widjis/rgb-sleep-lamp/electronic-design/revisions/1/HEADER-PINOUT.txt

Expansion headers - 2026-10-26

{
  "J6": [
    "BOOT_GPIO0",
    "GPIO2",
    "GPIO4",
    "GPIO5",
    "GPIO12",
    "GPIO13",
    "GPIO14",
    "GPIO15"
  ],
  "J7": [
    "GPIO16",
    "ADC",
    "ESP_EN",
    "RESET_N",
    "UART_TX",
    "UART_RX",
    "+3.3V",
    "GND"
  ]
}

Both headers 1x08,2.54mm. Pin1 is square PCB pad. J6 pin1 is GPIO0.
J7 TX/RX names are from ESP perspective: external TX connects to UART_RX.
GPIO0/2/15 are boot straps: external peripherals must preserve required reset levels.
ADC is native ESP8266 ADC input, nominal full scale1.0V; no divider/protection added. UART/GPIO logic3.3V.
GPIO6-11 /CS0,MISO,MOSI,SCLK,GPIO9,GPIO10 remain internal flash signals, not exposed.
+3.3V on J7 is regulated rail; do not feed battery/5V or a second active supply into it.
Native-save both sheets,ERC0warnings0errors,pad/netmapping verified42footprints; preserved40originalpositionsand0tracks.
DRC retains2pre-existing U1 silkscreen/edge violations;97unrouteditems expected. No new header geometry violations.
Existing donor footprint and power/thermal limitations remain.
