widjis/rgb-sleep-lamp/electronic-design/revisions/4/fabrication/20261030-E4/review/drill-report.txt

Drill report for circuit.kicad_pcb
Created on 2026-10-30T22:11:47

Copper Layer Stackup:
    =============================================================
    L1 :  F.Cu                      front
    L2 :  B.Cu                      back

Drill file 'circuit-PTH.drl' contains
    plated through holes:
    =============================================================
    T1  0.600mm  0.0236"  (34 holes))
    T2  0.800mm  0.0315"  (4 holes))
    T3  1.000mm  0.0394"  (24 holes))
    T4  1.150mm  0.0453"  (4 holes))
    T5  1.200mm  0.0472"  (3 holes))

    Total plated holes count 69

Drill file 'circuit-NPTH.drl' contains
    unplated through holes:
    =============================================================
    T1  3.200mm  0.1260"  (3 holes))

    Total unplated holes count 3
