widjis/rgb-sleep-lamp/documentation/attachments/0b8d95f3621441ebba49acbfaca555f7.png

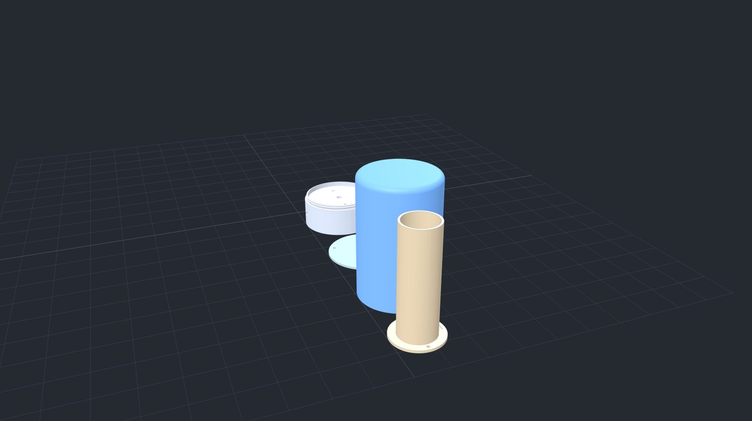
documentation/attachments/0b8d95f3621441ebba49acbfaca555f7.png
