widjis/rgb-sleep-lamp/documentation/attachments/3bc8e283bf60432a83f4a50ec003262f.png

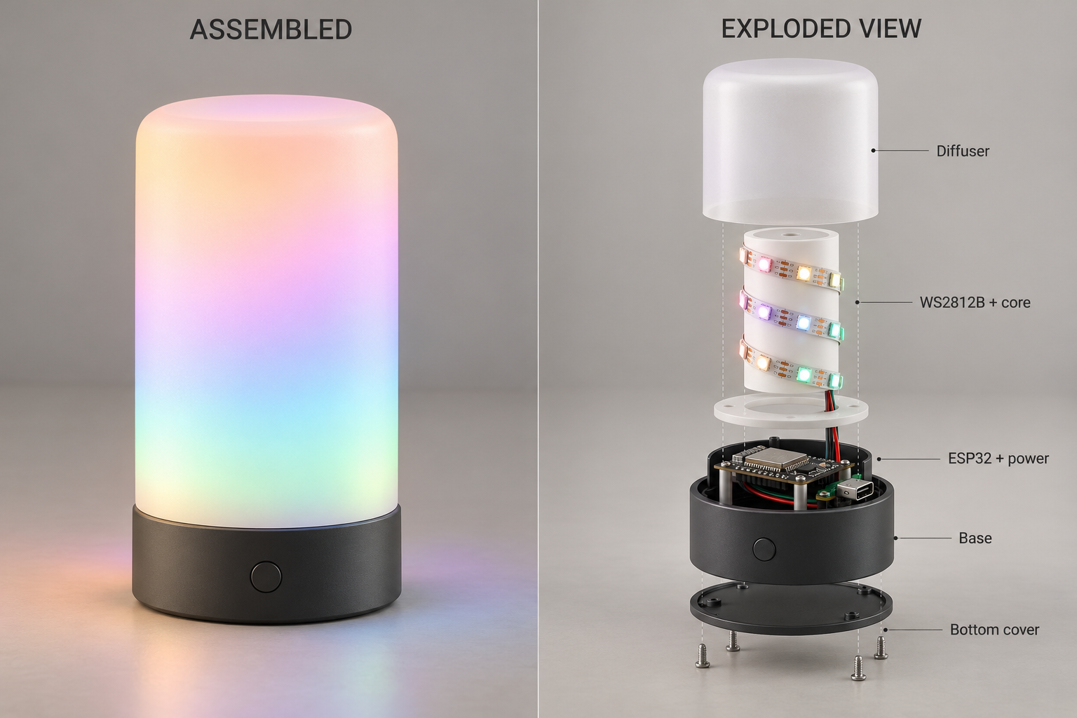
documentation/attachments/3bc8e283bf60432a83f4a50ec003262f.png
