widjis/rgb-sleep-lamp/documentation/attachments/4e88c0c15cba410885349178ead8f457.png

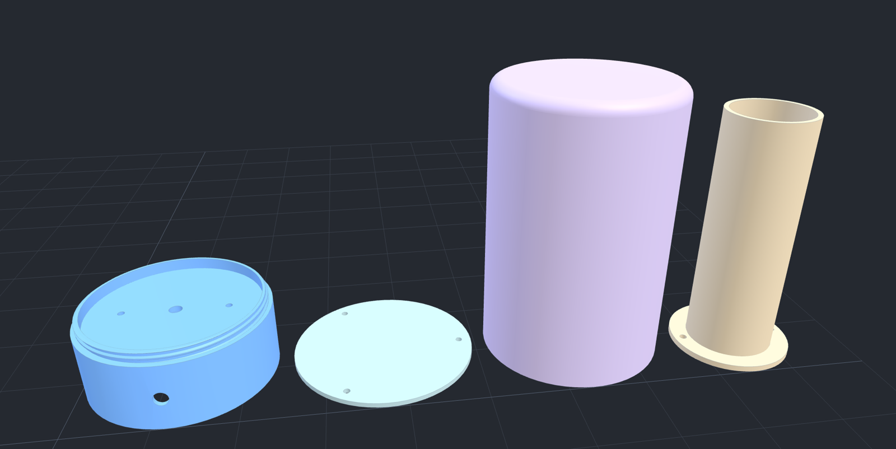
documentation/attachments/4e88c0c15cba410885349178ead8f457.png
