widjis/rgb-sleep-lamp/documentation/attachments/6b8971b305ce40e88919e2f2e205ed5f.png

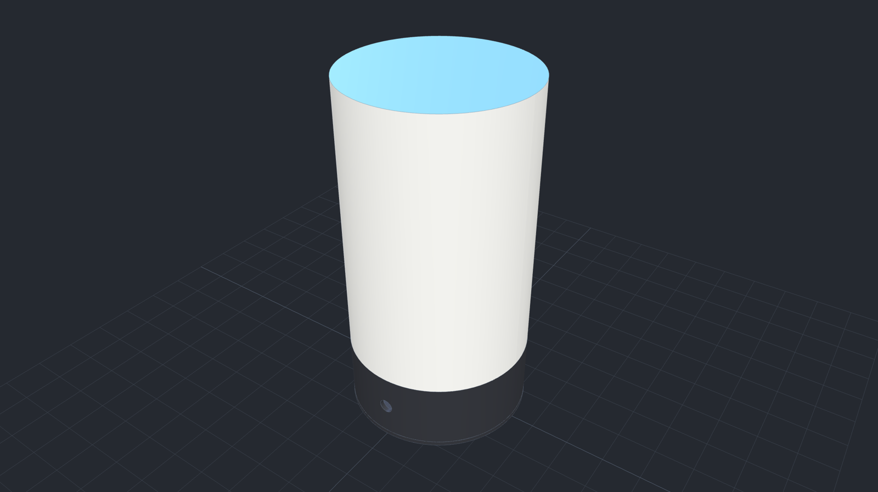
documentation/attachments/6b8971b305ce40e88919e2f2e205ed5f.png
