widjis/rgb-sleep-lamp/documentation/attachments/38d6d0ee4d35420595f7a81d190b29fc.png

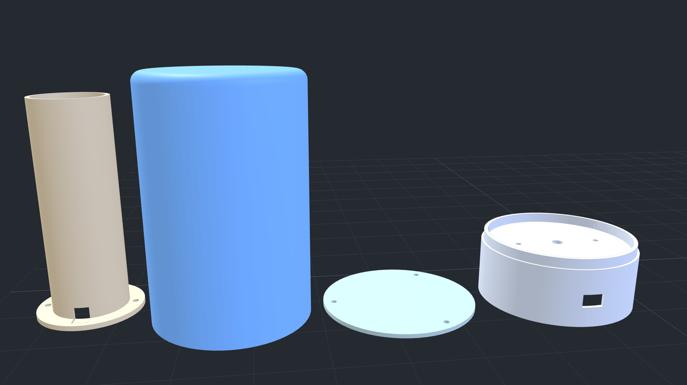
documentation/attachments/38d6d0ee4d35420595f7a81d190b29fc.png
