widjis/rgb-sleep-lamp/documentation/attachments/47f0a28b433d42219f5dcdfafbd3d39e.png

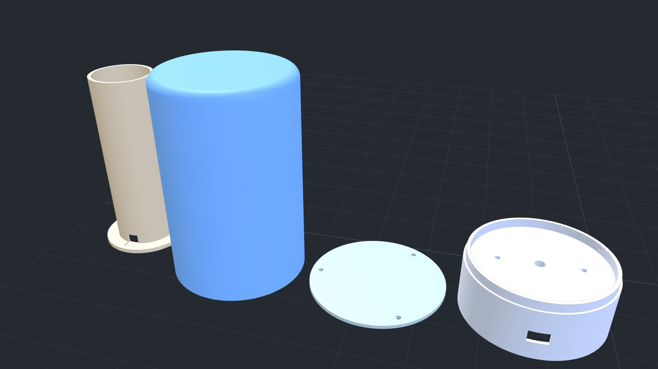
documentation/attachments/47f0a28b433d42219f5dcdfafbd3d39e.png
