widjis/rgb-sleep-lamp/documentation/attachments/359af76d811147eabba4ed6af1c6f636.png

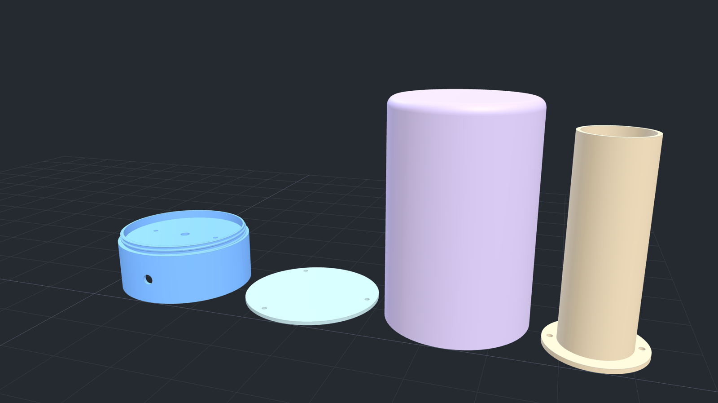
documentation/attachments/359af76d811147eabba4ed6af1c6f636.png
