widjis/rgb-sleep-lamp/documentation/attachments/012442a0ce6f4eaabcbf1c611c599270.png

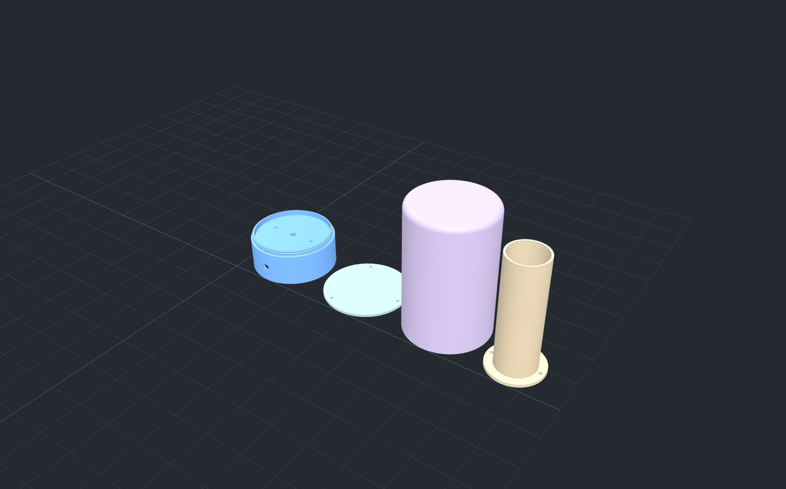
documentation/attachments/012442a0ce6f4eaabcbf1c611c599270.png
