widjis/rgb-sleep-lamp/documentation/attachments/bc02a46fa71b4df2939bb1dc65fdb123.png

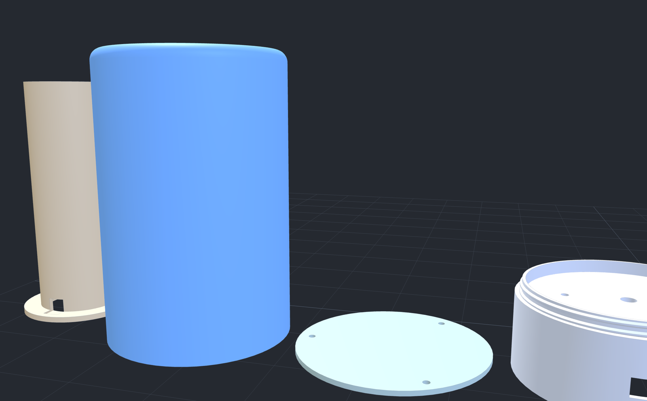
documentation/attachments/bc02a46fa71b4df2939bb1dc65fdb123.png
