widjis/rgb-sleep-lamp/documentation/attachments/ce138700706f45a0bd5461e80fa7ac32.png

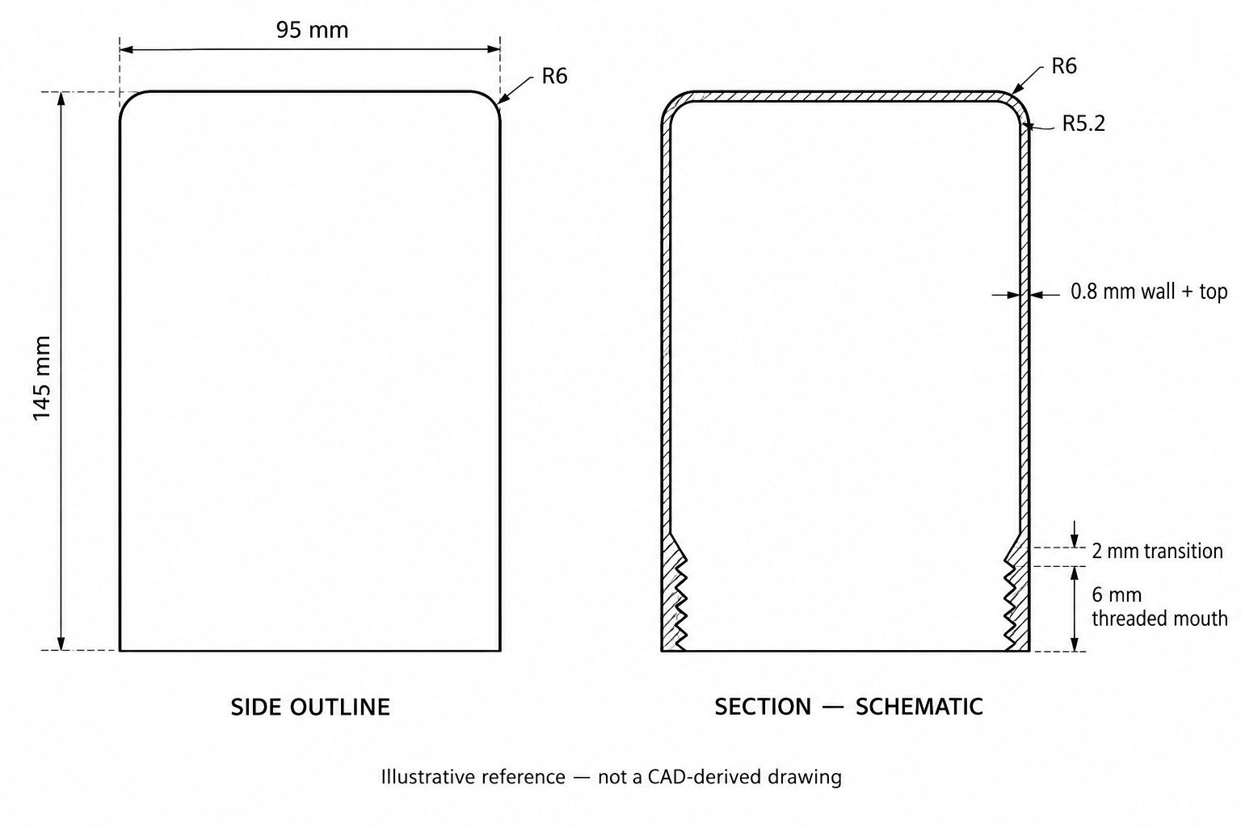
documentation/attachments/ce138700706f45a0bd5461e80fa7ac32.png
