widjis/rgb-sleep-lamp/documentation/attachments/d6e5daed313f4155918ada291e81fe91.png

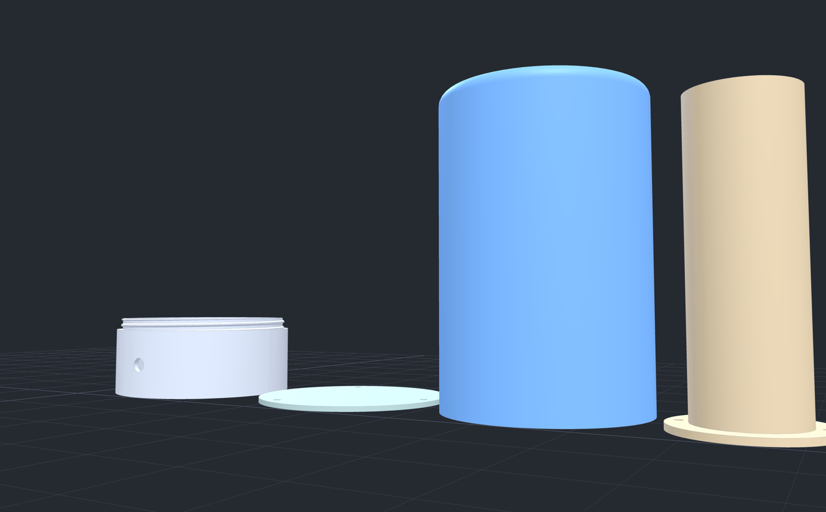
documentation/attachments/d6e5daed313f4155918ada291e81fe91.png
