widjis/rgb-sleep-lamp/documentation/attachments/fecc856e2a63408f98bc8c1cb8a409b4.png

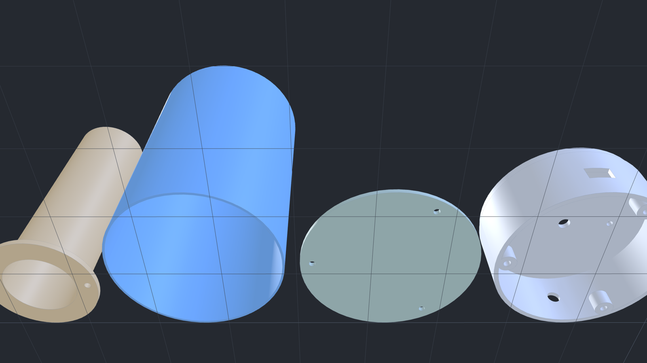
documentation/attachments/fecc856e2a63408f98bc8c1cb8a409b4.png
