widjis/rgb-sleep-lamp/documentation/checks/r9-pcb-and-led/pcb-layout-preview.svg.png

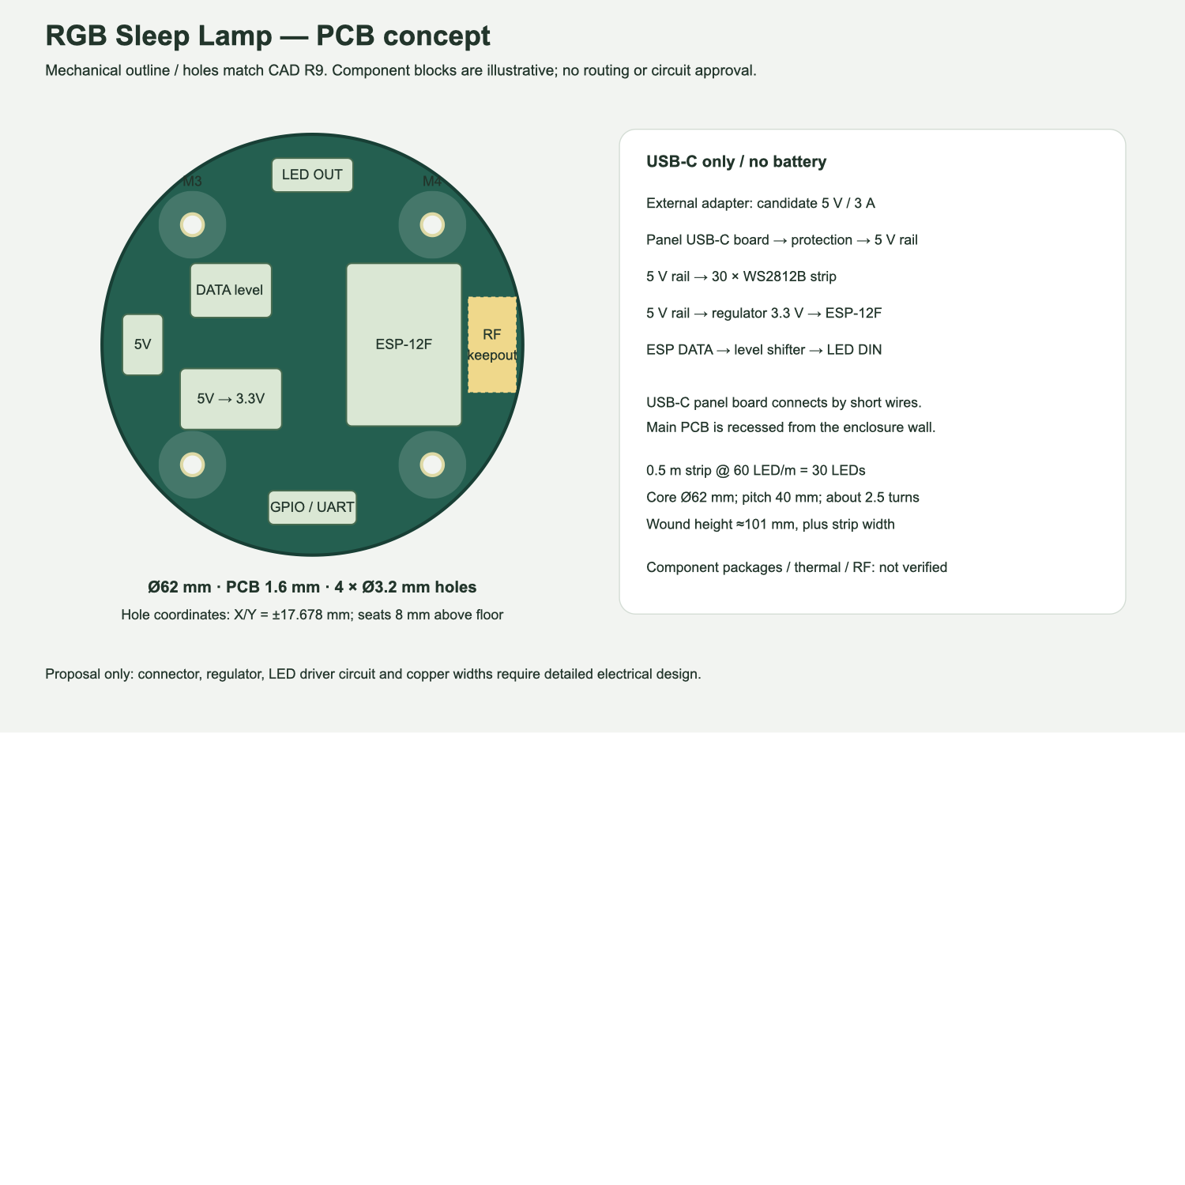
documentation/checks/r9-pcb-and-led/pcb-layout-preview.svg.png
