widjis/rgb-sleep-lamp/electronic-design/revisions/2/schematic-1.png

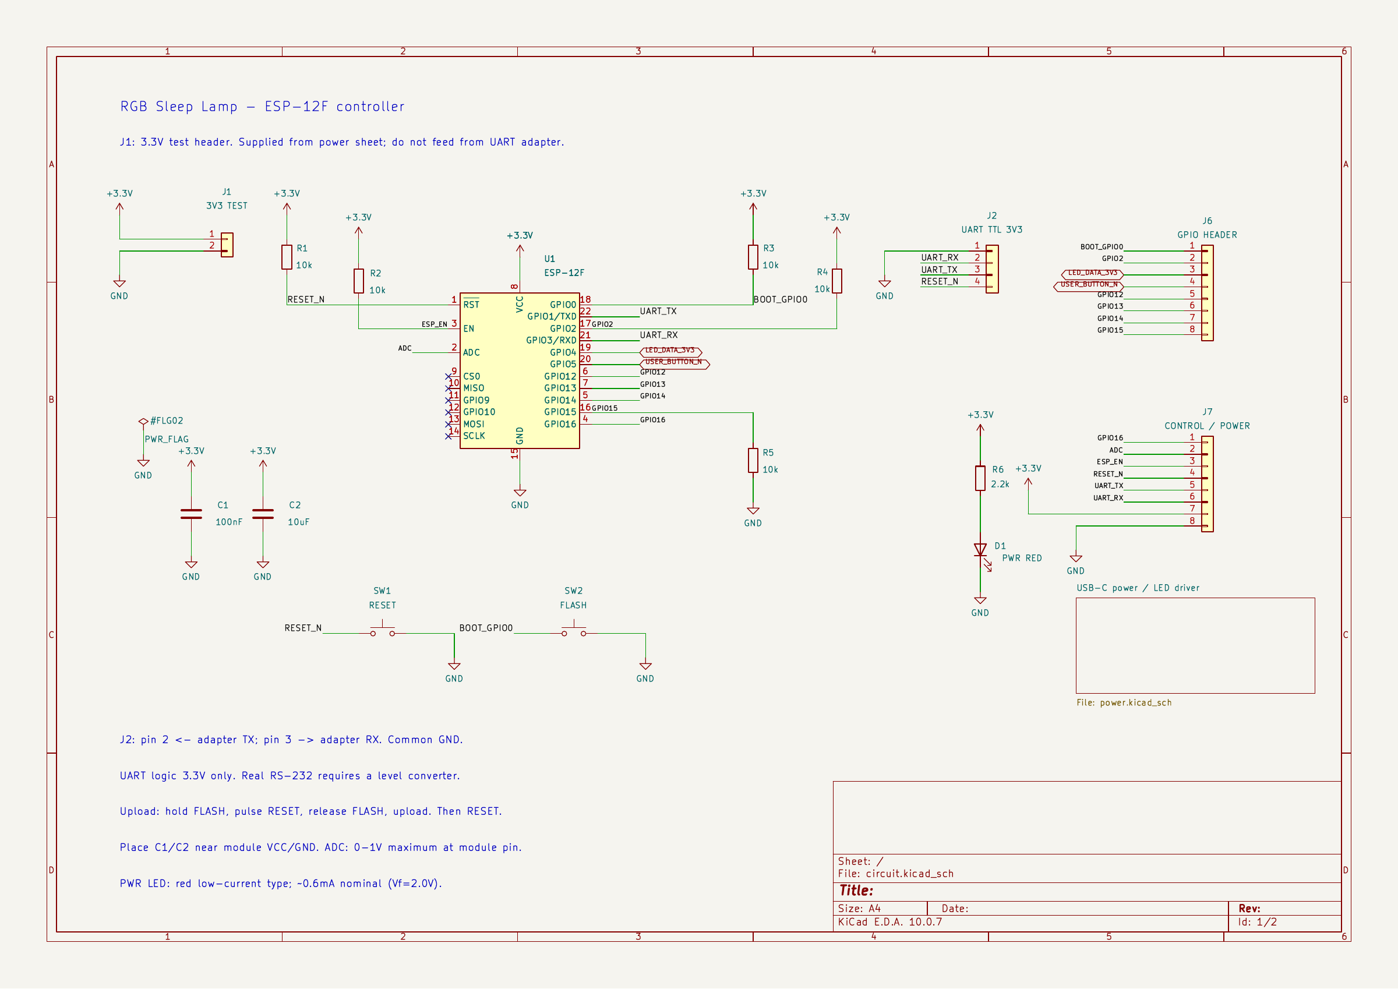
electronic-design/revisions/2/schematic-1.png
