widjis/rgb-sleep-lamp/electronic-design/revisions/2/schematic-2.png

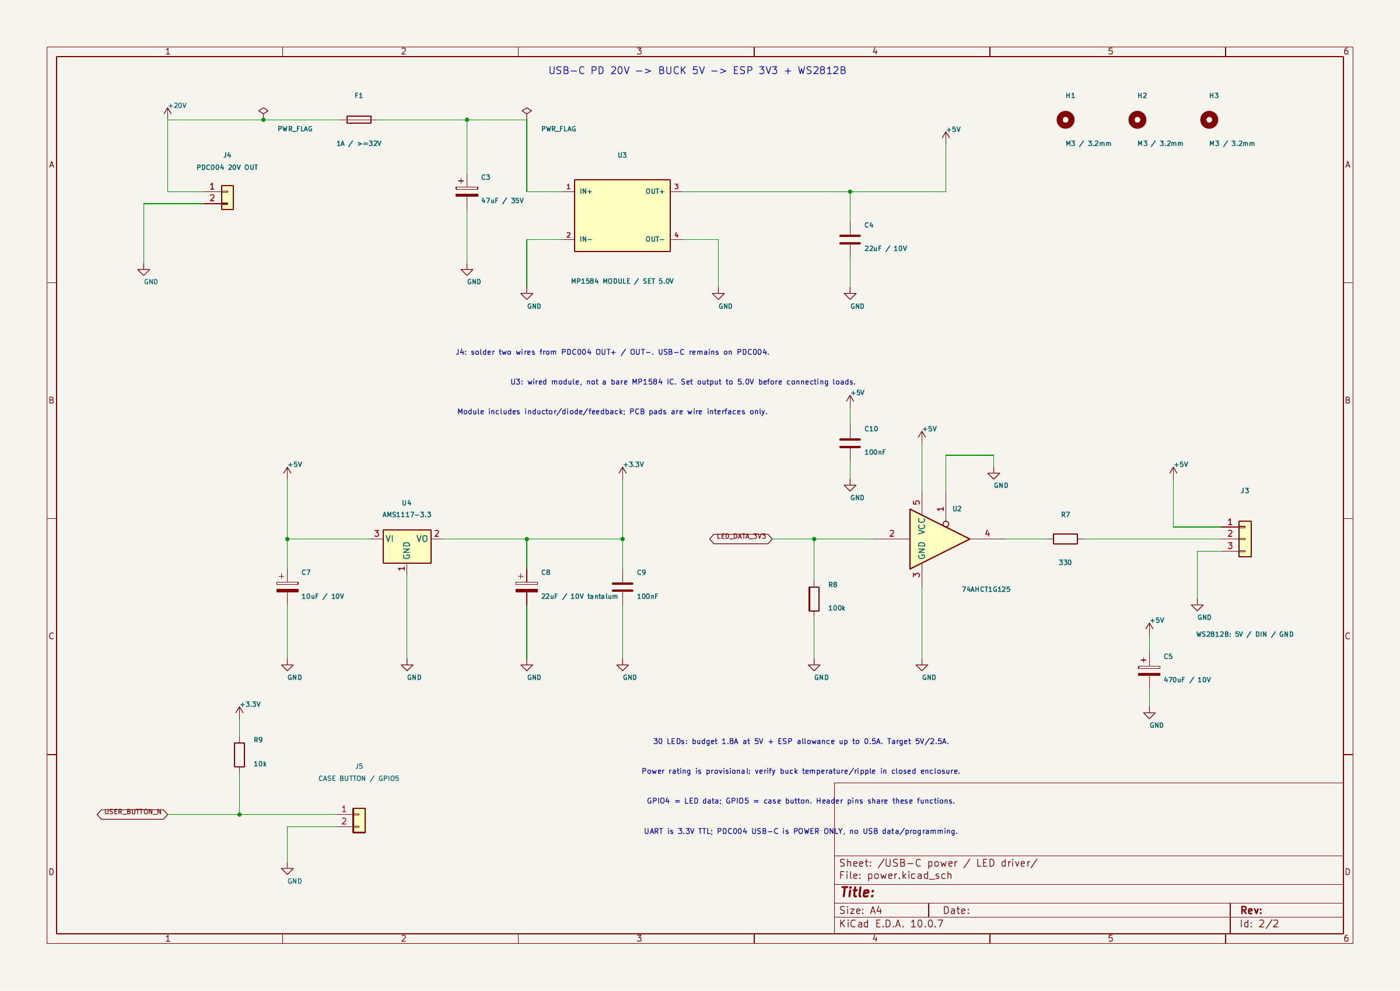
electronic-design/revisions/2/schematic-2.png
