widjis/rgb-sleep-lamp/electronic-design/revisions/3/schematic-1.png

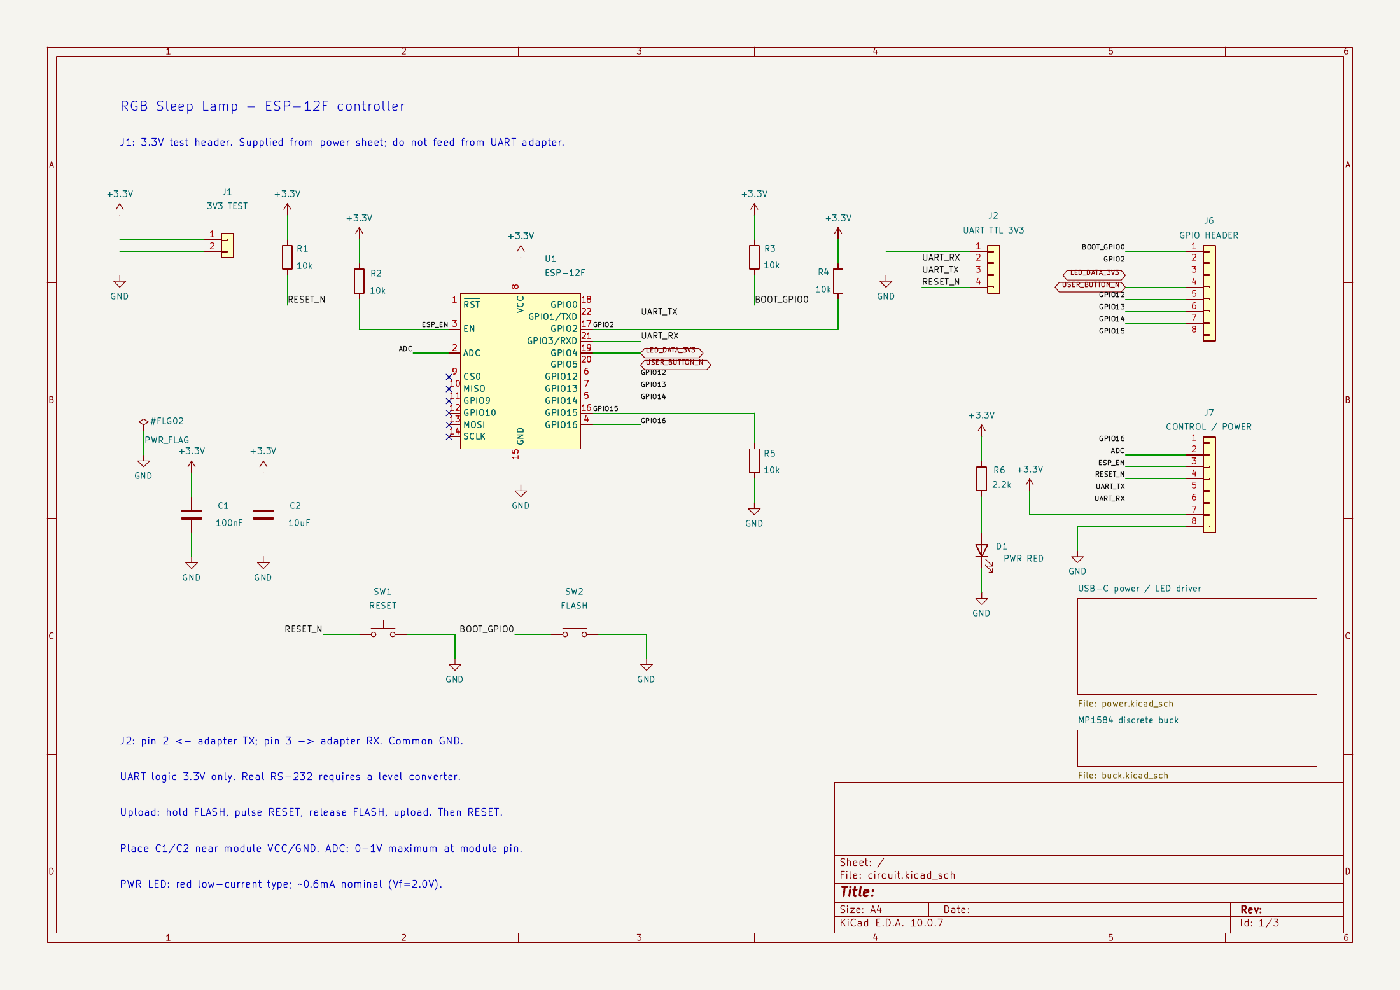
electronic-design/revisions/3/schematic-1.png
