widjis/rgb-sleep-lamp/electronic-design/revisions/3/schematic-2.png

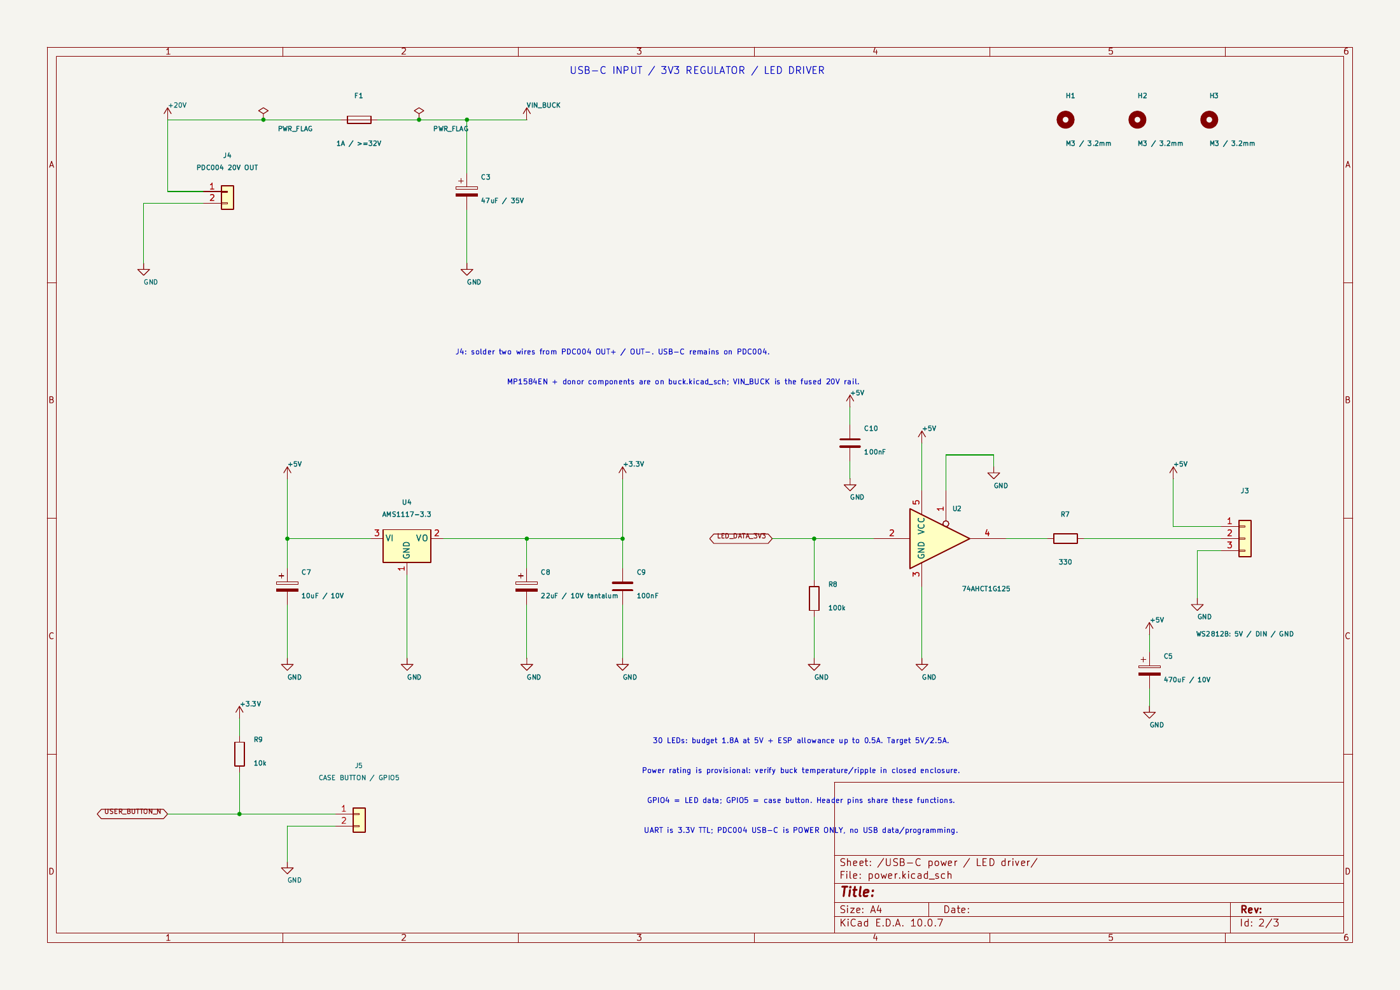
electronic-design/revisions/3/schematic-2.png
