widjis/rgb-sleep-lamp/electronic-design/revisions/3/schematic-3.png

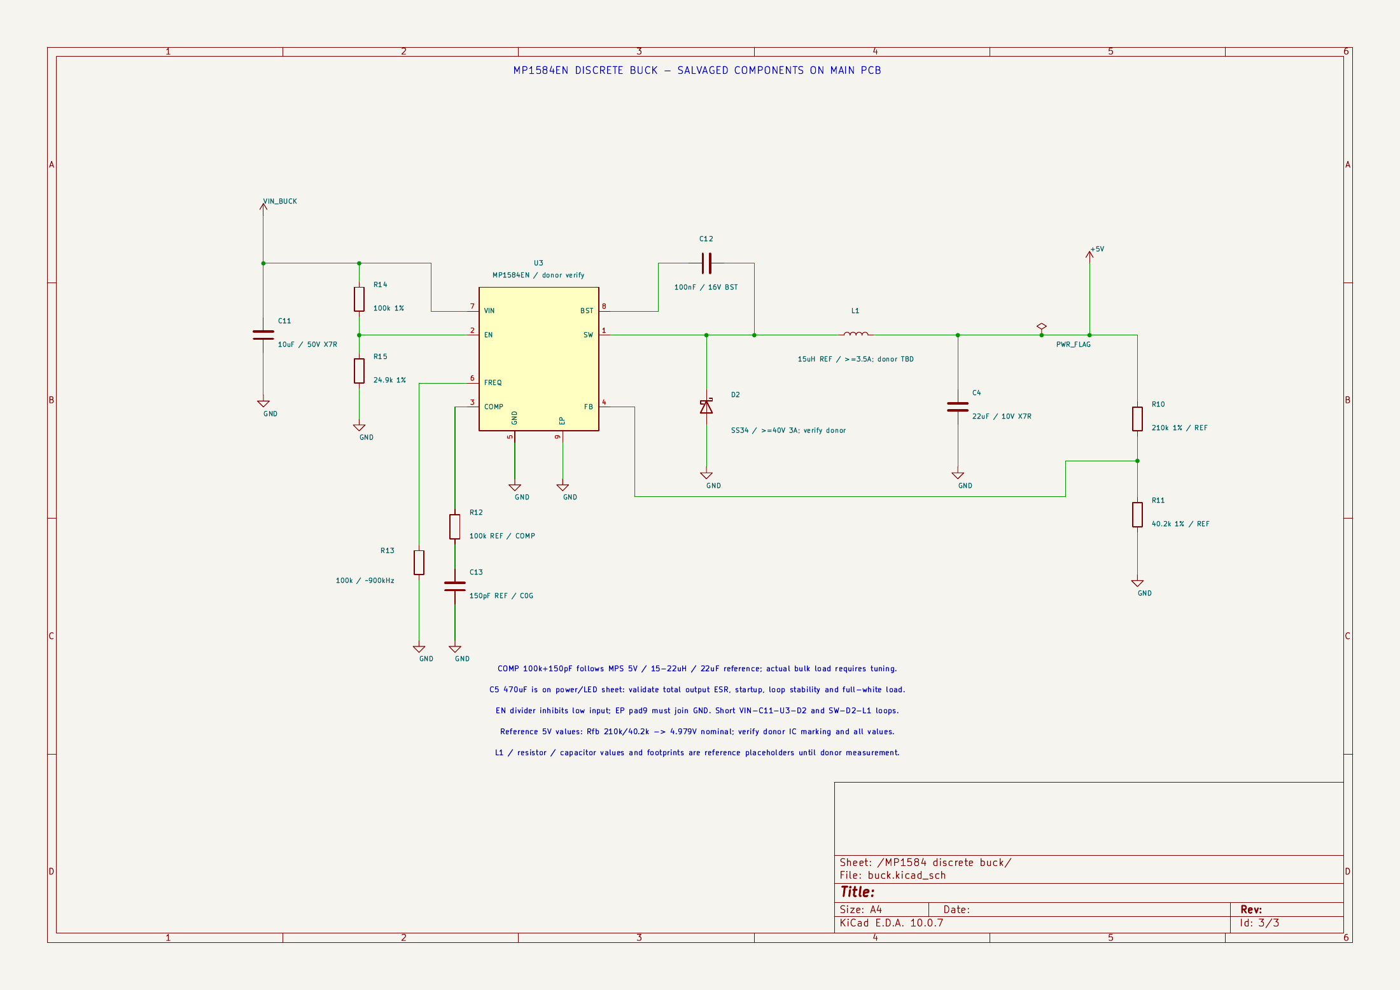
electronic-design/revisions/3/schematic-3.png
