widjis/rgb-sleep-lamp/mechanical/freecad/base-chamfer-preview.png

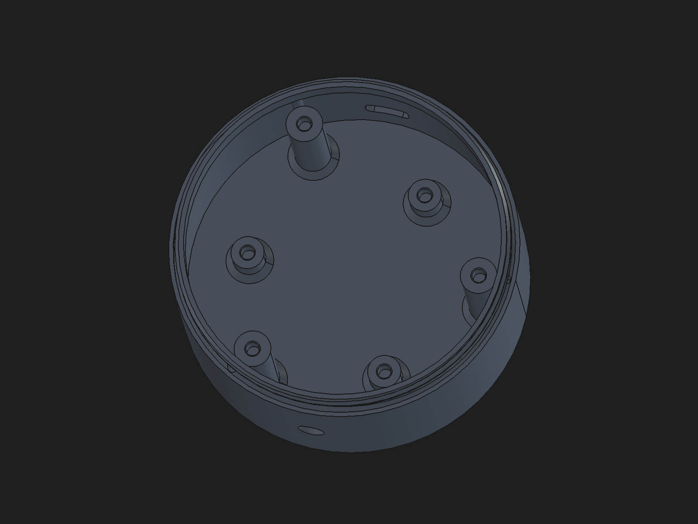
mechanical/freecad/base-chamfer-preview.png
