widjis/rgb-sleep-lamp/mechanical/freecad/locator-fixed-detail.png

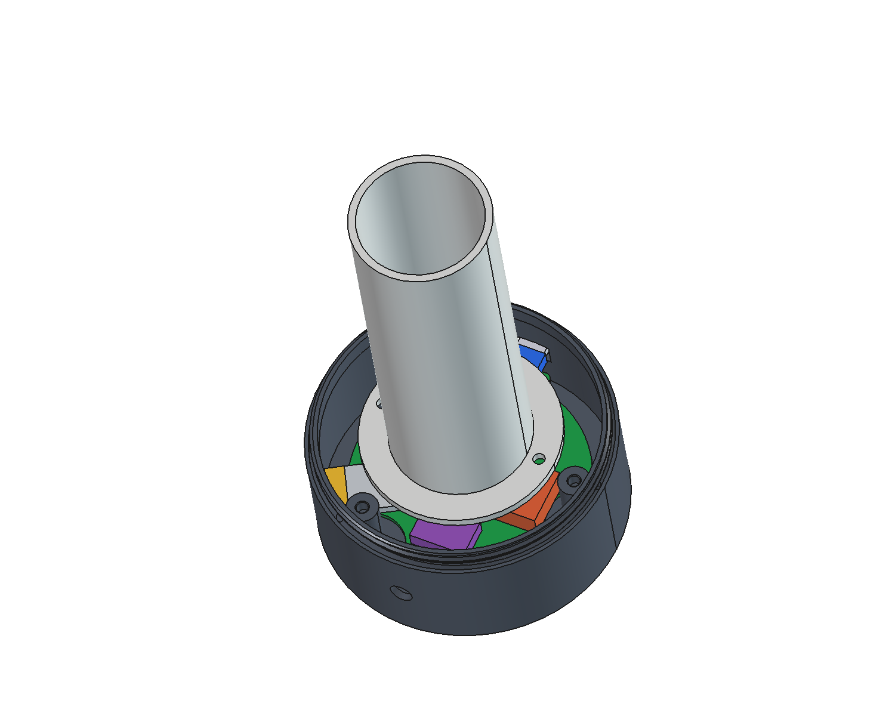
mechanical/freecad/locator-fixed-detail.png
