widjis/rgb-sleep-lamp/mechanical/freecad/placement-top.png

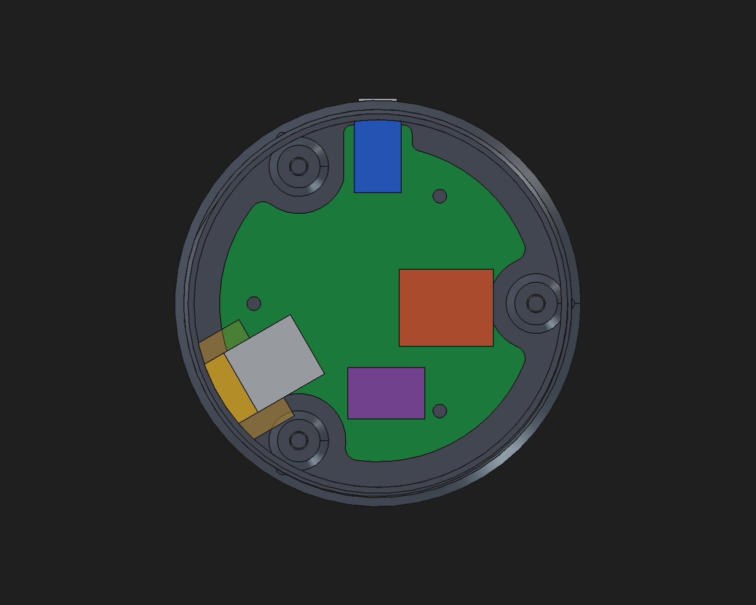
mechanical/freecad/placement-top.png
