widjis/rgb-sleep-lamp/mechanical/freecad/usb-fit-preview.png

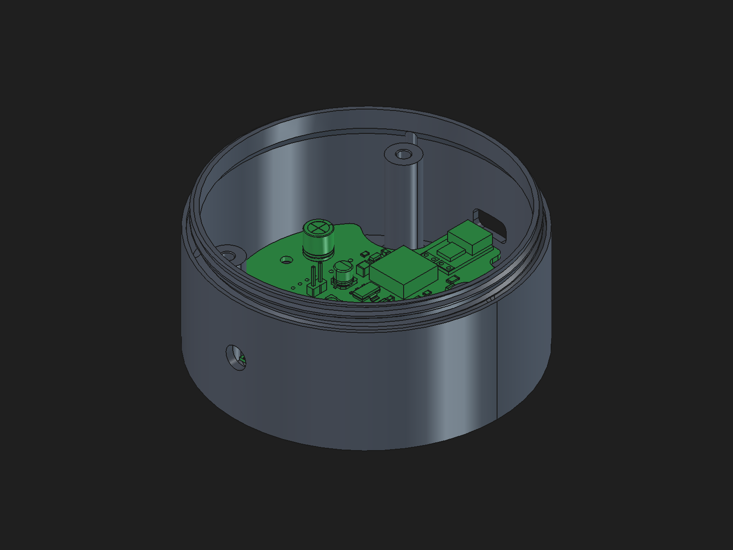
mechanical/freecad/usb-fit-preview.png
