widjis/rgb-sleep-lamp/mechanical/revisions/8/assembly.step

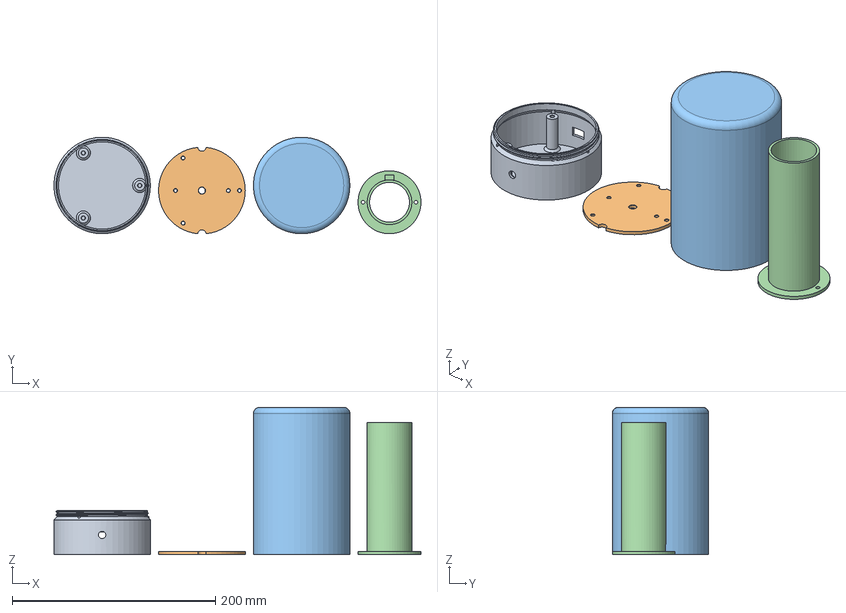
[picture p27: CAD file, 2026-11-01]
mechanical/revisions/8/assembly.step
361.3 x 95.0 x 145.0 mm
