widjis/rgb-sleep-lamp/electronic-design/revisions/4/circuit-assembled.step

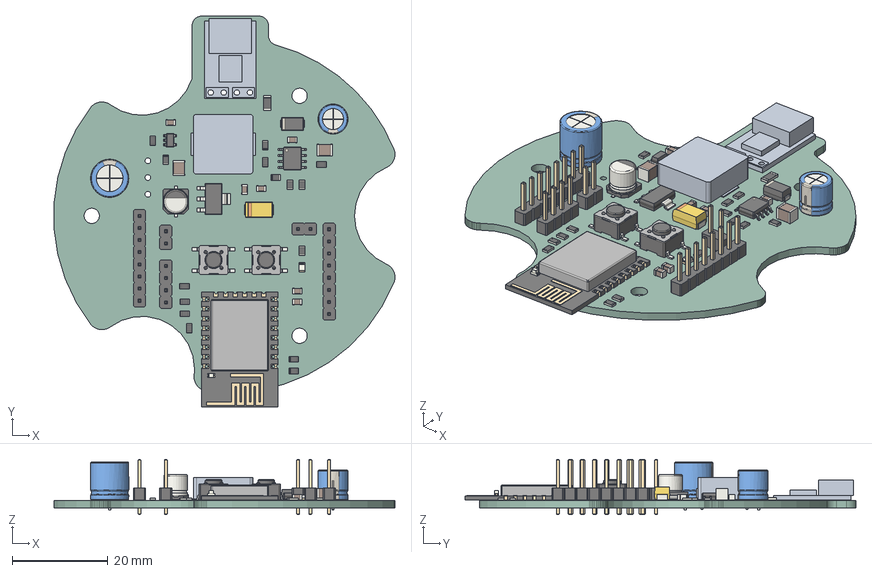
[picture p28: CAD file, 2026-11-01]
electronic-design/revisions/4/circuit-assembled.step
71.4 x 81.8 x 11.5 mm
R_0805_2012Metric x 15
D_SMA
CP_Radial_D63mm_P250mm
CP_Elec_5x54
SOIC-8-1EP_3.9x4.9mm_P1.27mm_EP2.41x3.81mm
C_0805_2012Metric x 6
SW_SPST_PTS645Sx43SMTR92 x 2
PinHeader_1x02_P254mm_Vertical x 2
Fuse_1206_3216Metric
C_1210_3225Metric x 2
MagneticCore
Terminal1
Terminal2
PinHeader_1x08_P254mm_Vertical x 2
PinHeader_1x04_P254mm_Vertical
SOT-223
LED_0805_2012Metric
SOT-23-5
CP_EIA_6032_28_Kemet_C
CP_Radial_D80mm_P350mm
ESP_12E001_cp
circuit_PCB
