widjis/rgb-sleep-lamp/mechanical/revisions/2/assembly.step

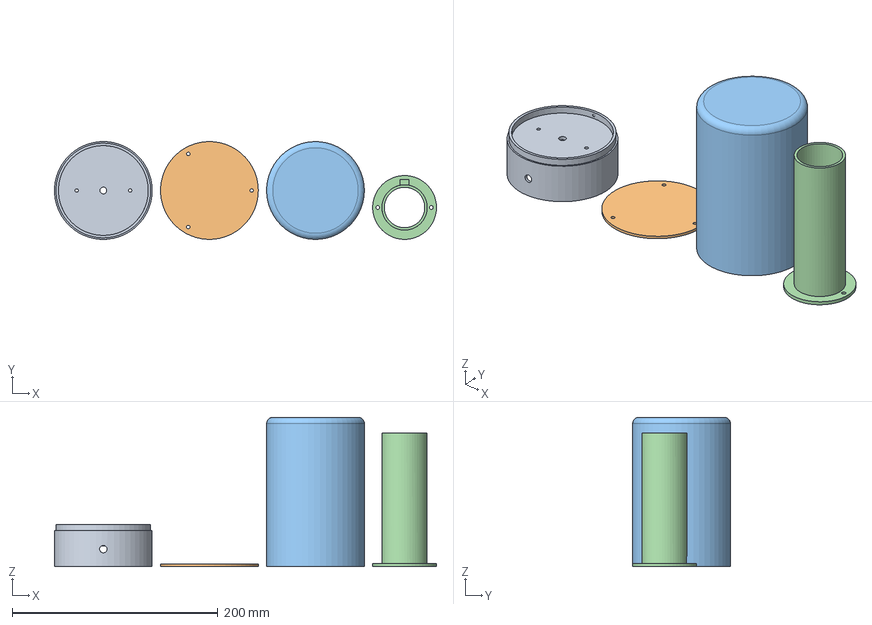
[picture p29: CAD file, 2026-11-01]
mechanical/revisions/2/assembly.step
370.9 x 95.0 x 145.0 mm
