widjis/rgb-sleep-lamp/mechanical/revisions/6/assembly.step

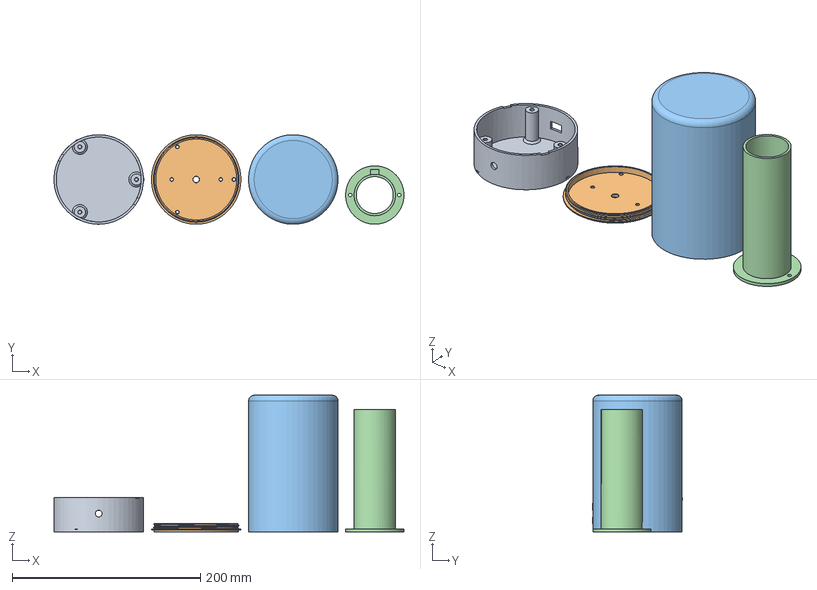
[picture p30: CAD file, 2026-11-01]
mechanical/revisions/6/assembly.step
371.4 x 95.0 x 145.0 mm
