widjis/rgb-sleep-lamp/mechanical/revisions/1/assembly.step

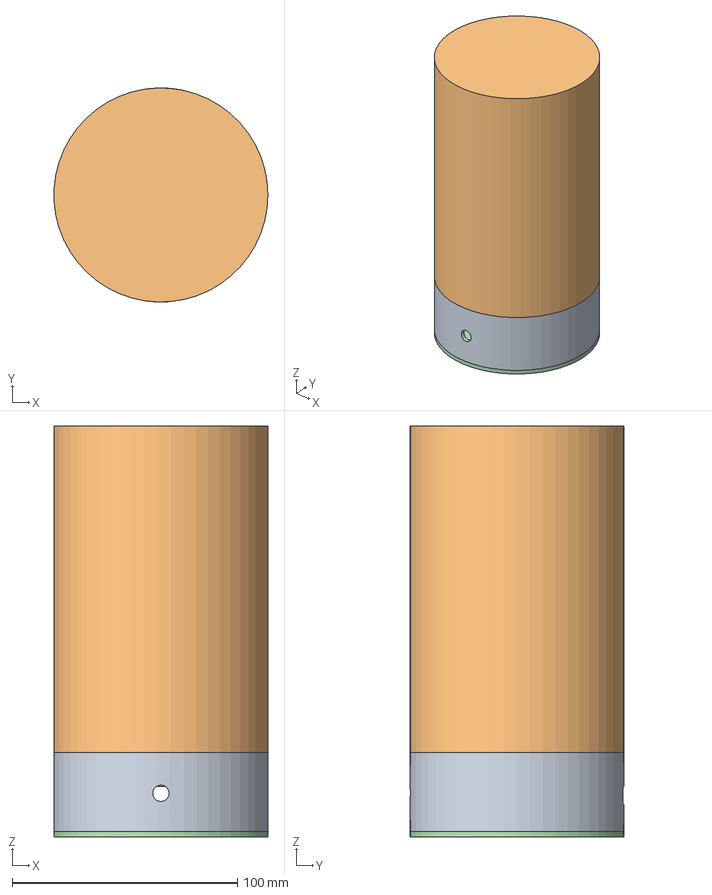
[picture p31: CAD file, 2026-11-01]
mechanical/revisions/1/assembly.step
94.9 x 95.0 x 182.4 mm
