widjis/rgb-sleep-lamp/mechanical/freecad/NativeAssemblyTest.FCStd

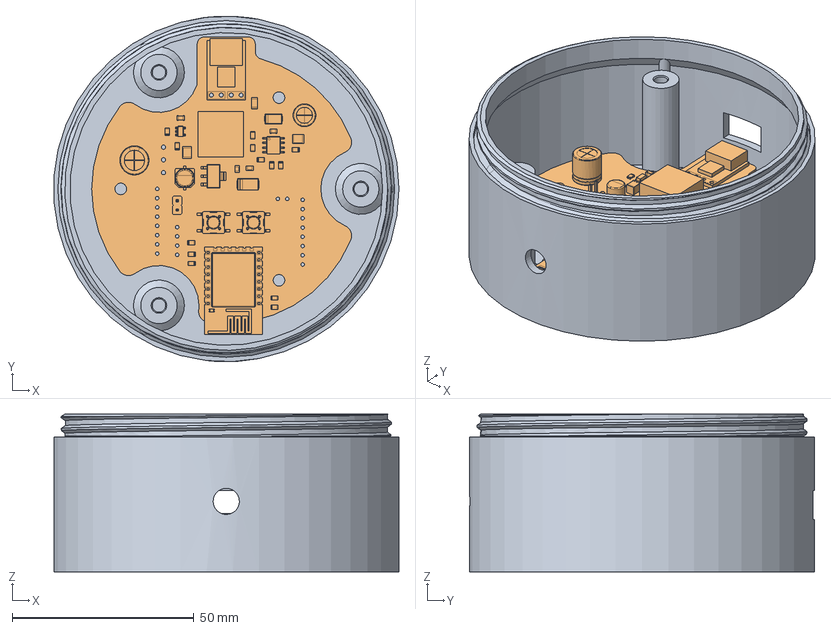
[picture p32: CAD file, 2026-11-01]
mechanical/freecad/NativeAssemblyTest.FCStd
94.9 x 95.0 x 43.4 mm
BaseFlushLocators
PCB_KiCad_Actual
