widjis/rgb-sleep-lamp/mechanical/freecad/before-full-locator-cleanup.FCStd

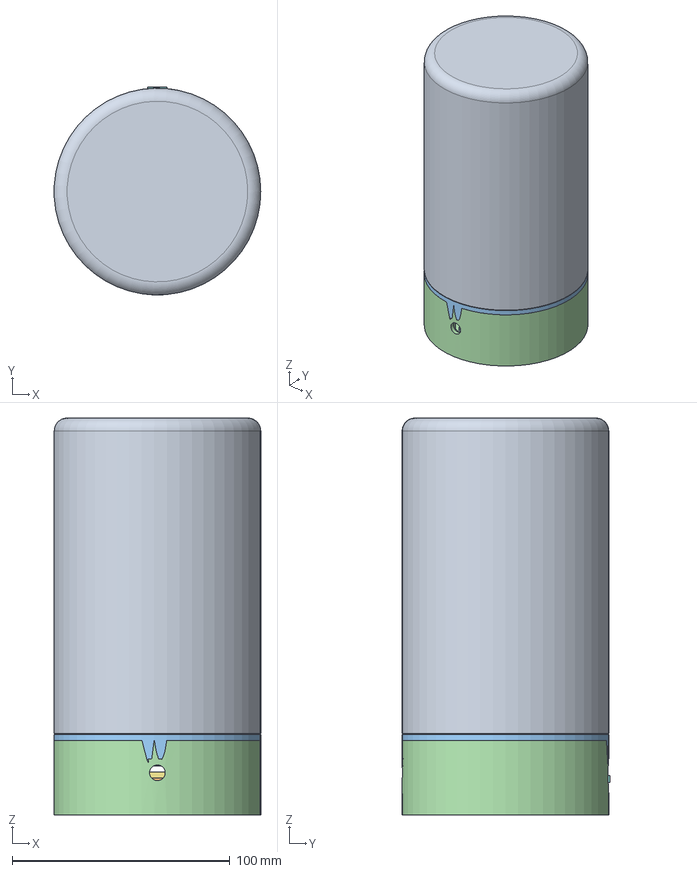
[picture p33: CAD file, 2026-11-01]
mechanical/freecad/before-full-locator-cleanup.FCStd
94.9 x 95.5 x 182.4 mm
diffuser - imported R9
led_core - imported R9
PCB - three M3 screws, USB-C support tongue
Base - 3 PCB supports between cover posts
ESP-12F 24x16x3 - antenna outward
Antenna end reference - no copper under/around (verify artwork)
PDC004 fixed20V - provisional reserve18x11x5mm
USB-C port envelope - provisional
20V to 5V buck reserved zone - part TBD
3V3 regulator + LED data level shifter reserve
Base - exposed locator tips trimmed below seam
