widjis/rgb-sleep-lamp/documentation/checks/diffuser-r8/diffuser-r8-top-down-snug.3mf

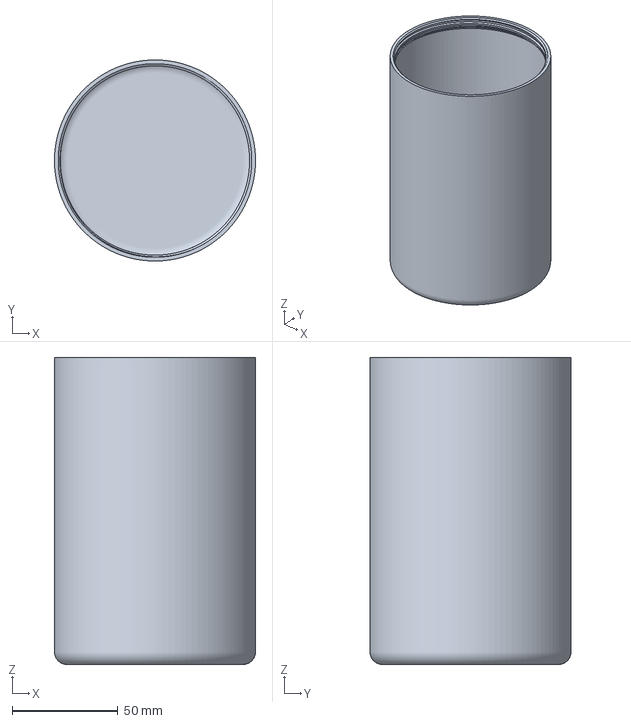
[picture p34: CAD file, 2026-11-01]
documentation/checks/diffuser-r8/diffuser-r8-top-down-snug.3mf
95.0 x 95.0 x 145.0 mm
