widjis/rgb-sleep-lamp/electronic-design/revisions/4/models/C_0805_2012Metric.step

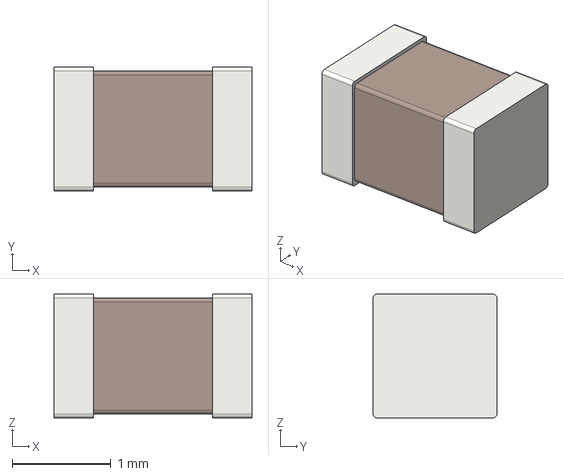
[picture p35: CAD file, 2026-11-01]
electronic-design/revisions/4/models/C_0805_2012Metric.step
2.00 x 1.25 x 1.25 mm
