widjis/rgb-sleep-lamp/electronic-design/revisions/4/PDC004_estimate.step

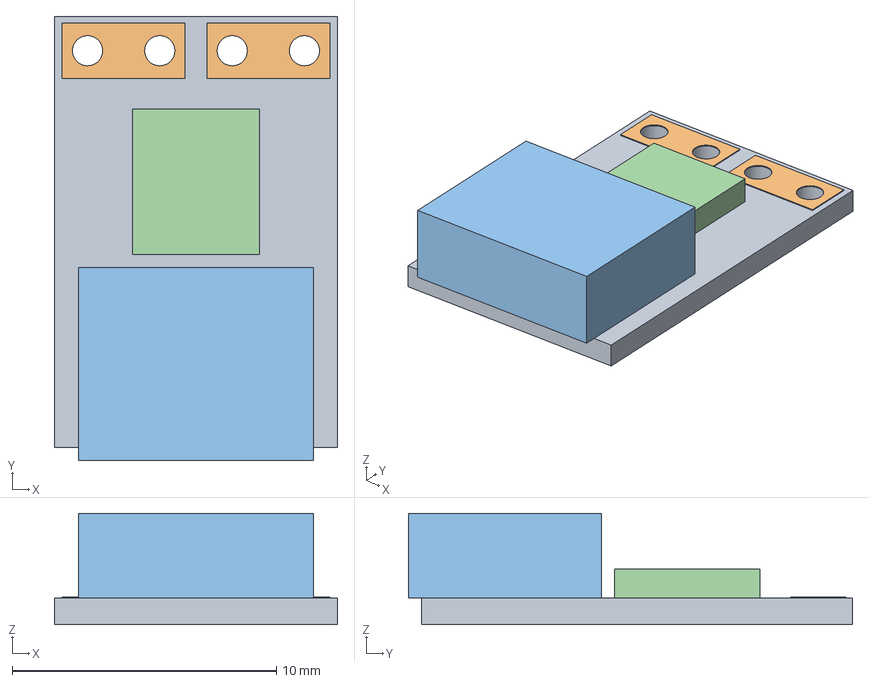
[picture p36: CAD file, 2026-11-01]
electronic-design/revisions/4/PDC004_estimate.step
10.7 x 16.8 x 4.20 mm
