widjis/rgb-sleep-lamp/mechanical/freecad/RGB Sleep Lamp.FCStd

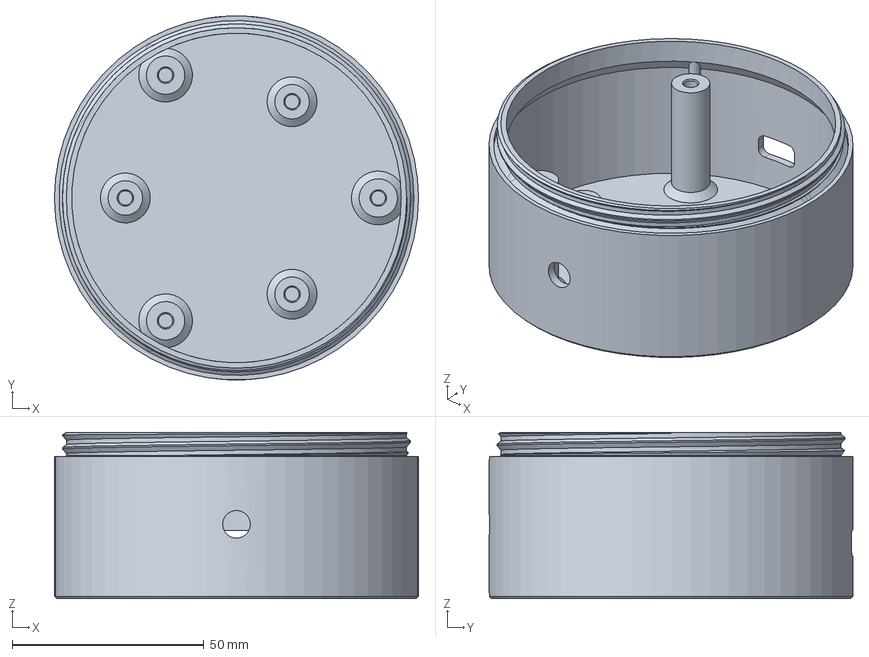
[picture p37: CAD file, 2026-11-01]
mechanical/freecad/RGB Sleep Lamp.FCStd
95.0 x 95.0 x 43.4 mm
