widjis/rgb-sleep-lamp/mechanical/revisions/1/bottom_cover.step

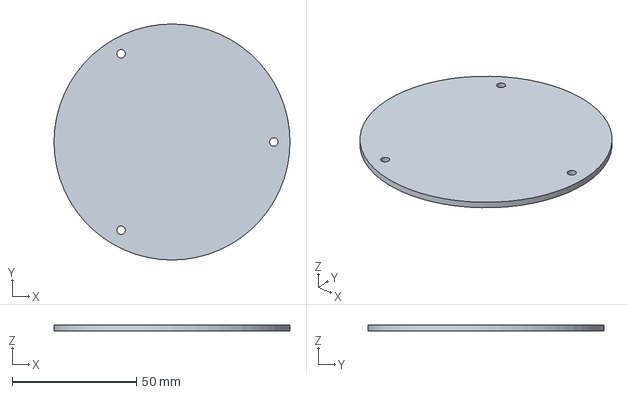
[picture p38: CAD file, 2026-11-01]
mechanical/revisions/1/bottom_cover.step
95.0 x 95.0 x 2.40 mm
