widjis/rgb-sleep-lamp/mechanical/revisions/2/base.step

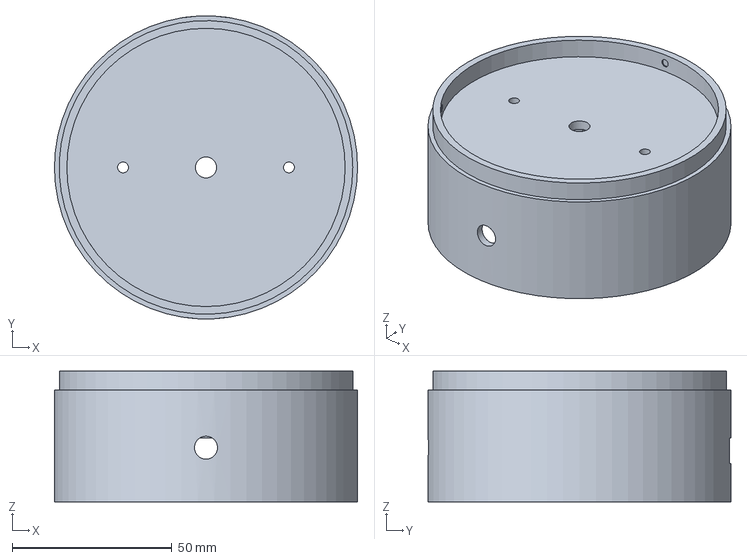
[picture p39: CAD file, 2026-11-01]
mechanical/revisions/2/base.step
95.0 x 94.9 x 41.0 mm
