widjis/rgb-sleep-lamp/mechanical/revisions/3/led_core.step

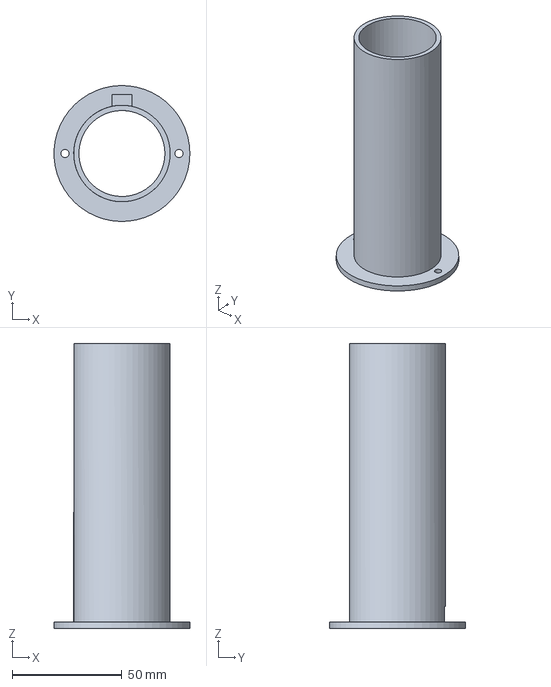
[picture p40: CAD file, 2026-11-01]
mechanical/revisions/3/led_core.step
61.9 x 62.0 x 130.0 mm
