widjis/rgb-sleep-lamp/mechanical/revisions/6/base.step

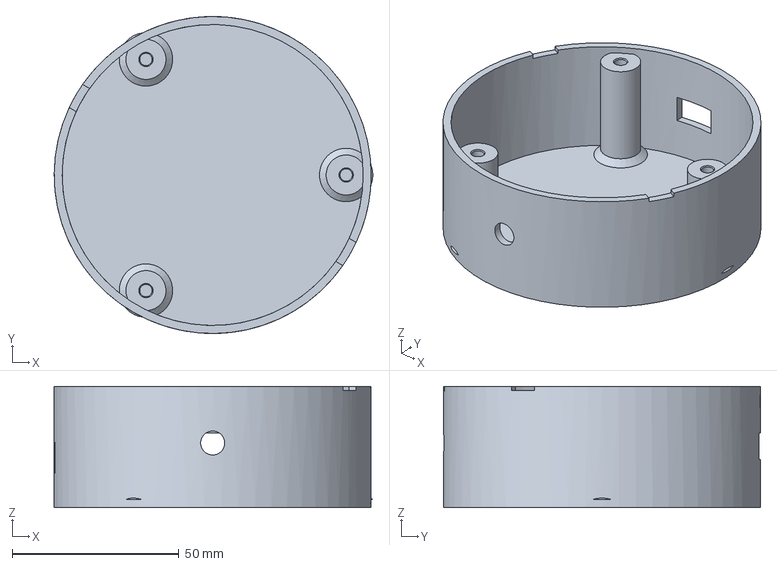
[picture p41: CAD file, 2026-11-01]
mechanical/revisions/6/base.step
95.5 x 95.0 x 36.4 mm
