widjis/rgb-sleep-lamp/mechanical/revisions/7/bottom_cover.step

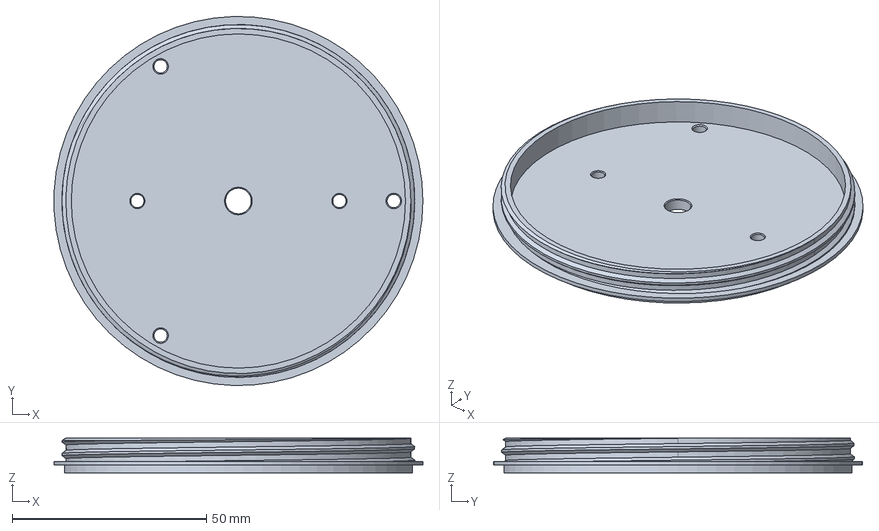
[picture p42: CAD file, 2026-11-01]
mechanical/revisions/7/bottom_cover.step
94.9 x 95.0 x 9.00 mm
