widjis/rgb-sleep-lamp/electronic-design/revisions/4/models/L_SRP1245A_reference.step

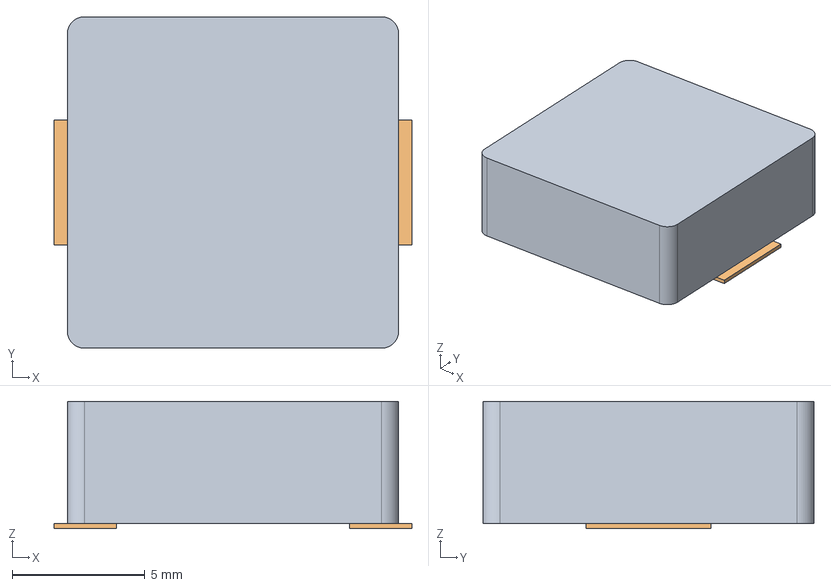
[picture p43: CAD file, 2026-11-01]
electronic-design/revisions/4/models/L_SRP1245A_reference.step
13.5 x 12.5 x 4.80 mm
MagneticCore
Terminal1
Terminal2
