widjis/rgb-sleep-lamp/electronic-design/revisions/5/models/PinHeader_1x04_P2.54mm_Vertical.step

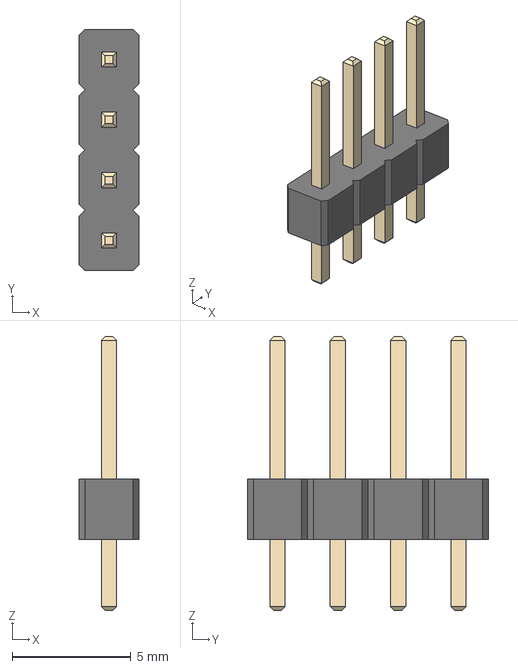
[picture p44: CAD file, 2026-11-01]
electronic-design/revisions/5/models/PinHeader_1x04_P2.54mm_Vertical.step
2.54 x 10.2 x 11.5 mm
