widjis/rgb-sleep-lamp/mechanical/freecad/RGB-Sleep-Lamp-exploded.FCStd

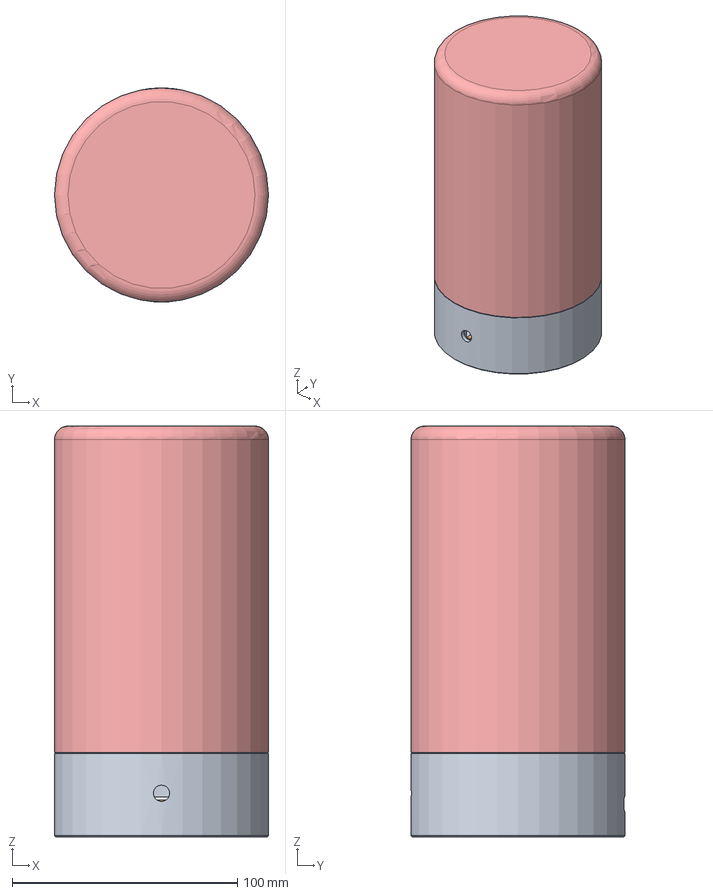
[picture p46: CAD file, 2026-11-01]
mechanical/freecad/RGB-Sleep-Lamp-exploded.FCStd
95.0 x 95.0 x 182.4 mm
Base - locator protrusions fully removed
PCB KiCad actual - provisional component models
bottom_cover - imported R9
led_core - imported R9
diffuser - imported R9
