widjis/rgb-sleep-lamp/mechanical/printing/cover.stl

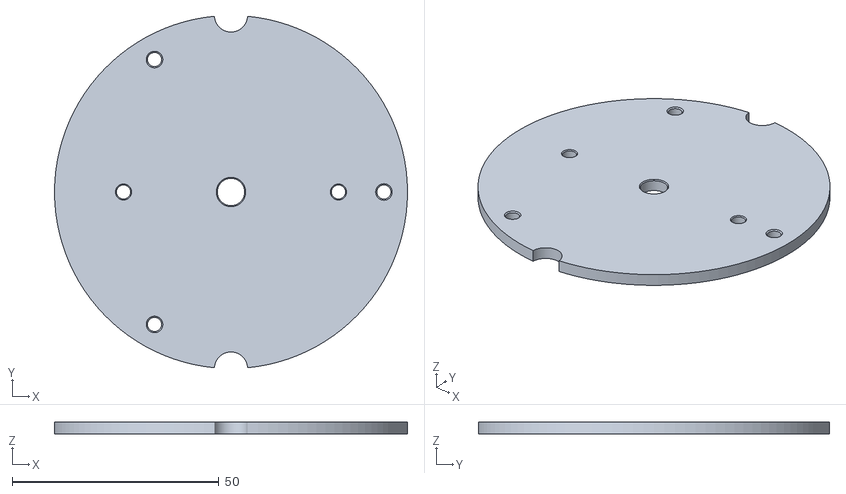
[picture p47: CAD file, 2026-11-01]
mechanical/printing/cover.stl
85.4 x 85.0 x 3.00
