widjis/rgb-sleep-lamp/mechanical/revisions/2/diffuser.step

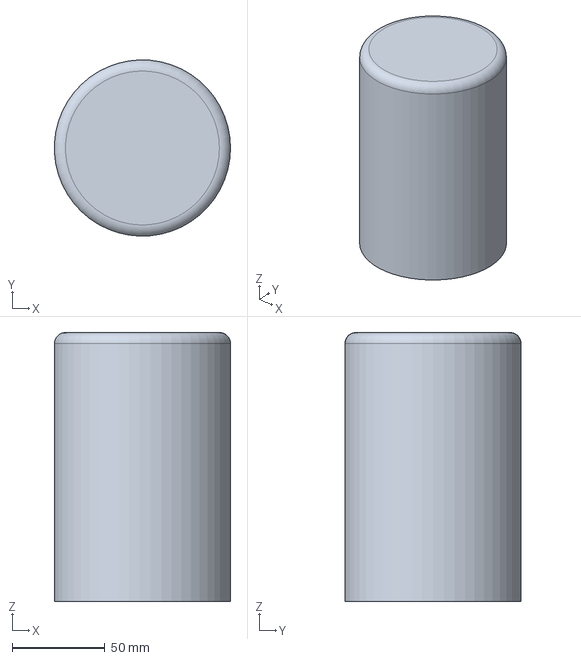
[picture p48: CAD file, 2026-11-01]
mechanical/revisions/2/diffuser.step
94.9 x 95.0 x 145.0 mm
