widjis/rgb-sleep-lamp/mechanical/revisions/8/base.step

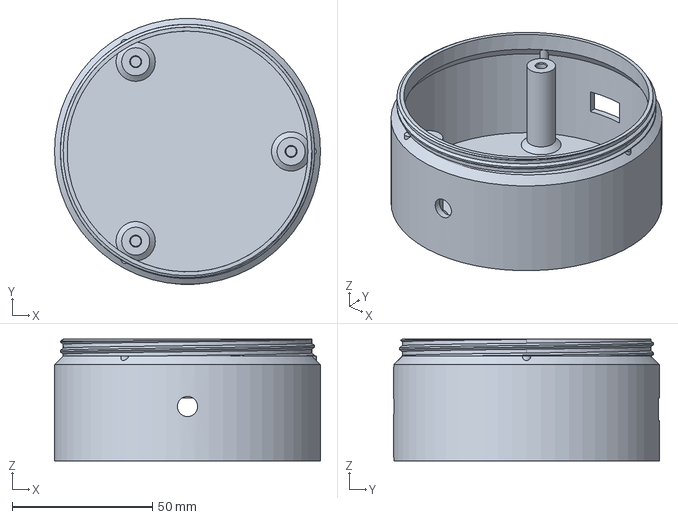
[picture p49: CAD file, 2026-11-01]
mechanical/revisions/8/base.step
95.0 x 95.0 x 43.4 mm
