widjis/rgb-sleep-lamp/electronic-design/revisions/4/models/SOIC-8-1EP_3.9x4.9mm_P1.27mm_EP2.41x3.81mm.step

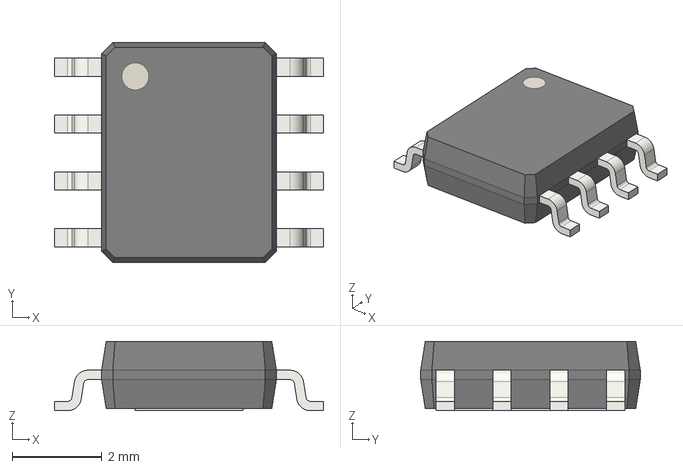
[picture p50: CAD file, 2026-11-01]
electronic-design/revisions/4/models/SOIC-8-1EP_3.9x4.9mm_P1.27mm_EP2.41x3.81mm.step
6.00 x 4.90 x 1.55 mm
