widjis/rgb-sleep-lamp/electronic-design/revisions/5/models/LED_0805_2012Metric.step

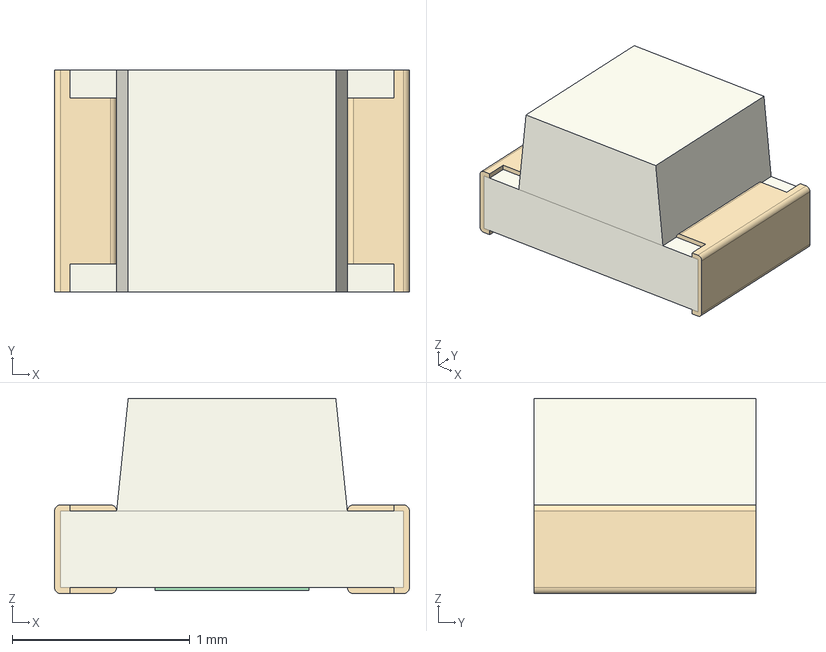
[picture p51: CAD file, 2026-11-01]
electronic-design/revisions/5/models/LED_0805_2012Metric.step
2.00 x 1.25 x 1.10 mm
