widjis/rgb-sleep-lamp/electronic-design/revisions/4/models/R_0805_2012Metric.step

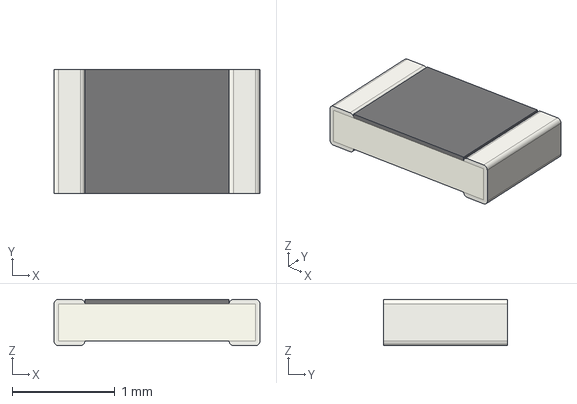
[picture p52: CAD file, 2026-11-01]
electronic-design/revisions/4/models/R_0805_2012Metric.step
2.00 x 1.20 x 0.45 mm
