widjis/rgb-sleep-lamp/electronic-design/revisions/4/models/PinHeader_1x02_P2.54mm_Vertical.step

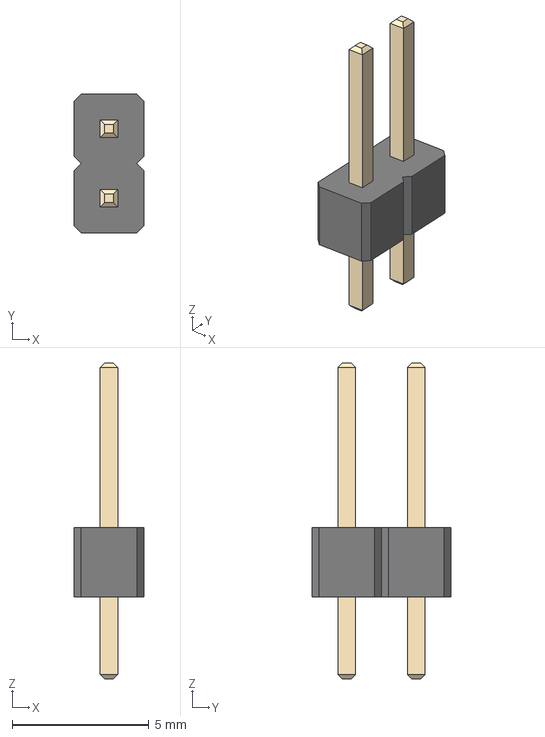
[picture p53: CAD file, 2026-11-01]
electronic-design/revisions/4/models/PinHeader_1x02_P2.54mm_Vertical.step
2.54 x 5.08 x 11.5 mm
