widjis/rgb-sleep-lamp/mechanical/freecad/before-maximized-pcb.FCStd

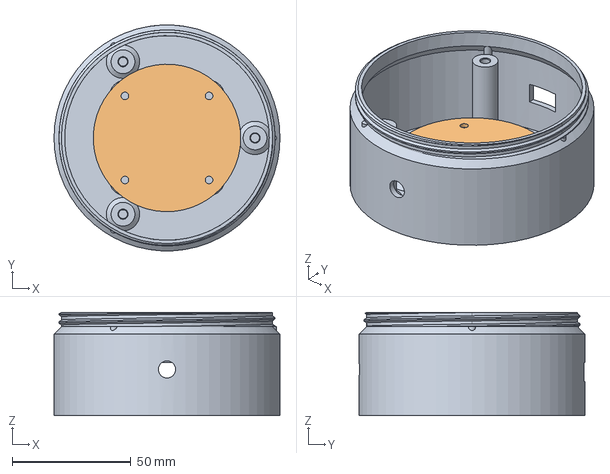
[picture p54: CAD file, 2026-11-01]
mechanical/freecad/before-maximized-pcb.FCStd
95.0 x 95.0 x 43.4 mm
base - imported R9
PCB reference - diameter 62 mm (not circuit layout)
