widjis/rgb-sleep-lamp/mechanical/freecad/before-exploded-usb-fit-20261028-205902.FCStd

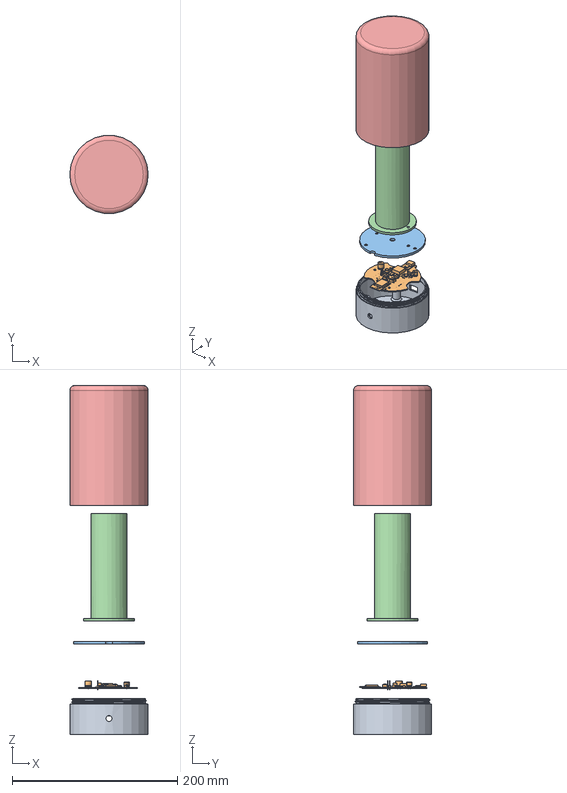
[picture p55: CAD file, 2026-11-01]
mechanical/freecad/before-exploded-usb-fit-20261028-205902.FCStd
95.0 x 95.0 x 422.4 mm
Base - locator protrusions fully removed
PCB KiCad actual - provisional component models
bottom_cover - imported R9
led_core - imported R9
diffuser - imported R9
