widjis/rgb-sleep-lamp/mechanical/freecad/before-usb-support-tab.FCStd

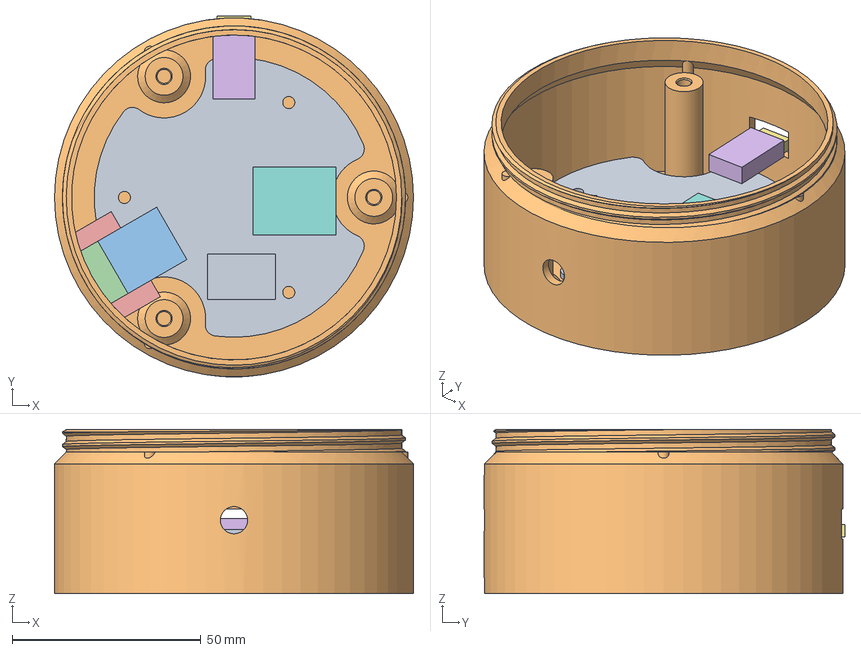
[picture p56: CAD file, 2026-11-01]
mechanical/freecad/before-usb-support-tab.FCStd
95.0 x 95.5 x 43.4 mm
PCB reference - three M3 holes between base posts
Base - 3 PCB supports between cover posts
ESP-12F 24x16x3 - antenna outward
Antenna end reference - no copper under/around (verify artwork)
RF keepout study - provisional, all copper layers
PDC004 fixed20V - provisional reserve18x11x5mm
USB-C port envelope - provisional
20V to 5V buck reserved zone - part TBD
3V3 regulator + LED data level shifter reserve
