widjis/rgb-sleep-lamp/mechanical/freecad/before-usb-fit-20261028-205736.FCStd

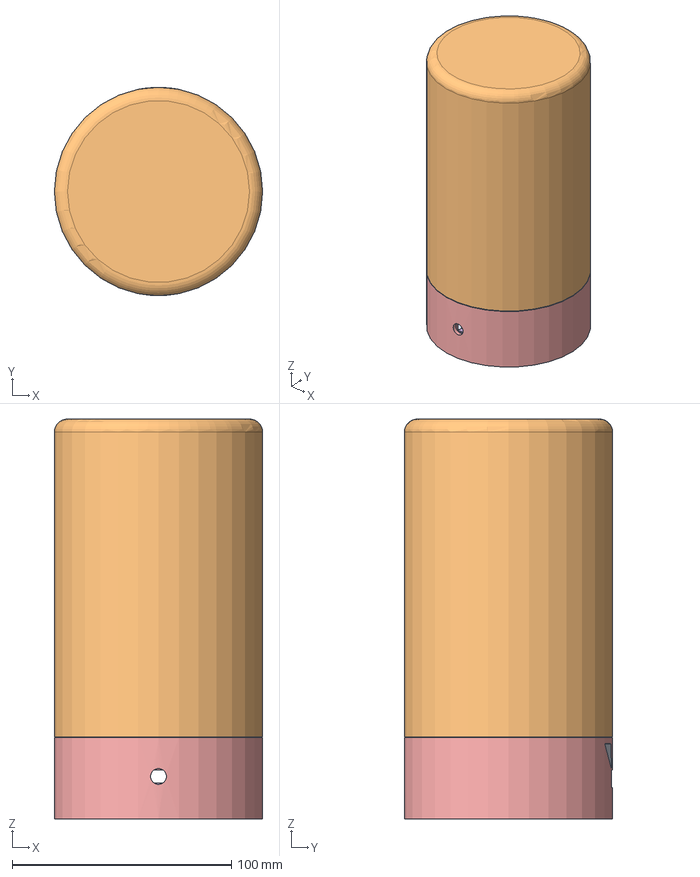
[picture p57: CAD file, 2026-11-01]
mechanical/freecad/before-usb-fit-20261028-205736.FCStd
95.0 x 95.0 x 182.4 mm
base - imported R9
diffuser - imported R9
bottom_cover - imported R9
led_core - imported R9
Base - locator protrusions fully removed
PCB KiCad actual - provisional component models
