widjis/rgb-sleep-lamp/mechanical/freecad/pcb-space-outline.step

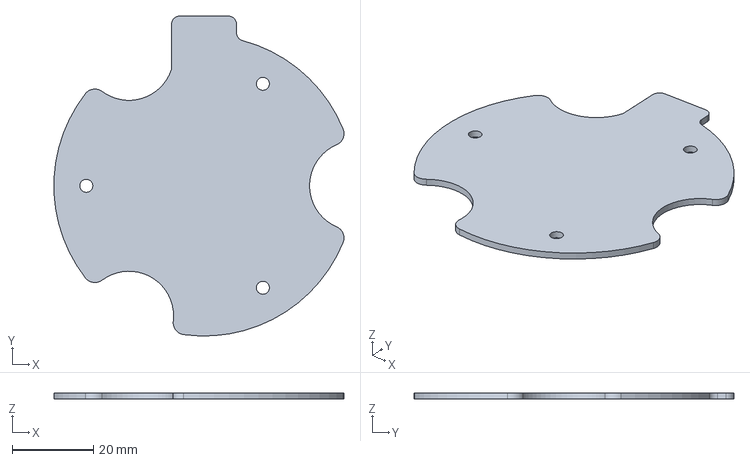
[picture p58: CAD file, 2026-11-01]
mechanical/freecad/pcb-space-outline.step
71.4 x 78.8 x 1.60 mm
