widjis/rgb-sleep-lamp/mechanical/freecad/before-5mm-inward-offset.FCStd

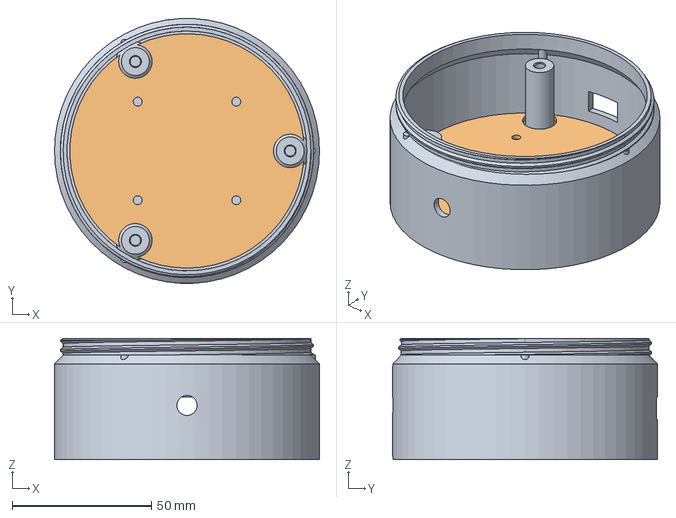
[picture p59: CAD file, 2026-11-01]
mechanical/freecad/before-5mm-inward-offset.FCStd
95.0 x 95.0 x 43.4 mm
base - imported R9
PCB reference - diameter 84 envelope, three post notches
