widjis/rgb-sleep-lamp/mechanical/freecad/USB_Port_Review.FCStd

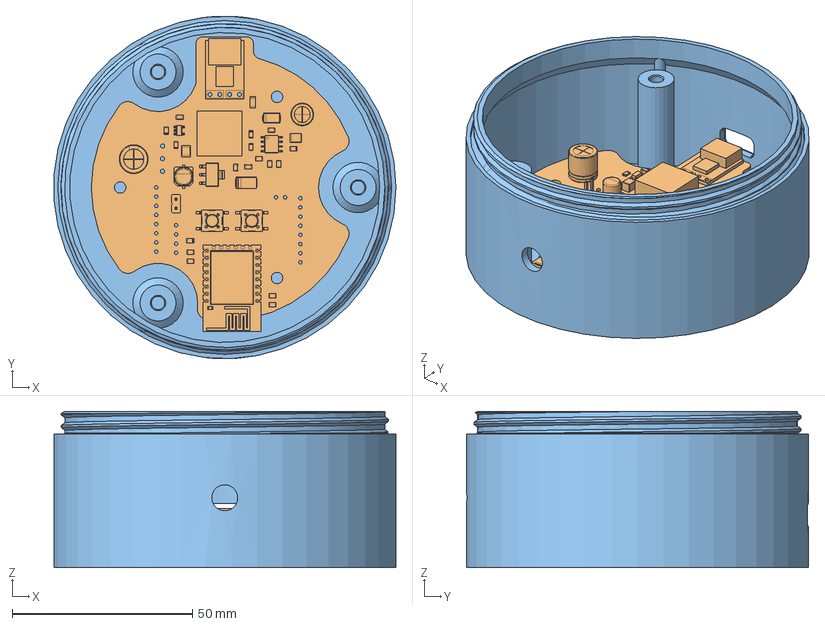
[picture p60: CAD file, 2026-11-01]
mechanical/freecad/USB_Port_Review.FCStd
94.9 x 95.0 x 43.4 mm
BaseTest
PCBTest
ChamferTest
