widjis/rgb-sleep-lamp/mechanical/freecad/before-pcb-step-integration-20261027-193907.FCStd

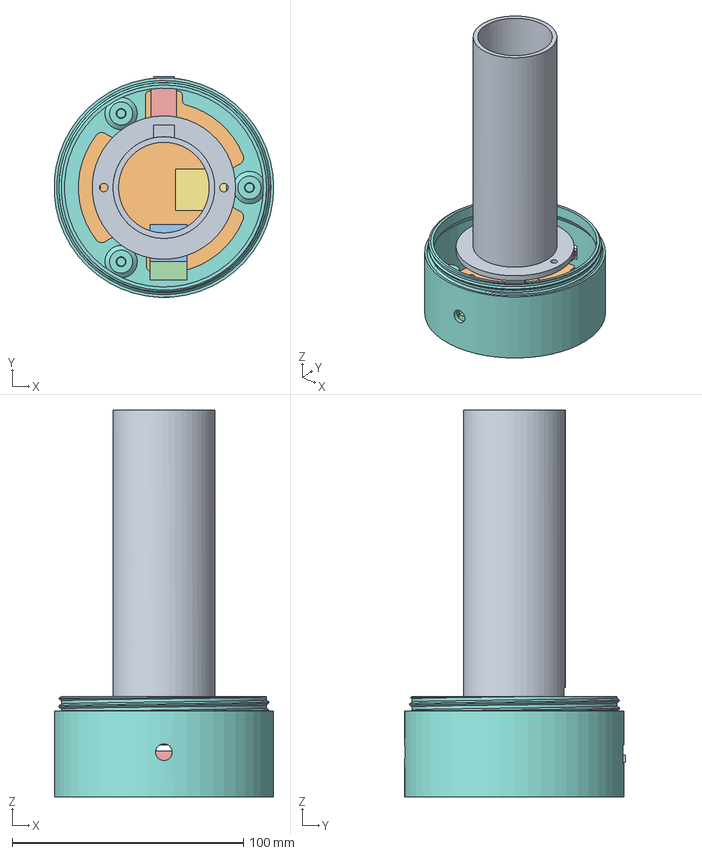
[picture p61: CAD file, 2026-11-01]
mechanical/freecad/before-pcb-step-integration-20261027-193907.FCStd
94.9 x 95.5 x 167.4 mm
led_core - imported R9
PCB - three M3 screws, USB-C support tongue
ESP-12F E2 - PCB center102,128 rotation180
Antenna end reference - no copper under/around (verify artwork)
PDC004 fixed20V - provisional reserve18x11x5mm
USB-C port envelope - provisional
20V to 5V buck reserved zone - part TBD
Base - locator protrusions fully removed
