widjis/rgb-sleep-lamp/mechanical/freecad/before-rounded-placement.FCStd

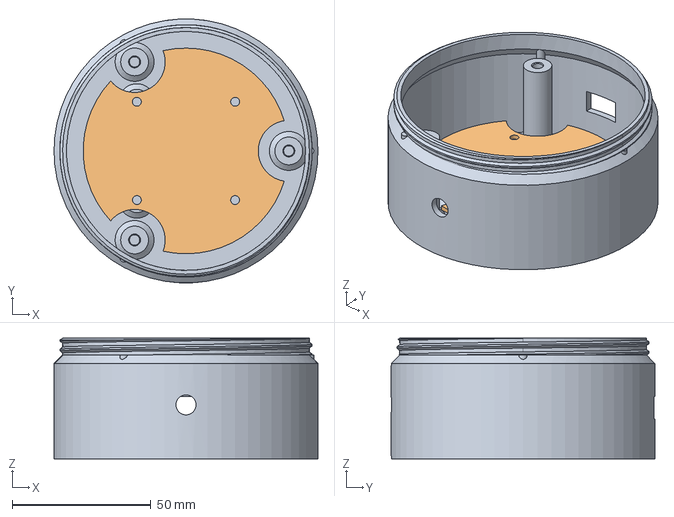
[picture p62: CAD file, 2026-11-01]
mechanical/freecad/before-rounded-placement.FCStd
95.0 x 95.0 x 43.4 mm
base - imported R9
PCB reference - 5mm inward offset, diameter74 envelope
