widjis/rgb-sleep-lamp/mechanical/freecad/before-electronic-E2-placement.FCStd

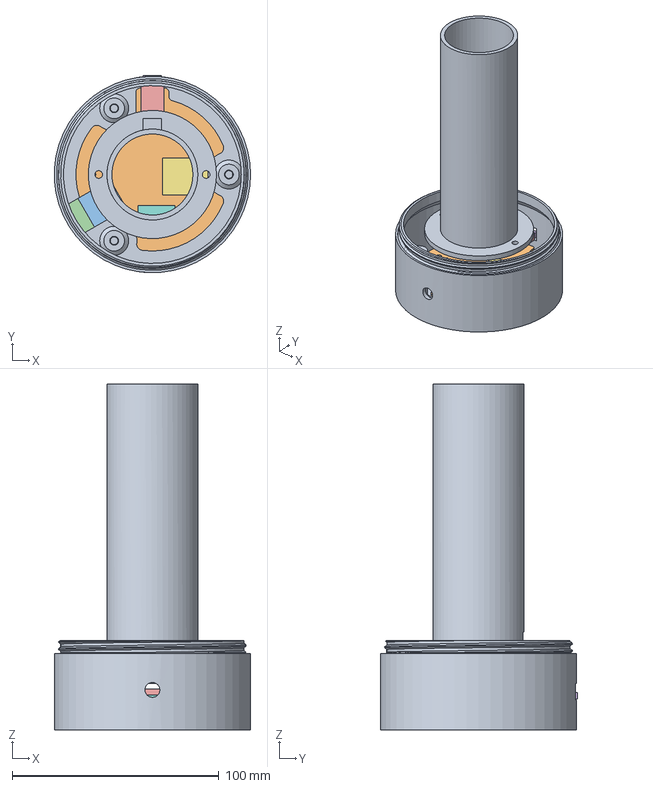
[picture p63: CAD file, 2026-11-01]
mechanical/freecad/before-electronic-E2-placement.FCStd
94.9 x 95.5 x 167.4 mm
led_core - imported R9
PCB - three M3 screws, USB-C support tongue
ESP-12F 24x16x3 - antenna outward
Antenna end reference - no copper under/around (verify artwork)
PDC004 fixed20V - provisional reserve18x11x5mm
USB-C port envelope - provisional
20V to 5V buck reserved zone - part TBD
3V3 regulator + LED data level shifter reserve
Base - locator protrusions fully removed
