widjis/rgb-sleep-lamp/(list of files, cad)

Other CAD files:
mechanical/revisions/9/assembly.step
mechanical/revisions/3/assembly.step
mechanical/revisions/4/assembly.step
mechanical/revisions/5/assembly.step
mechanical/revisions/7/assembly.step
mechanical/printing/base.stl
mechanical/revisions/4/led_core.step
mechanical/revisions/5/bottom_cover.step
mechanical/printing/led_core.stl
mechanical/revisions/1/base.step
mechanical/revisions/4/bottom_cover.step
mechanical/revisions/5/base.step
mechanical/revisions/7/diffuser.step
mechanical/revisions/8/led_core.step
mechanical/revisions/9/led_core.step
mechanical/revisions/1/led_core.step
mechanical/revisions/3/diffuser.step
mechanical/revisions/6/led_core.step
mechanical/revisions/9/bottom_cover.step
mechanical/freecad/before-base-chamfer-20261028-210445-RGB-Sleep-Lamp-exploded.FCStd
mechanical/printing/diffuser.stl
mechanical/revisions/2/bottom_cover.step
mechanical/revisions/3/bottom_cover.step
mechanical/revisions/4/diffuser.step
mechanical/revisions/5/diffuser.step
mechanical/revisions/6/bottom_cover.step
mechanical/revisions/7/led_core.step
mechanical/revisions/8/diffuser.step
mechanical/revisions/9/base.step
mechanical/freecad/RGB-Sleep-Lamp-with-PCB.step
mechanical/revisions/1/diffuser.step
mechanical/revisions/2/led_core.step
mechanical/revisions/3/base.step
mechanical/revisions/4/base.step
mechanical/revisions/5/led_core.step
mechanical/revisions/6/diffuser.step
mechanical/revisions/7/base.step
mechanical/revisions/8/bottom_cover.step
mechanical/revisions/9/diffuser.step
mechanical/freecad/before-usb-junction-cleanup.FCStd
mechanical/freecad/before-PDC004-selection.FCStd
mechanical/freecad/BaseChamferReview.FCStd
mechanical/freecad/before-locator-pin-trim.FCStd
mechanical/freecad/base-current.step
mechanical/freecad/RGB-Sleep-Lamp-native-simulation.FCStd
mechanical/freecad/before-gap-minimization.FCStd
mechanical/freecad/before-base-chamfer-20261028-210445-RGB Sleep Lamp.FCStd
electronic-design/revisions/3/PDC004_estimate.FCStd
electronic-design/revisions/3/backups/before-pd-four-holes-20261027-193110/PDC004_estimate.FCStd
electronic-design/revisions/3/backups/before-pd-four-holes-20261027-193110/PDC004_estimate.step
electronic-design/revisions/3/backups/before-pdc-photo-refine-20261027-193519/PDC004_estimate.FCStd
electronic-design/revisions/3/backups/before-pdc-photo-refine-20261027-193519/PDC004_estimate.step
electronic-design/revisions/4/PDC004_estimate.FCStd
electronic-design/revisions/4/backups/before-pd-four-holes-20261027-193110/PDC004_estimate.FCStd
electronic-design/revisions/4/backups/before-pd-four-holes-20261027-193110/PDC004_estimate.step
electronic-design/revisions/4/backups/before-pdc-photo-refine-20261027-193519/PDC004_estimate.FCStd
electronic-design/revisions/4/backups/before-pdc-photo-refine-20261027-193519/PDC004_estimate.step
electronic-design/revisions/4/models/L_SRP1245A_reference.FCStd
electronic-design/revisions/5/PDC004_estimate.FCStd
electronic-design/revisions/5/models/L_SRP1245A_reference.FCStd
mechanical/freecad/base-current.stl
mechanical/freecad/before-three-pcb-screws.FCStd
mechanical/revisions/1/base.stl
mechanical/revisions/1/bottom_cover.stl
mechanical/revisions/1/diffuser.stl
mechanical/revisions/1/led_core.stl
mechanical/revisions/2/base.stl
mechanical/revisions/2/bottom_cover.stl
mechanical/revisions/2/diffuser.stl
mechanical/revisions/2/led_core.stl
mechanical/revisions/2/source/bottom_cover.step
mechanical/revisions/2/source/led_core.step
mechanical/revisions/3/base.stl
mechanical/revisions/3/bottom_cover.stl
mechanical/revisions/3/diffuser.stl
mechanical/revisions/3/led_core.stl
mechanical/revisions/3/source/base.step
mechanical/revisions/3/source/base.stl
mechanical/revisions/3/source/bottom_cover.step
mechanical/revisions/3/source/bottom_cover.stl
mechanical/revisions/3/source/diffuser.step
mechanical/revisions/3/source/diffuser.stl
mechanical/revisions/3/source/led_core.stl
mechanical/revisions/4/base.stl
mechanical/revisions/4/bottom_cover.stl
mechanical/revisions/4/diffuser.stl
mechanical/revisions/4/led_core.stl
mechanical/revisions/4/source/base.step
mechanical/revisions/4/source/base.stl
mechanical/revisions/4/source/bottom_cover.step
mechanical/revisions/4/source/bottom_cover.stl
mechanical/revisions/4/source/diffuser.step
mechanical/revisions/4/source/diffuser.stl
mechanical/revisions/4/source/led_core.step
mechanical/revisions/4/source/led_core.stl
mechanical/revisions/5/base.stl
mechanical/revisions/5/bottom_cover.stl
mechanical/revisions/5/diffuser.stl
mechanical/revisions/5/led_core.stl
mechanical/revisions/5/source/base.step
mechanical/revisions/5/source/base.stl
mechanical/revisions/5/source/bottom_cover.step
mechanical/revisions/5/source/bottom_cover.stl
mechanical/revisions/5/source/diffuser.step
mechanical/revisions/5/source/diffuser.stl
mechanical/revisions/5/source/led_core.step
mechanical/revisions/5/source/led_core.stl
mechanical/revisions/6/base.stl
mechanical/revisions/6/bottom_cover.stl
mechanical/revisions/6/diffuser.stl
mechanical/revisions/6/led_core.stl
mechanical/revisions/6/source/base.stl
mechanical/revisions/6/source/bottom_cover.step
mechanical/revisions/6/source/bottom_cover.stl
mechanical/revisions/6/source/diffuser.step
mechanical/revisions/6/source/diffuser.stl
mechanical/revisions/6/source/led_core.step
mechanical/revisions/6/source/led_core.stl
mechanical/revisions/7/base.stl
mechanical/revisions/7/bottom_cover.stl
mechanical/revisions/7/diffuser.stl
mechanical/revisions/7/led_core.stl
mechanical/revisions/7/source/base.step
mechanical/revisions/7/source/base.stl
mechanical/revisions/7/source/bottom_cover.stl
mechanical/revisions/7/source/diffuser.step
mechanical/revisions/7/source/diffuser.stl
mechanical/revisions/7/source/led_core.step
mechanical/revisions/7/source/led_core.stl
mechanical/revisions/8/base.stl
mechanical/revisions/8/bottom_cover.stl
mechanical/revisions/8/diffuser.stl
mechanical/revisions/8/led_core.stl
mechanical/revisions/8/source/base.stl
mechanical/revisions/8/source/bottom_cover.step
mechanical/revisions/8/source/bottom_cover.stl
mechanical/revisions/8/source/diffuser.step
mechanical/revisions/8/source/diffuser.stl
mechanical/revisions/8/source/led_core.step
mechanical/revisions/8/source/led_core.stl
mechanical/revisions/9/base.stl
mechanical/revisions/9/bottom_cover.stl
mechanical/revisions/9/diffuser.stl
mechanical/revisions/9/led_core.stl
mechanical/revisions/9/source/base.step
mechanical/revisions/9/source/base.stl
mechanical/revisions/9/source/bottom_cover.step
mechanical/revisions/9/source/bottom_cover.stl
mechanical/revisions/9/source/diffuser.step
mechanical/revisions/9/source/diffuser.stl
mechanical/revisions/9/source/led_core.step
mechanical/revisions/9/source/led_core.stl
