widjis/rgb-sleep-lamp/electronic-design/revisions/4/fabrication/20261030-E4/gerbers/README.txt

RGB SLEEP LAMP - E4 GERBER EXPORT - 2026-10-30

KiCad 10.0.7 native fabrication export from revision 4, including the final component references and curved ORANGEFLAVOR LABS legend.
2 copper layers, FR4, 1.6 mm board thickness; configured copper 35 um per side. Surface finish is not specified by the design.
Files: top/bottom copper, top/bottom solder mask, top/bottom silkscreen, Edge.Cuts profile, Gerber job, separate PTH and NPTH Excellon drill files. Gerber X2, metric, absolute common origin, no mirroring. Silkscreen is subtracted from solder-mask openings.
PTH: 69 holes (minimum drill 0.6 mm). NPTH: 3 mounting holes, diameter 3.2 mm.
No courtyard, assembly, adhesive, drawing-sheet, paste or user layers are in this bare-board package.

Native zone refill/save retained the exact source PCB hash. DRC: 0 violations, 0 unconnected, 0 schematic parity issues; no ignored DRC checks or exclusions.
The schematic ERC has 0 reported violations under its existing settings; four existing ignored checks are listed in review/erc.json outside the fabrication ZIP.
GerbView: copper/profile/drill overlay and top legend/profile/drill overlay visually inspected.

STATUS: PRODUCTION_REVIEW_PENDING. Donor part values/footprints, module dimensions and physical/thermal testing remain provisional or not run, as recorded in the source project. This export does not certify physical fit or functional operation.
Source PCB: electronic-design/revisions/4/circuit.kicad_pcb
Source SHA256: f0fe143610f6c50a2f54d6aaa8bf04145f1fea052ec4a48512a21fa9d362b62a
