widjis/rgb-sleep-lamp/electronic-design/revisions/5/fabrication/20261031-E5/gerbers/README.txt

RGB SLEEP LAMP - E5 - 2026-10-31

Native KiCad 10.0.7 export from electronic-design/revisions/5/circuit.kicad_pcb.
2-layer FR4, board thickness 1.6 mm, configured copper 35 um per side.
Minimum copper clearance/track width 0.3 mm. ALL 33 vias: DRILL 0.8 mm, copper diameter 1.2 mm, radial annular ring 0.2 mm.
Existing 0.35 mm copper-edge rule retained. Top supply/GND and bottom GND pours included.
Gerber X2: F.Cu, B.Cu, F.Mask, B.Mask, F.Silkscreen, B.Silkscreen, Edge.Cuts; job file; separate PTH/NPTH Excellon.
All fabrication files use metric, absolute common origin, no mirroring. Legend subtracted from solder mask. No assembly/courtyard/user/paste layers.
PTH: 68 holes, minimum drill 0.8 mm. NPTH: 3 holes, drill 3.2 mm.

All E4 routing removed and rebuilt. Native full DRC/refill/parity: 0 violations / 0 unconnected / 0 parity issues. No ignored DRC checks/exclusions.
47 component reference labels and original curved ORANGEFLAVOR LABS artwork retained. Five references moved away from new via holes; R12 has a short leader.
Schematic unchanged; existing ERC settings retain four ignored checks, detailed outside the ZIP.

STATUS: PRODUCTION_REVIEW_PENDING. Physical fit, donor dimensions/values, thermal, loop stability, RF and functional testing remain provisional or not run.
PCB SHA256: 7e6805146fe27a8ff927305ab1cc769ffe9999222ff86da6a5450937b462665a
