widjis/rgb-sleep-lamp/electronic-design/revisions/4/README.txt

RGB SLEEP LAMP E4 - DRC CLEAN LAYOUT REVIEW

Native KiCad 10.0.7 files; checked 2026-10-30. Existing revision E3 is preserved.

FINAL VALIDATION
- DRC: 0 violations, 0 unconnected items, 0 schematic parity issues.
- All five formerly ignored DRC categories are enabled. No DRC checks are ignored and no violations are excluded.
- Schematic ERC: 0 violations. All three sheets were saved by the native KiCad writer; before/after schematic net pin groups match.
- Native PCB saved, reloaded, copper refilled and DRC rerun on this project path.
- Actual minimum track width 0.30 mm; actual minimum via diameter/drill 1.20/0.60 mm. Copper clearance 0.30 mm; board-edge clearance 0.35 mm.
- Final reports: drc-final.json, erc.json, drc-cleanup-validation.json. Earlier investigation reports are historical.

GROUND AND ROUTING CHANGES
- Added GND vias at (106.7,111.5) and (106,114) mm, each 1.20/0.60 mm.
- Connected ESP-12F GND and R5 ground to the main ground network on F.Cu.
- Moved the ESP-12F 3V3 branch above the flash-pad row to open the ground corridor, retaining its 0.50 mm width.
- Centered the LED_DATA_3V3 bottom trace endpoint on its existing via at (87.25,120.75) mm.
- Footprint positions, pad numbers and pad nets remain unchanged. Custom footprint names and schematic assignments were synchronized with standard symbol filters.

COPPER AND SILK
- F.Cu GND plus localized +3.3V/+5V/+20V pours, and B.Cu GND, remain filled.
- Curved ORANGEFLAVOR LABS vector artwork remains grouped on F.SilkS. Arial Bold cap height 1.35 mm; baseline R34.1 mm about (100,100) mm. Source: artwork/ORANGEFLAVOR-LABS-curved.svg.

BACKUP
- backups/before-full-drc-cleanup-20261030 contains the prior board, project, schematics, library table and reports.

DRC clean is a layout verification result. Donor-component measurements, power/thermal/loop-stability and physical prototype tests remain NOT_RUN; this revision is LAYOUT_REVIEW, not production approval.

3D MODELS COMPLETED (2026-10-30)
- 9 missing model assignments added; L1/U3 broken references repaired.
- 43 physical components have visible model files. H1-H3 holes and J3 bare wire pads intentionally have no body.
- Models, provenance and approximation notes: models/README.txt and models/models-3d-report.json.
- L1 is an unverified reference envelope; U3 uses a generic external SOIC-8E package.
- Complete non-model PCB data is identical before/after. Native DRC/parity remains clean with all checks enabled.
- Updated native top/bottom/isometric renders: renders/pcb-final-*.png. Updated full CAD assembly: circuit-assembled.step.

COMPONENT REFERENCE SILKSCREEN (2026-10-30)
- All 47 reference fields are visible on F.SilkS, height 0.8 mm / stroke 0.12 mm. Three short leader lines clarify references in crowded areas.
- Footprint placement, pads, nets, tracks, vias, copper fills, models and curved brand artwork are unchanged. Native save/reload and full DRC/parity: zero violations, zero unconnected, no ignored checks or exclusions.
- Evidence: silkscreen-components-validation.json. Previous board and reports retained in backups/before-component-silkscreen-20261030.
