widjis/rgb-sleep-lamp/electronic-design/revisions/5/README.txt

RGB SLEEP LAMP - ELECTRONICS REVISION E5

Rebuilt from E4 after removing all 444 track segments and 34 vias. All routing objects in E5 have new UUIDs. Physical footprints, pad geometry/nets, placement, 43 component models, 47 reference labels, curved artwork and board outline are retained. Five reference labels and two board labels were adjusted to keep clear of the new via bores; a short R12 leader was added.

RULES
- Clearance >=0.3 mm; every actual track width >=0.3 mm.
- Via drill 0.8 mm, outside diameter 1.2 mm, radial annular ring 0.2 mm (user clarified that 0.8 mm means the bore).
- Existing copper-edge limit 0.35 mm and other design limits retained.
- F.Cu prioritized; B.Cu used to finish connections. Existing top supply/GND and bottom GND pours refilled.

PROCESS
- Top-only trial verified 213 segments, 100% top, no vias, at widths >=0.3 mm, but incomplete.
- Complete candidate uses fanout before routing to avoid boxed-in ESP pins. All 15 undersized fanout segments generated by the router were widened to 0.3 mm and verified by native DRC.
- A clearance-checked 0.5 mm bridge at J7 pin 7 fixes a local 3.3 V thermal island; zone boundaries/settings and footprint pads are unchanged.
- Full native DRC with refill, schematic parity, all severities/checks enabled and no exclusions: 0 violations / 0 unconnected / 0 parity issues.
- E4 and its fabrication package are preserved.

EVIDENCE
validation.json; drc-final.json; routing/rebuild-baseline.json; routing/result-fanout-noopt.json; routing/fanout-width-corrections.json; routing/thermal-bridge.json.

Physical donor footprints/values, module dimensions, thermal, loop stability, RF and hardware operation remain provisional or NOT_RUN. DRC clean is a digital layout check, not fabrication approval.

FINAL REVIEW / EXPORT
Native top/bottom renders and GerbView copper/legend/profile/drill overlays inspected. Text-stroke clearance from all via bores >=0.1 mm; no collisions. 47 visible component references.
Fabrication ZIP: fabrication/20261031-E5/RGB-Sleep-Lamp-E5-Gerber-20261031.zip (10 native files; README/checksums outside ZIP). 68 PTH holes, minimum drill 0.8 mm; 3 NPTH mounting holes, 3.2 mm. ZIP and embedded file checksums verified.
