widjis/rgb-sleep-lamp/electronic-design/revisions/3/led-placement-review/README.md

C10 supply bypass placed near U2; R8 input pull-down near U2; R7 series output toward J3. All 47 footprints placed, all pad centers inside outline; intentional ESP antenna overhang retained. Native snapshot backup and reload used to preserve footprint models/geometry. Pad/net map and model counts unchanged. Zero tracks or vias added. Final native DRC: zero geometry/parity violations; six pre-existing library mismatches and 104 unrouted connections remain. Physical fit and electronic functionality not tested.
