widjis/rgb-sleep-lamp/electronic-design/revisions/3/library-repair-review/README.md

# Footprint library repair

R1, R2, R4, R5, R9 and J5 repaired against installed KiCad footprint libraries.
Native library drawing primitives and 3D model references were restored;
reference/value fields, pad definitions, pad/net map, placement, orientation,
footprint UUIDs and all six user track segments were preserved and compared.
Snapshot of the latest live buffer was backed up before applying changes.
The repaired file was rewritten natively, reloaded into the active editor,
and saved via IPC. No full-footprint IPC update was used during repair.

Final DRC: zero footprint-library mismatches, zero schematic parity issues.
One existing dangling VIN_BUCK trace end (0.4773 mm segment) remains because
the user is routing manually; 102 unconnected items remain. No trace removed.
No DRC warning was hidden or downgraded to achieve this result.
