widjis/rgb-sleep-lamp/electronic-design/revisions/4/models/README.txt

3D COMPONENT MODELS - RGB SLEEP LAMP E4

9 board instances gained models; L1/U3 broken links repaired. All 43 physical components have a visible, resolvable model. H1-H3 are holes and J3 is a bare wire interface, so these four positions intentionally have no component body.

Standard STEP models were copied from the installed official KiCad 3D library. Their geometry follows the selected generic packages. Original source: https://gitlab.com/kicad/libraries/kicad-packages3D . Library license: https://www.kicad.org/libraries/license/ .

L1 is a generated reference envelope, 13.5 x 12.5 x 4.8 mm, based on https://www.bourns.com/docs/product-datasheets/srp1245a.pdf . It is NOT a verified donor or manufacturer CAD model. Colored VRML is used for the viewer; a same-basename STEP and editable FCStd are included. STEP assembly export must enable --subst-models to substitute its companion STEP.

U3 uses the standard SOIC-8E 3.9 x 4.9 mm / 1.27 mm pitch external package. The available template visualizes a 2.41 x 3.81 mm exposed pad; the electrical footprint remains the approved 2.62 x 3.51 mm pad. The existing ESP-12E envelope for U1 and existing PDC004 estimate for J4 remain visual approximations.

Full non-model PCB data was compared before/after: identical. DRC/parity remains zero with no ignored checks or exclusions. 3D model completeness is not physical-fit verification.
