widjis/rgb-sleep-lamp/electronic-design/revisions/3/sources.md

Manufacturer reference: https://www.monolithicpower.com/en/documentview/productdocument/index/version/2/document_type/Datasheet/lang/en/sku/MP1584EN-LF-Z/document_id/204/
Pinout p4; compensation Table3p13;5V circuit p15;EP land patternp17. Donor values/packages unverified.
