widjis/rgb-sleep-lamp/electronic-design/revisions/4/backups/before-full-drc-cleanup-20261030/README.txt

RGB SLEEP LAMP E4 - ROUTING AND COPPER-POUR REVIEW

This native KiCad review revision is derived from E3. E3 is preserved unchanged.

Current work:
- F.Cu pours: GND across the board; +3.3V, +5V, and +20V localized around their existing copper networks. B.Cu GND pour retained.
- User routing limits retained: track width >=0.30 mm, via diameter >=1.20 mm, via drill >=0.60 mm, copper clearance >=0.30 mm. Board-edge clearance is 0.35 mm (above the requested 0.30 mm minimum) to preserve the existing UART_RX escape without violating pad clearance.
- GPIO14 clearance was corrected. UART_RX was returned to a route that clears U1 while meeting the board-edge rule.
- ORANGEFLAVOR LABS now uses Arial Bold SVG outlines converted to native filled F.SilkS polygons and grouped as one artwork. Cap height 1.35 mm; baseline radius 34.1 mm around board center 100,100 mm. It follows the actual left outline arc outside H2, clear of GPIO labels. Source: artwork/ORANGEFLAVOR-LABS-curved.svg. Native KiCad render reviewed at full resolution; routing and electrical geometry are unchanged by this artwork edit.
- Added local ground stitching routes near C1, R5/U1, J2 and J5. All retained added tracks are at least 0.30 mm; stitching vias are 1.20/0.60 mm.
- U3 MP1584EN SOIC-8E pad lands use 1.60 x 0.61 mm per the manufacturer-recommended pattern; EP unchanged. Project-local footprint is in Lamp_Local.pretty.

Validation (native KiCad 10.0.7): drc-final.json reports 0 geometric violations and 2 unconnected GND zone items. No component-pad unconnected pairs are reported, but the two isolated GND copper-zone connections remain unresolved, so this is not a clean connectivity pass and is not fabrication-ready. The final DRC is not represented as fully passing.

Earlier investigation reports are retained for audit. U3 wiring and provisional MP1584EN values, donor-package checks, and bench-stability checks remain as described in E3.
