widjis/rgb-sleep-lamp/electronic-design/revisions/2/pcb-placement.svg.png

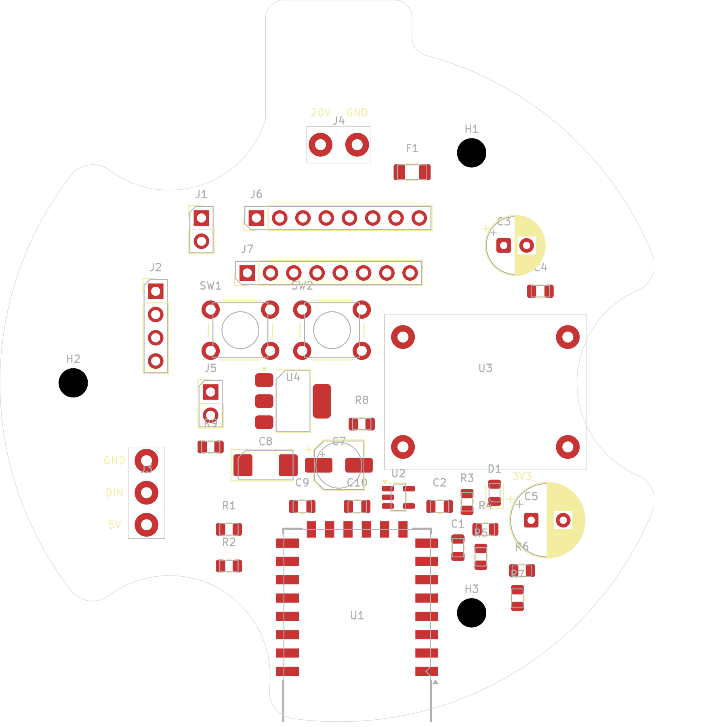
electronic-design/revisions/2/pcb-placement.svg.png
