widjis/rgb-sleep-lamp/electronic-design/revisions/3/esp-placement-review/placement.png

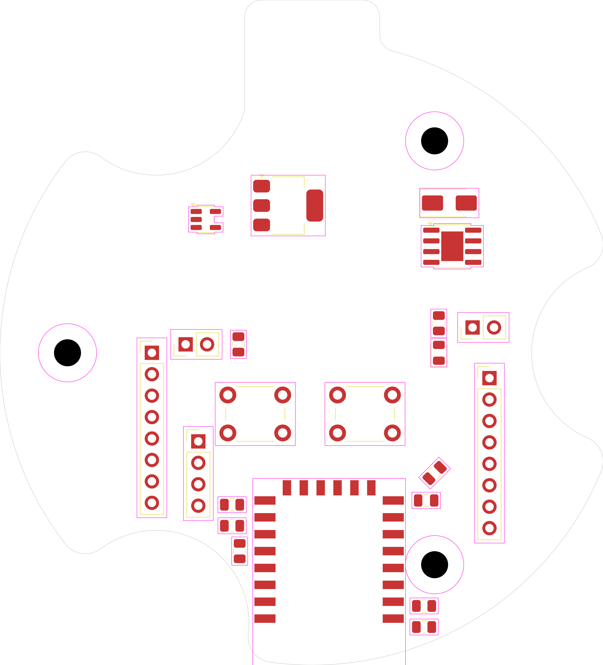
electronic-design/revisions/3/esp-placement-review/placement.png
