widjis/rgb-sleep-lamp/electronic-design/revisions/3/led-placement-review/placement.png

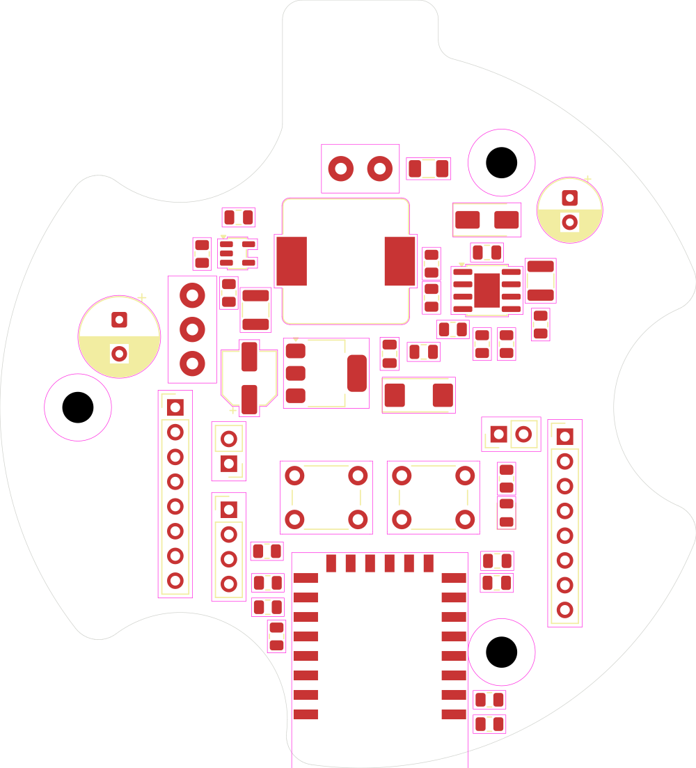
electronic-design/revisions/3/led-placement-review/placement.png
