widjis/rgb-sleep-lamp/electronic-design/revisions/3/pcb-parking-cropped.svg.png

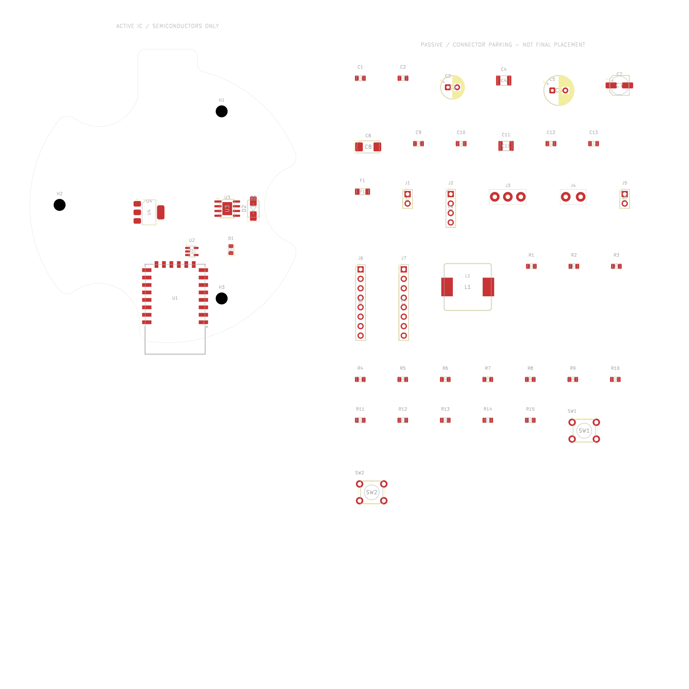
electronic-design/revisions/3/pcb-parking-cropped.svg.png
