widjis/rgb-sleep-lamp/electronic-design/revisions/4/artwork/curved-wordmark-preview.png

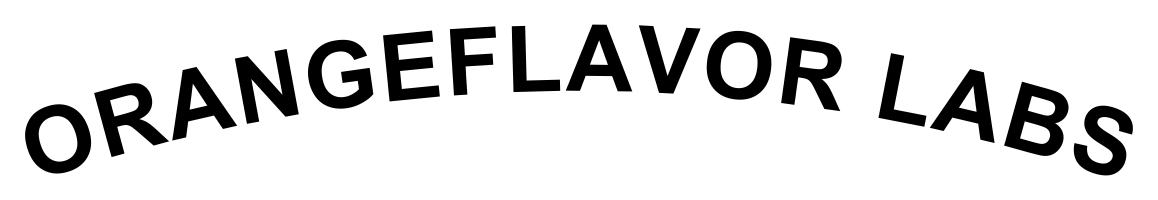
electronic-design/revisions/4/artwork/curved-wordmark-preview.png
