widjis/rgb-sleep-lamp/electronic-design/revisions/4/renders/pcb-final-bottom.png

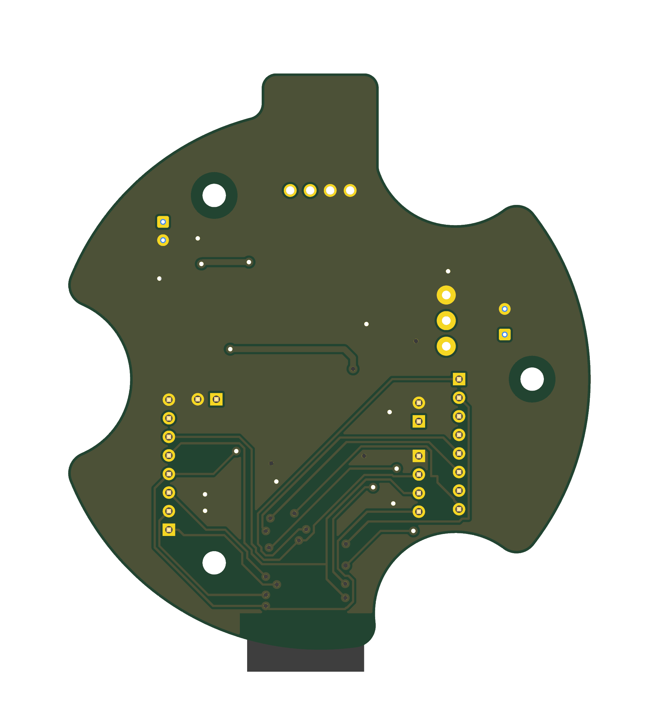
electronic-design/revisions/4/renders/pcb-final-bottom.png
