widjis/rgb-sleep-lamp/electronic-design/revisions/4/renders/pcb-final-isometric.png

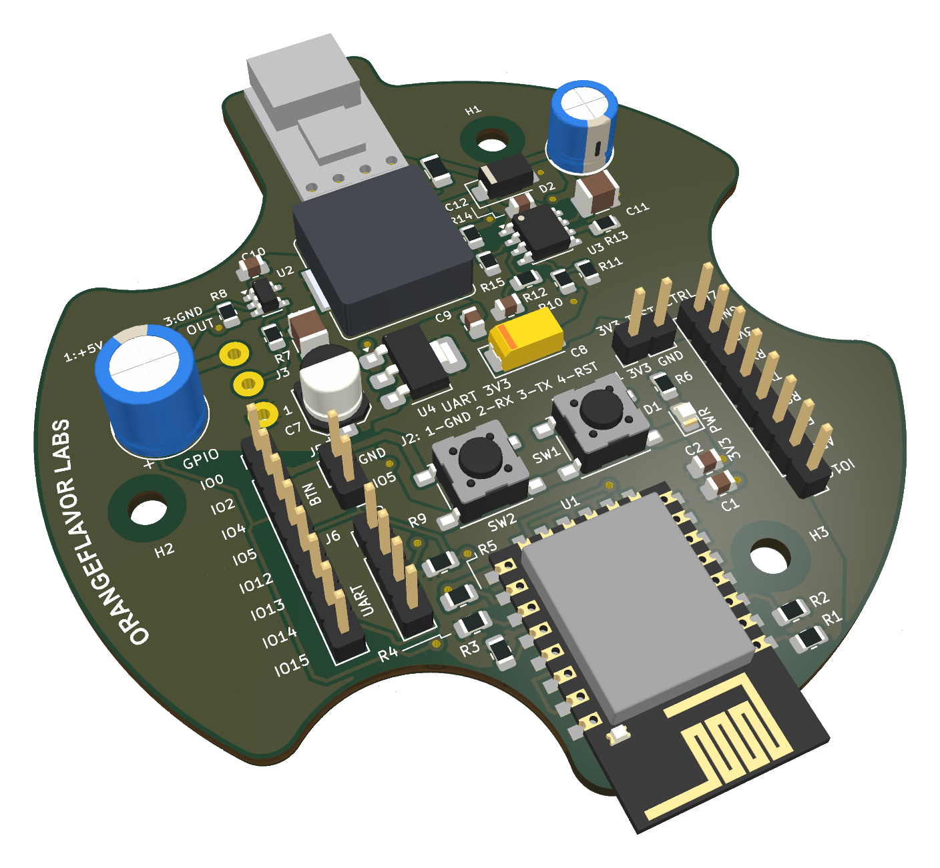
electronic-design/revisions/4/renders/pcb-final-isometric.png
