widjis/rgb-sleep-lamp/electronic-design/revisions/4/silkscreen-curved-preview.png

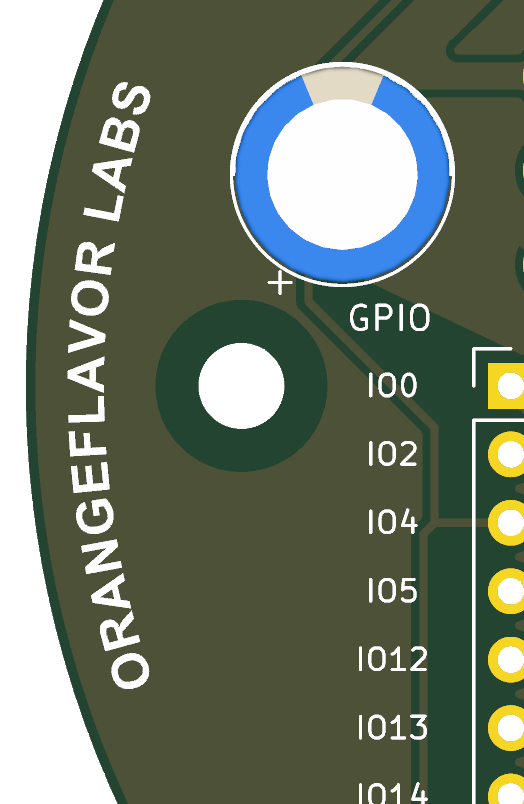
electronic-design/revisions/4/silkscreen-curved-preview.png
