widjis/rgb-sleep-lamp/electronic-design/revisions/2/schematic.pdf

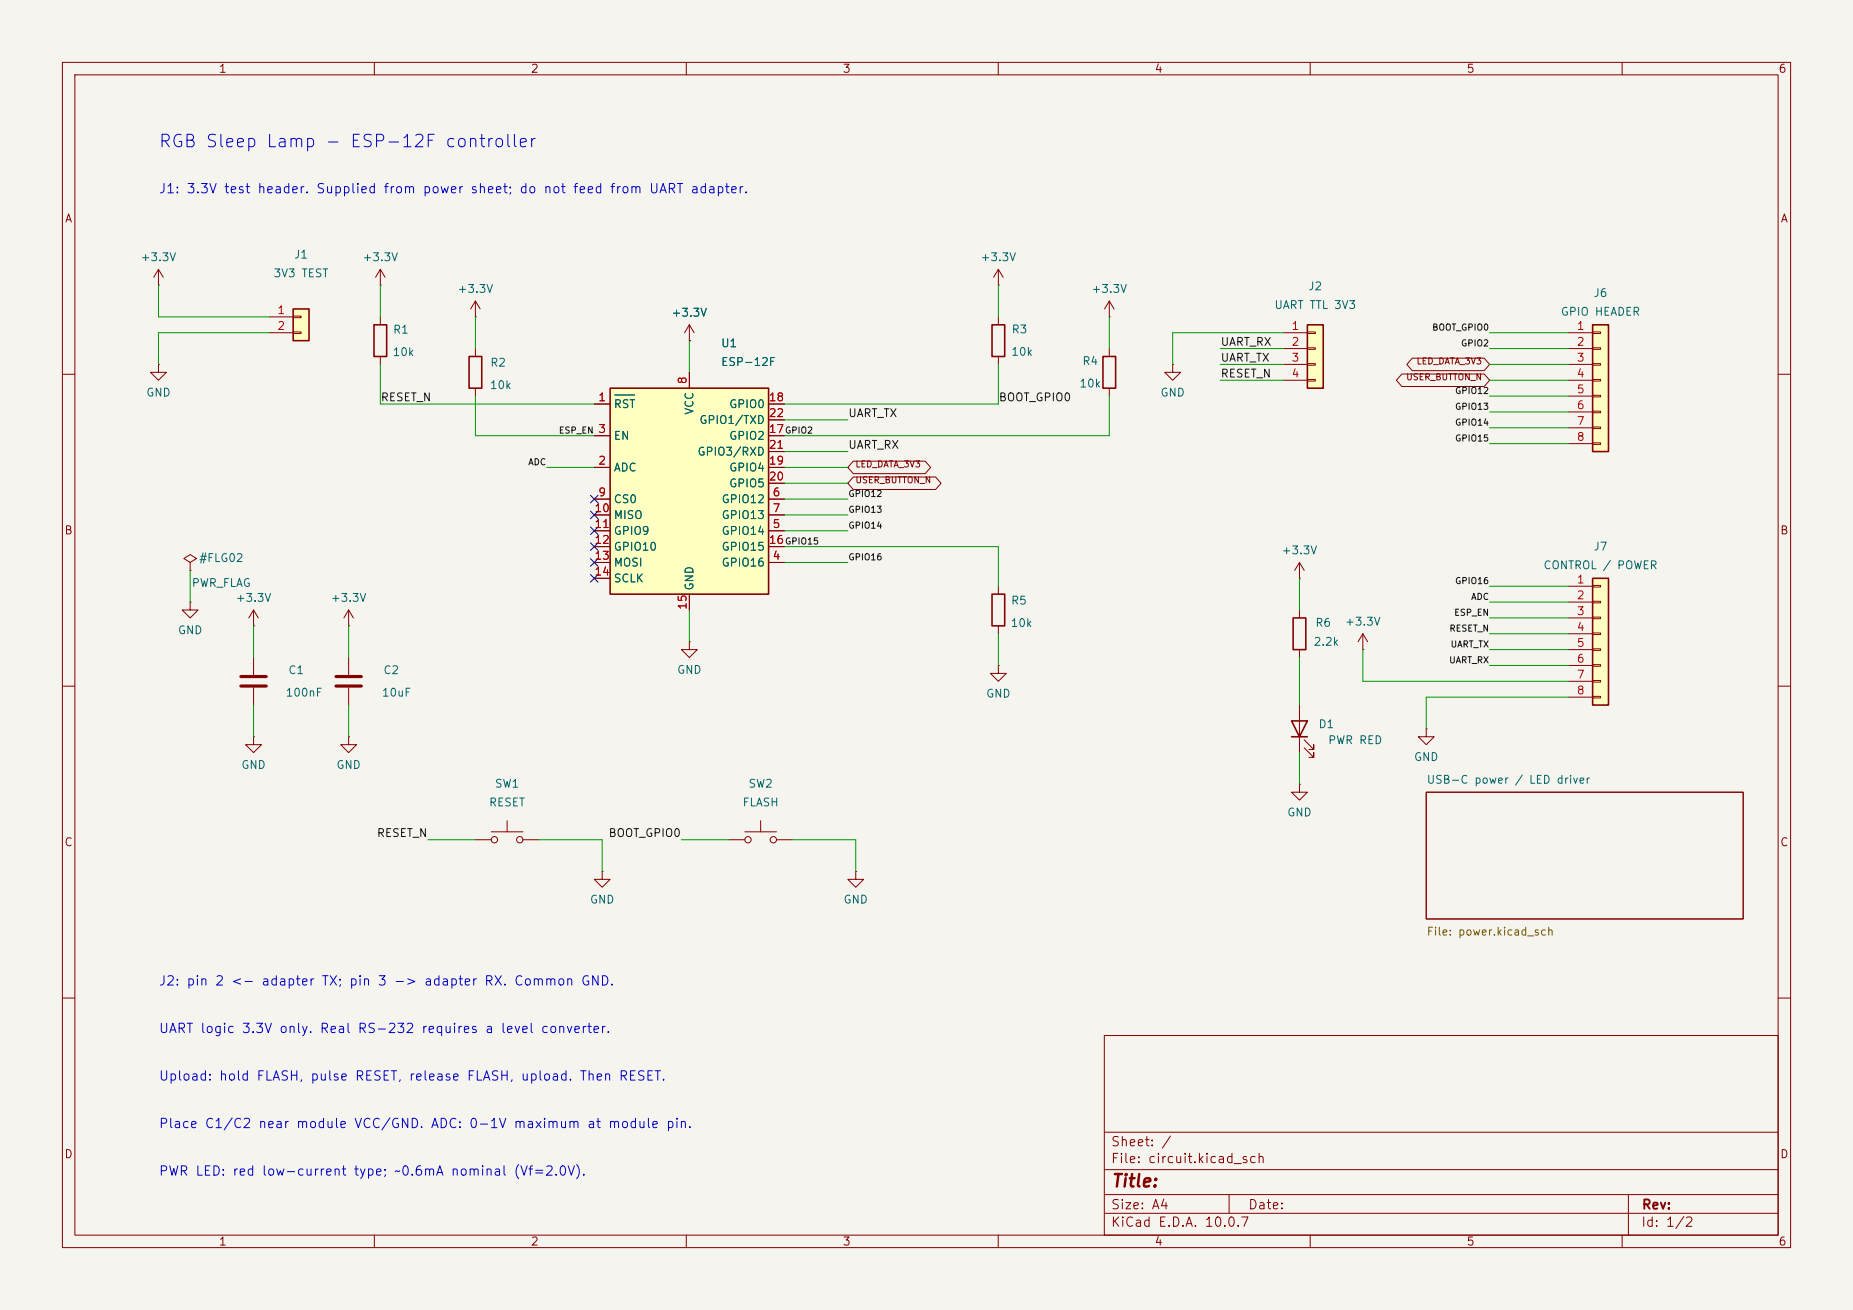
[picture p72: page 1]

RGB Sleep Lamp - ESP-12F controller

J1: 3.3V test header. Supplied from power sheet; do not feed from UART adapter.

USB-C power / LED driver File: power.kicad_sch GND
BOOT_GPIO0 Upload: hold FLASH, pulse RESET, release FLASH, upload. Then RESET.

J2: pin 2 <- adapter TX; pin 3 -> adapter RX. Common GND.

UART logic 3.3V only. Real RS-232 requires a level converter.

Place C1/C2 near module VCC/GND. ADC: 0-1V maximum at module pin.

PWR LED: red low-current type; ~0.6mA nominal (Vf=2.0V).

Size: A4 | Rev:
KiCad E.D.A. 10.0.7 | Id: 1/2

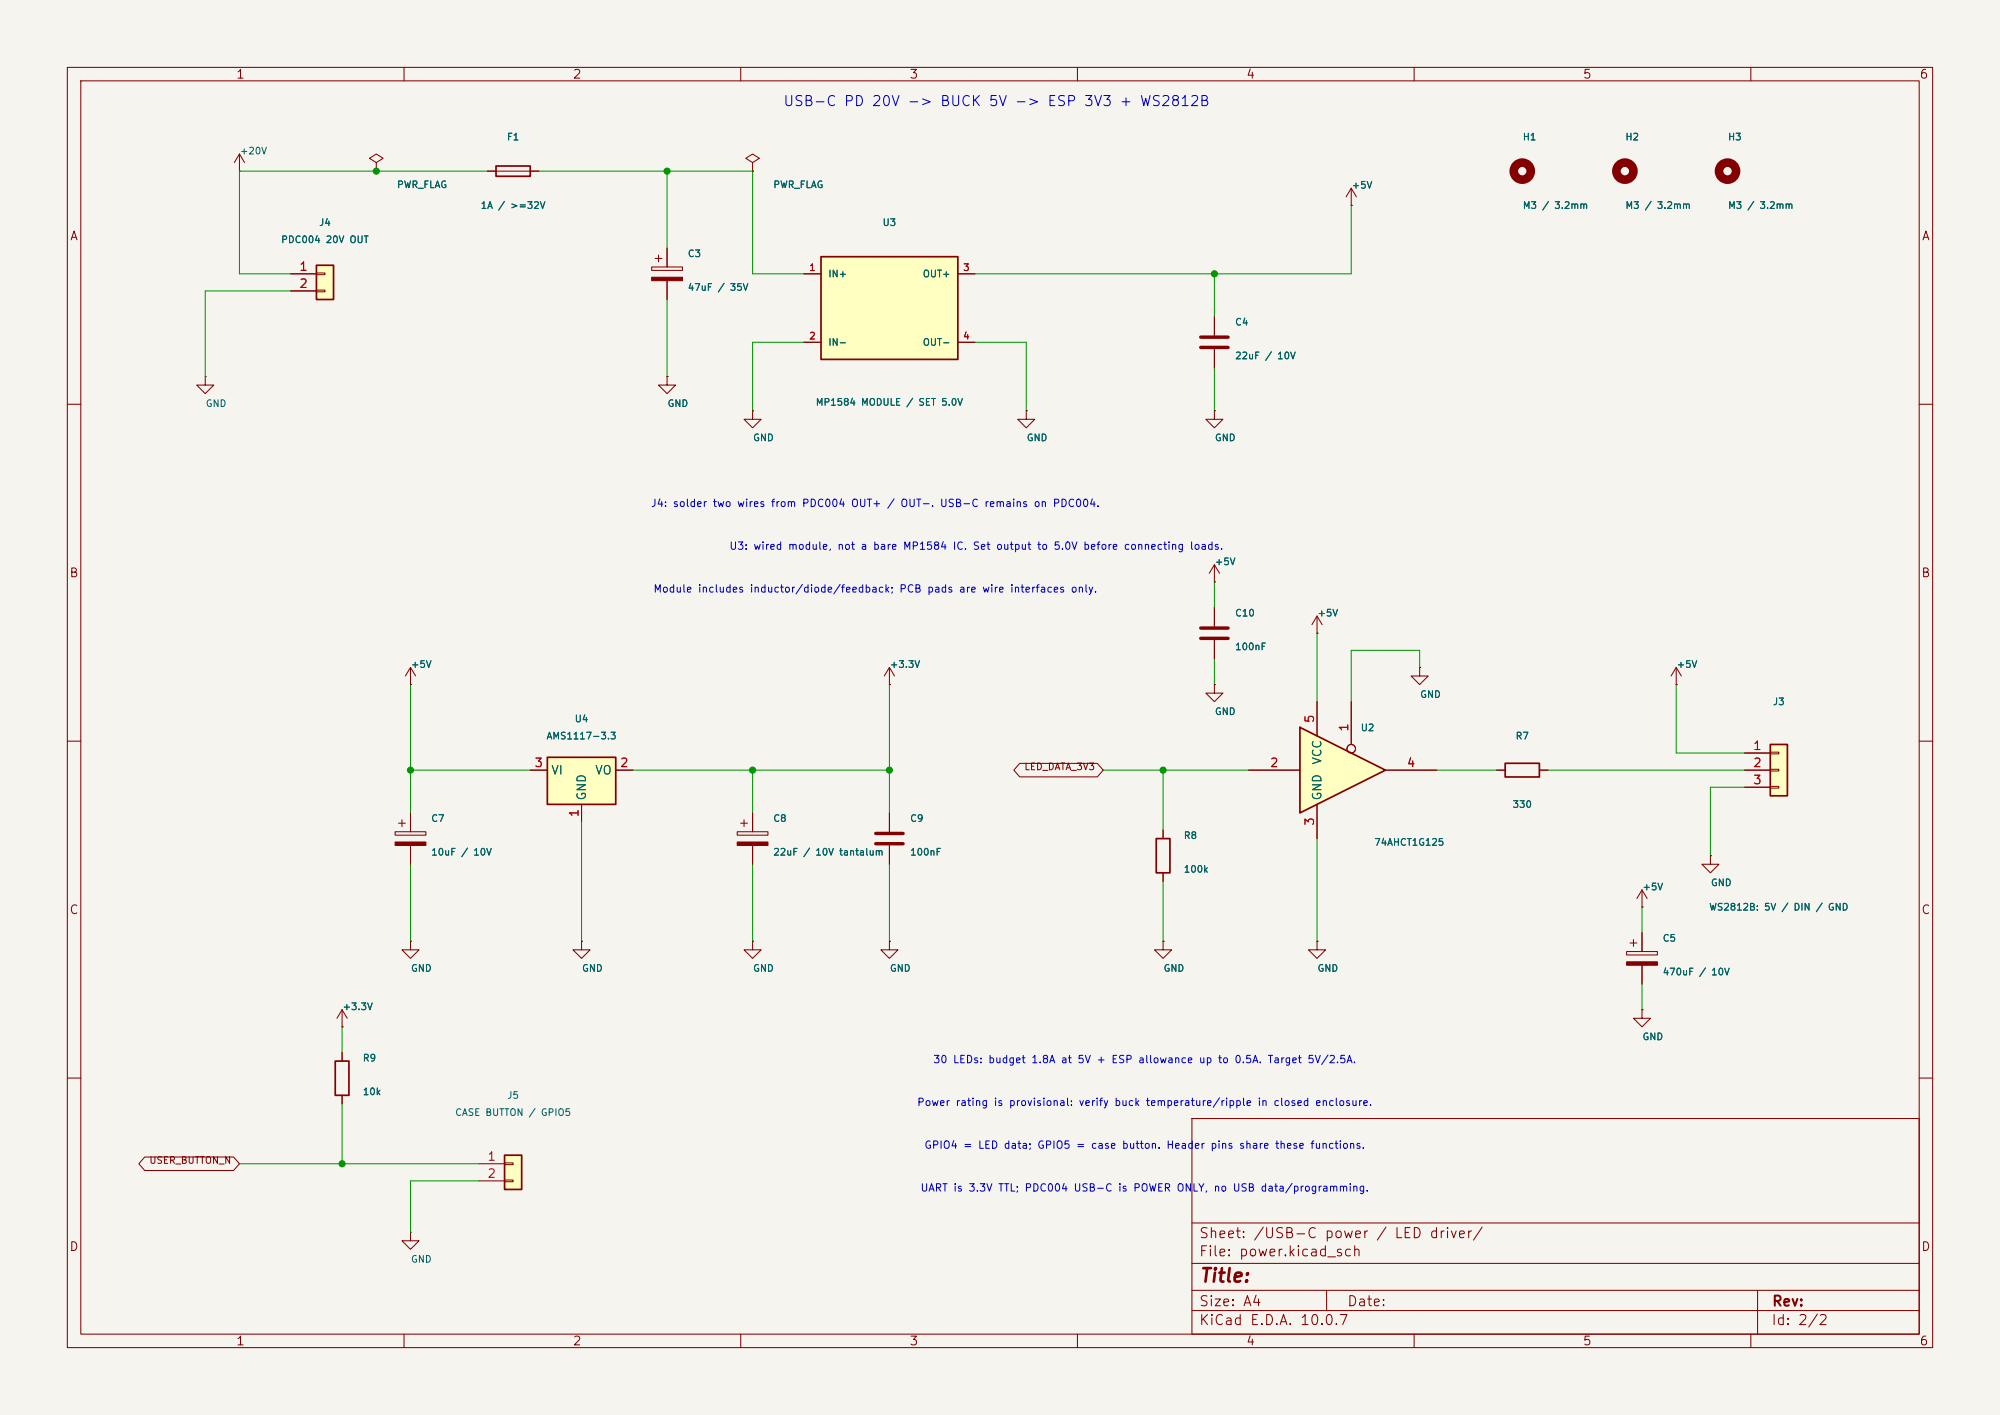
[picture p73: page 2]

USB-C PD 20V -> BUCK 5V -> ESP 3V3 + WS2812B

J4: solder two wires from PDC004 OUT+ / OUT-. USB-C remains on PDC004. Module includes inductor/diode/feedback; PCB pads are wire interfaces only. 30 LEDs: budget 1.8A at 5V + ESP allowance up to 0.5A. Target 5V/2.5A. U3: wired module, not a bare MP1584 IC. Set output to 5.0V before connecting loads. Power rating is provisional: verify buck temperature/ripple in closed enclosure. GPIO4 = LED data; GPIO5 = case button. Header pins share these functions. UART is 3.3V TTL; PDC004 USB-C is POWER ONLY, no USB data/programming.

Sheet: /USB-C power / LED driver/
File: power.kicad_sch
Title:

Size: A4 | Rev:
KiCad E.D.A. 10.0.7 | Id: 2/2
