widjis/rgb-sleep-lamp/electronic-design/revisions/3/schematic.pdf

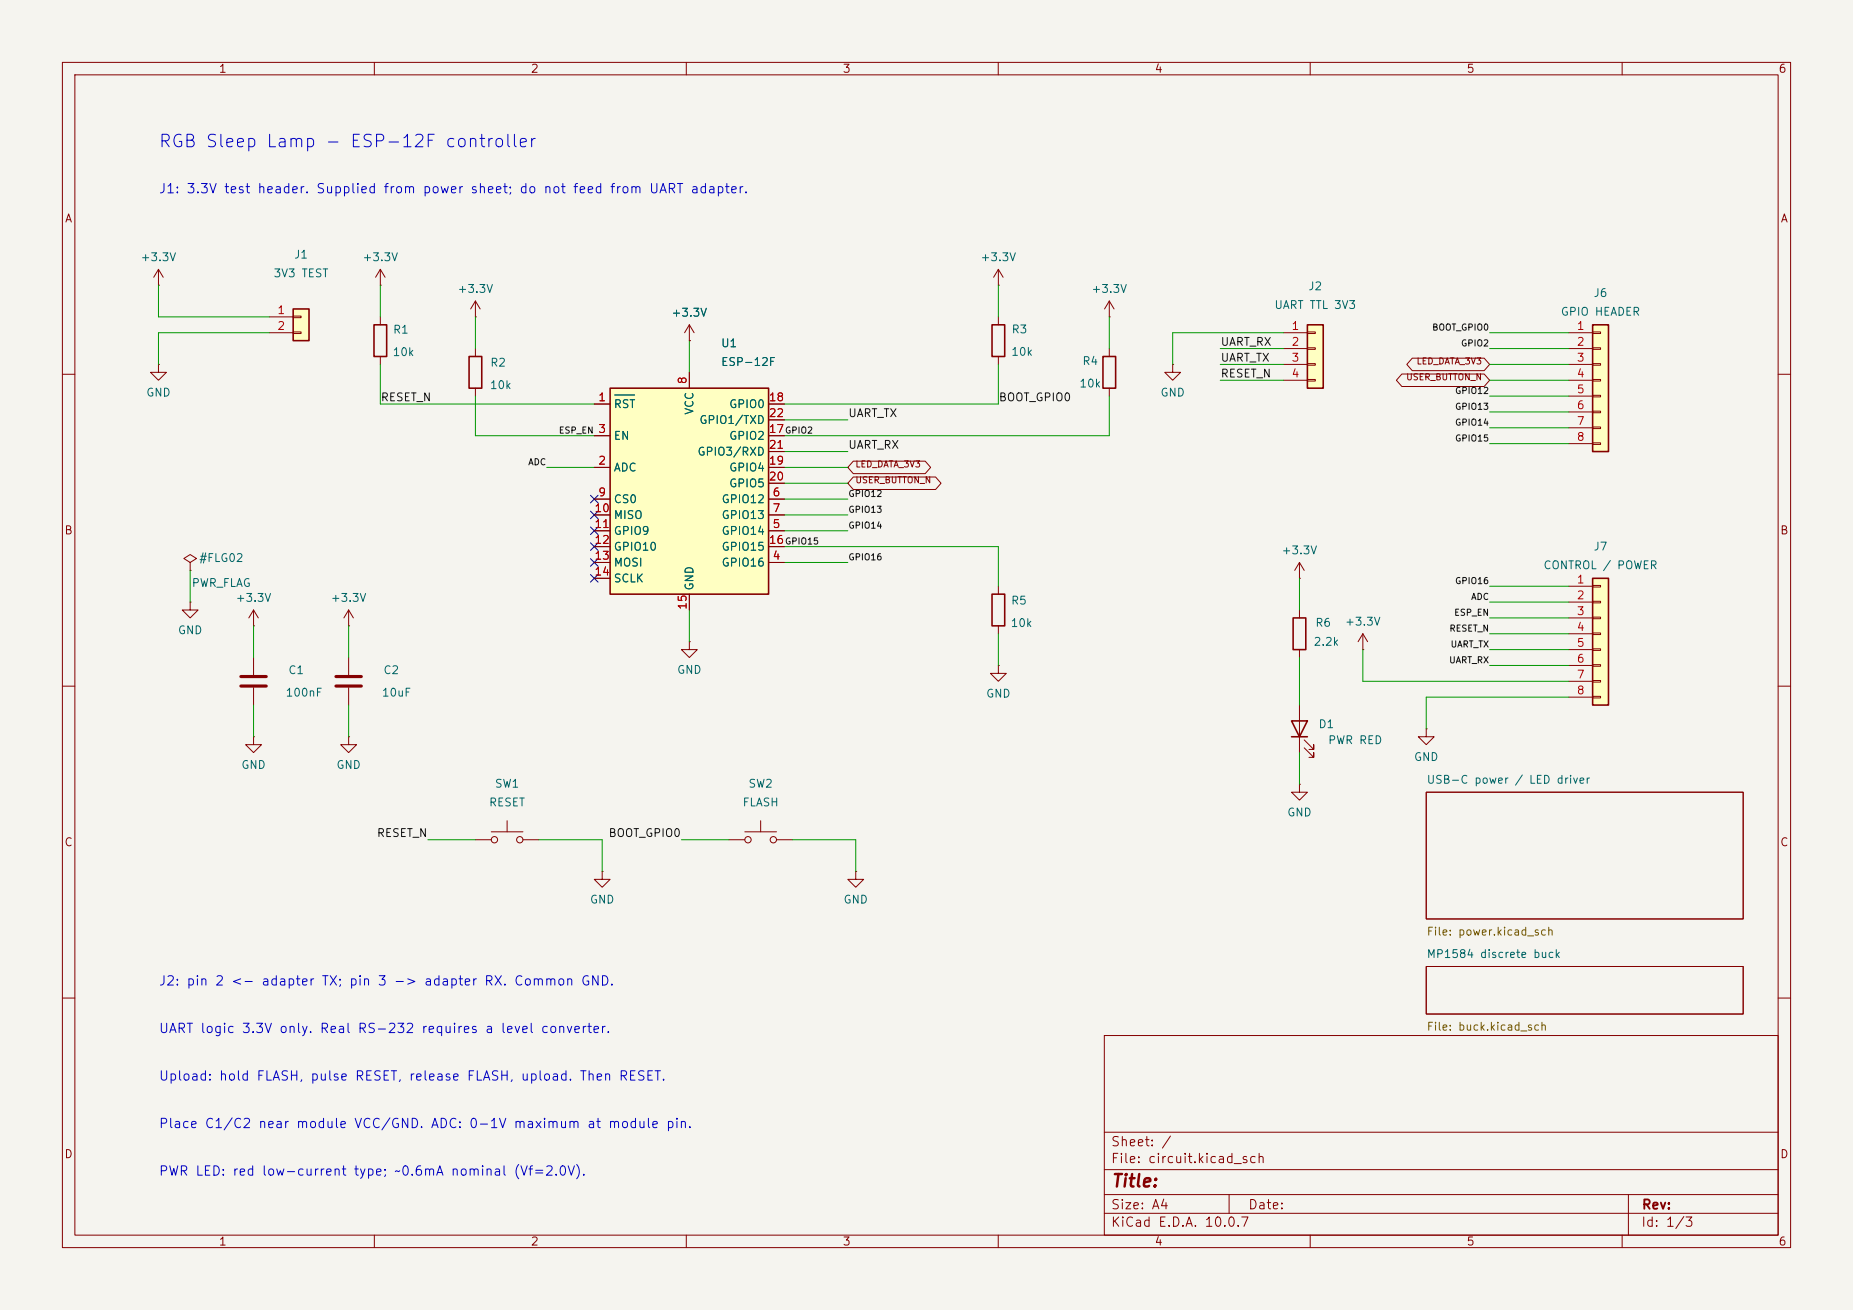
[picture p74: page 1]

RGB Sleep Lamp - ESP-12F controller

J1: 3.3V test header. Supplied from power sheet; do not feed from UART adapter.

MP1584 discrete buck File: buck.kicad_sch USB-C power / LED driver File: power.kicad_sch GND
GPIO15 RESET_N Place C1/C2 near module VCC/GND. ADC: 0-1V maximum at module pin.

J2: pin 2 <- adapter TX; pin 3 -> adapter RX. Common GND.

UART logic 3.3V only. Real RS-232 requires a level converter.

Upload: hold FLASH, pulse RESET, release FLASH, upload. Then RESET.

PWR LED: red low-current type; ~0.6mA nominal (Vf=2.0V).

Size: A4 | Rev:
KiCad E.D.A. 10.0.7 | Id: 1/3

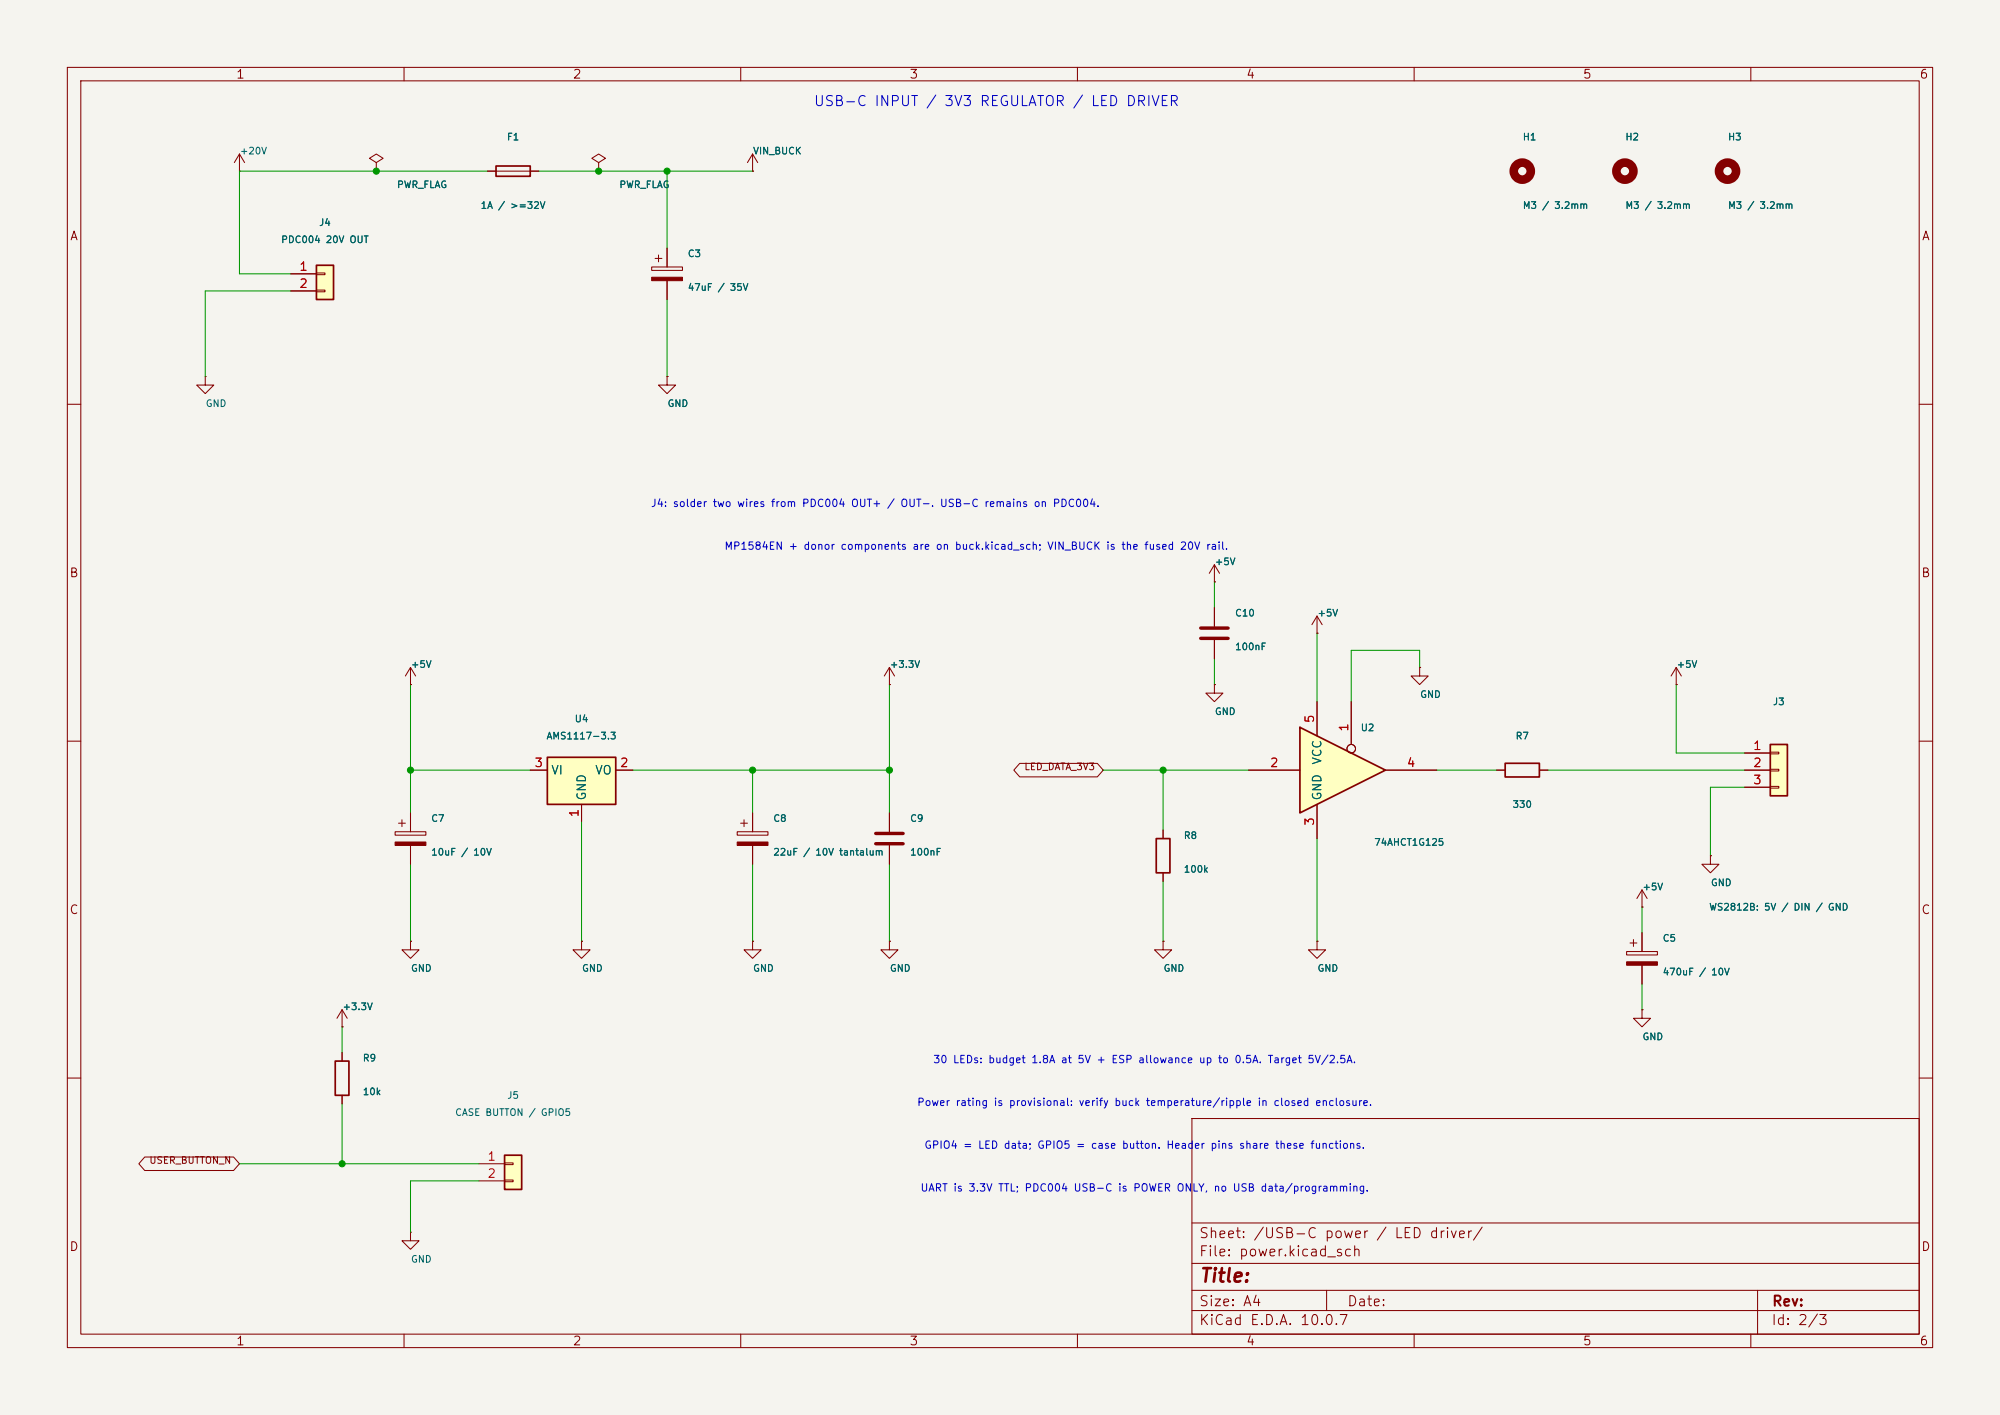
[picture p75: page 2]

USB-C INPUT / 3V3 REGULATOR / LED DRIVER

LED_DATA_3V3 30 LEDs: budget 1.8A at 5V + ESP allowance up to 0.5A. Target 5V/2.5A. Power rating is provisional: verify buck temperature/ripple in closed enclosure.

Sheet: /USB-C power / LED driver/
File: power.kicad_sch
Title:

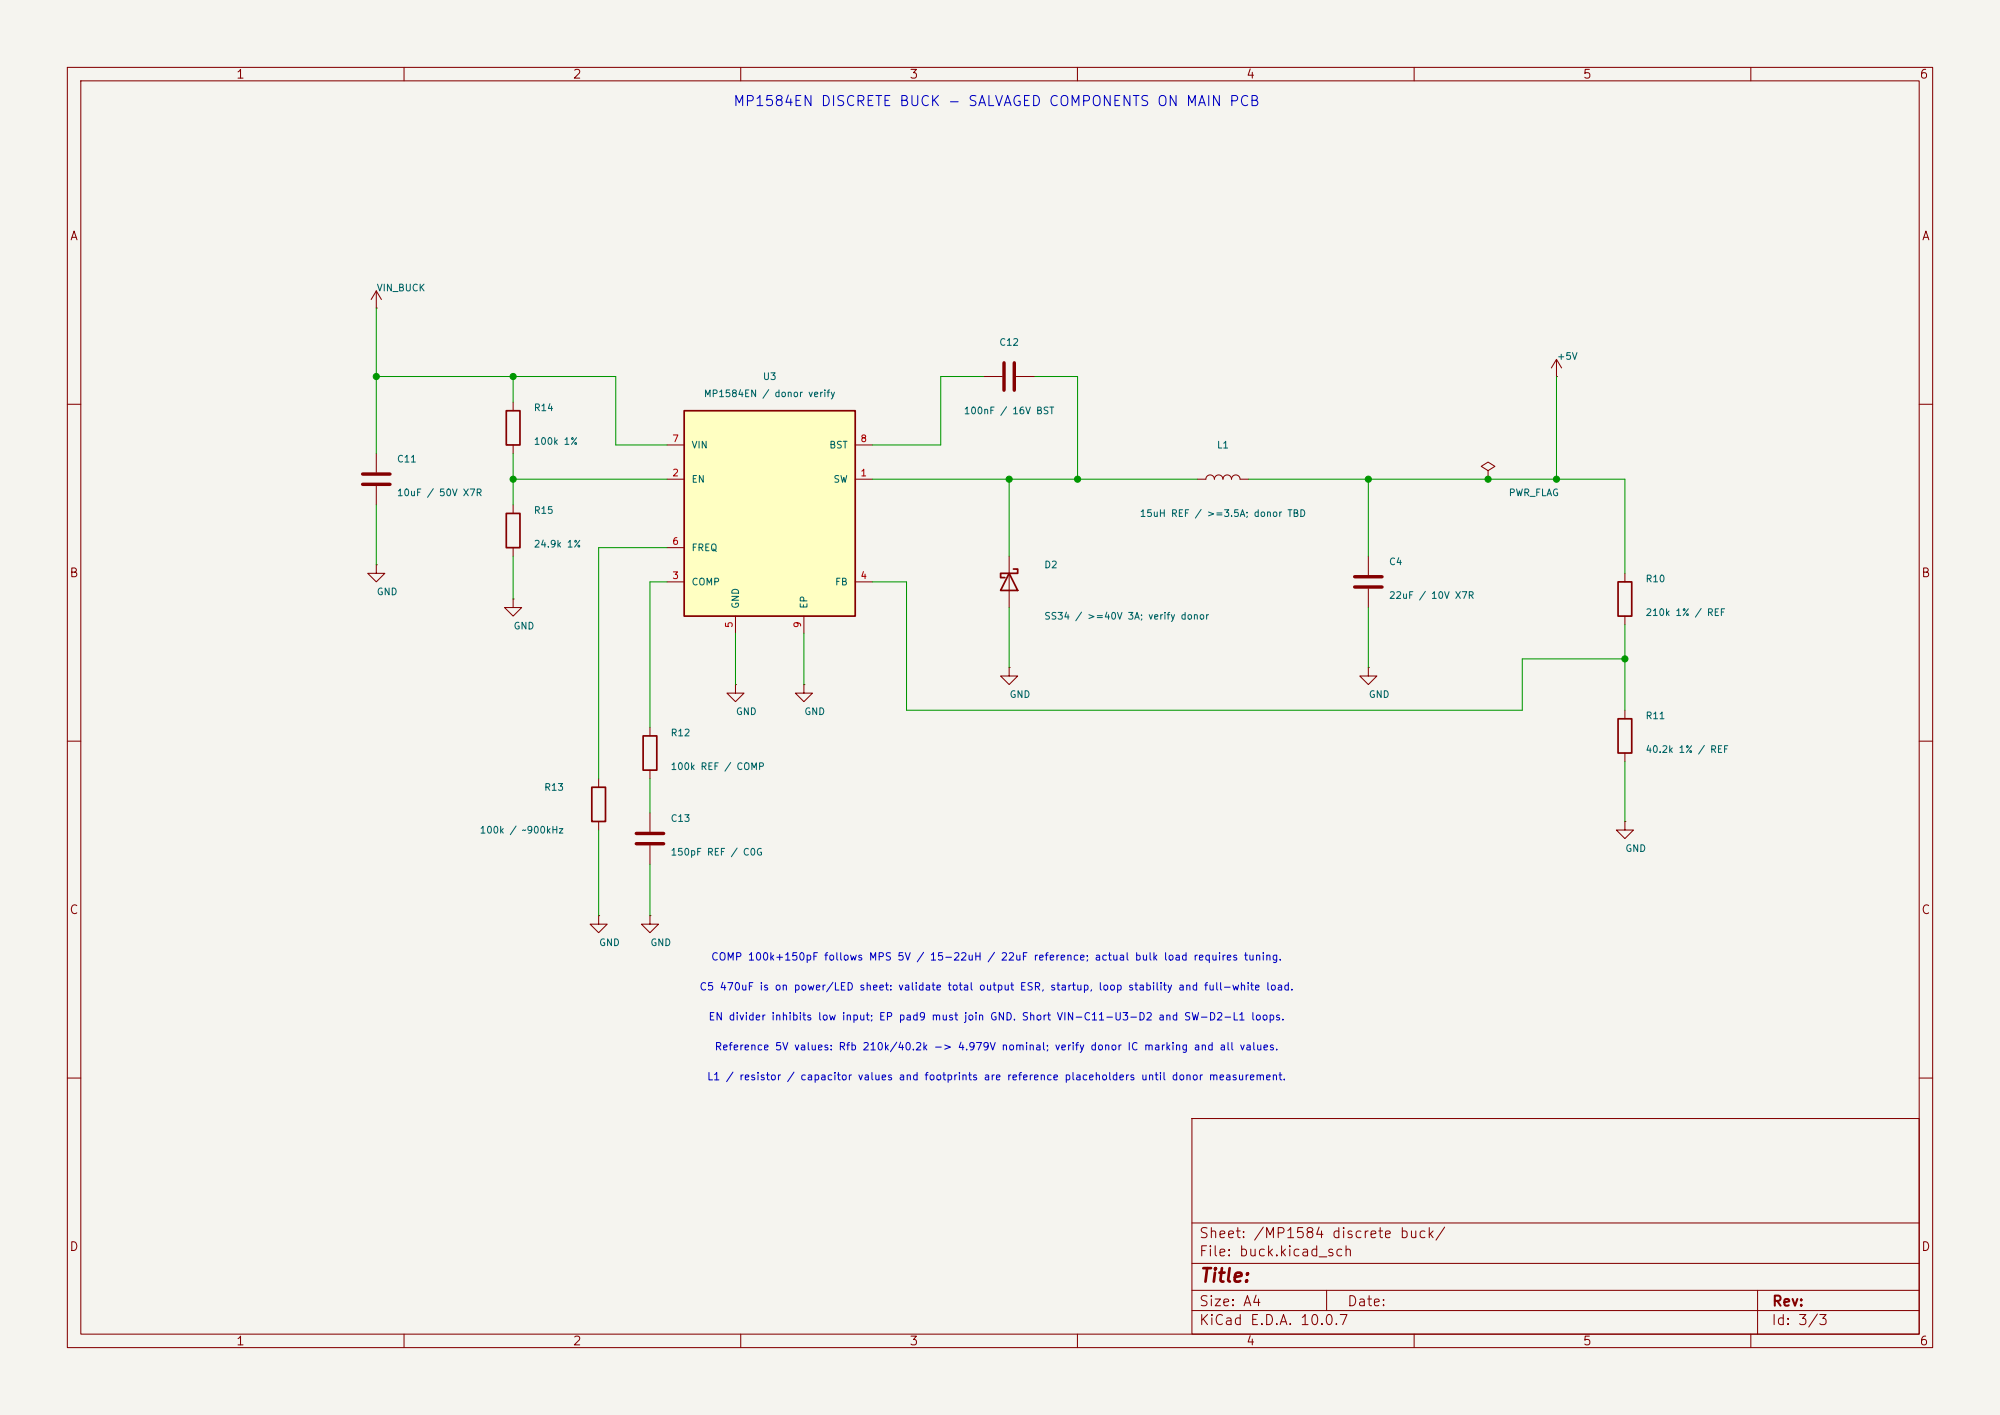
[picture p76: page 3]

MP1584EN DISCRETE BUCK - SALVAGED COMPONENTS ON MAIN PCB

EN divider inhibits low input; EP pad9 must join GND. Short VIN-C11-U3-D2 and SW-D2-L1 loops. L1 / resistor / capacitor values and footprints are reference placeholders until donor measurement. Reference 5V values: Rfb 210k/40.2k -> 4.979V nominal; verify donor IC marking and all values. C5 470uF is on power/LED sheet: validate total output ESR, startup, loop stability and full-white load. COMP 100k+150pF follows MPS 5V / 15-22uH / 22uF reference; actual bulk load requires tuning.
