widjis/rgb-sleep-lamp/(list of files, drawings)

Other design files:
documentation/checks/r9-pcb-and-led/pcb_mount_layout.json
electronic-design/revisions/1/schematic-pins.json
electronic-design/revisions/5/routing/circuit-e5-native.dsn
electronic-design/revisions/5/routing/circuit-e5-no-planes.dsn
mechanical/revisions/9/source/pcb_mount_layout.json
