widjis/rgb-sleep-lamp/electronic-design/revisions/4/circuit.kicad_pcb

## KiCad design electronic-design/revisions/4/circuit.kicad_pcb (2026-11-01)

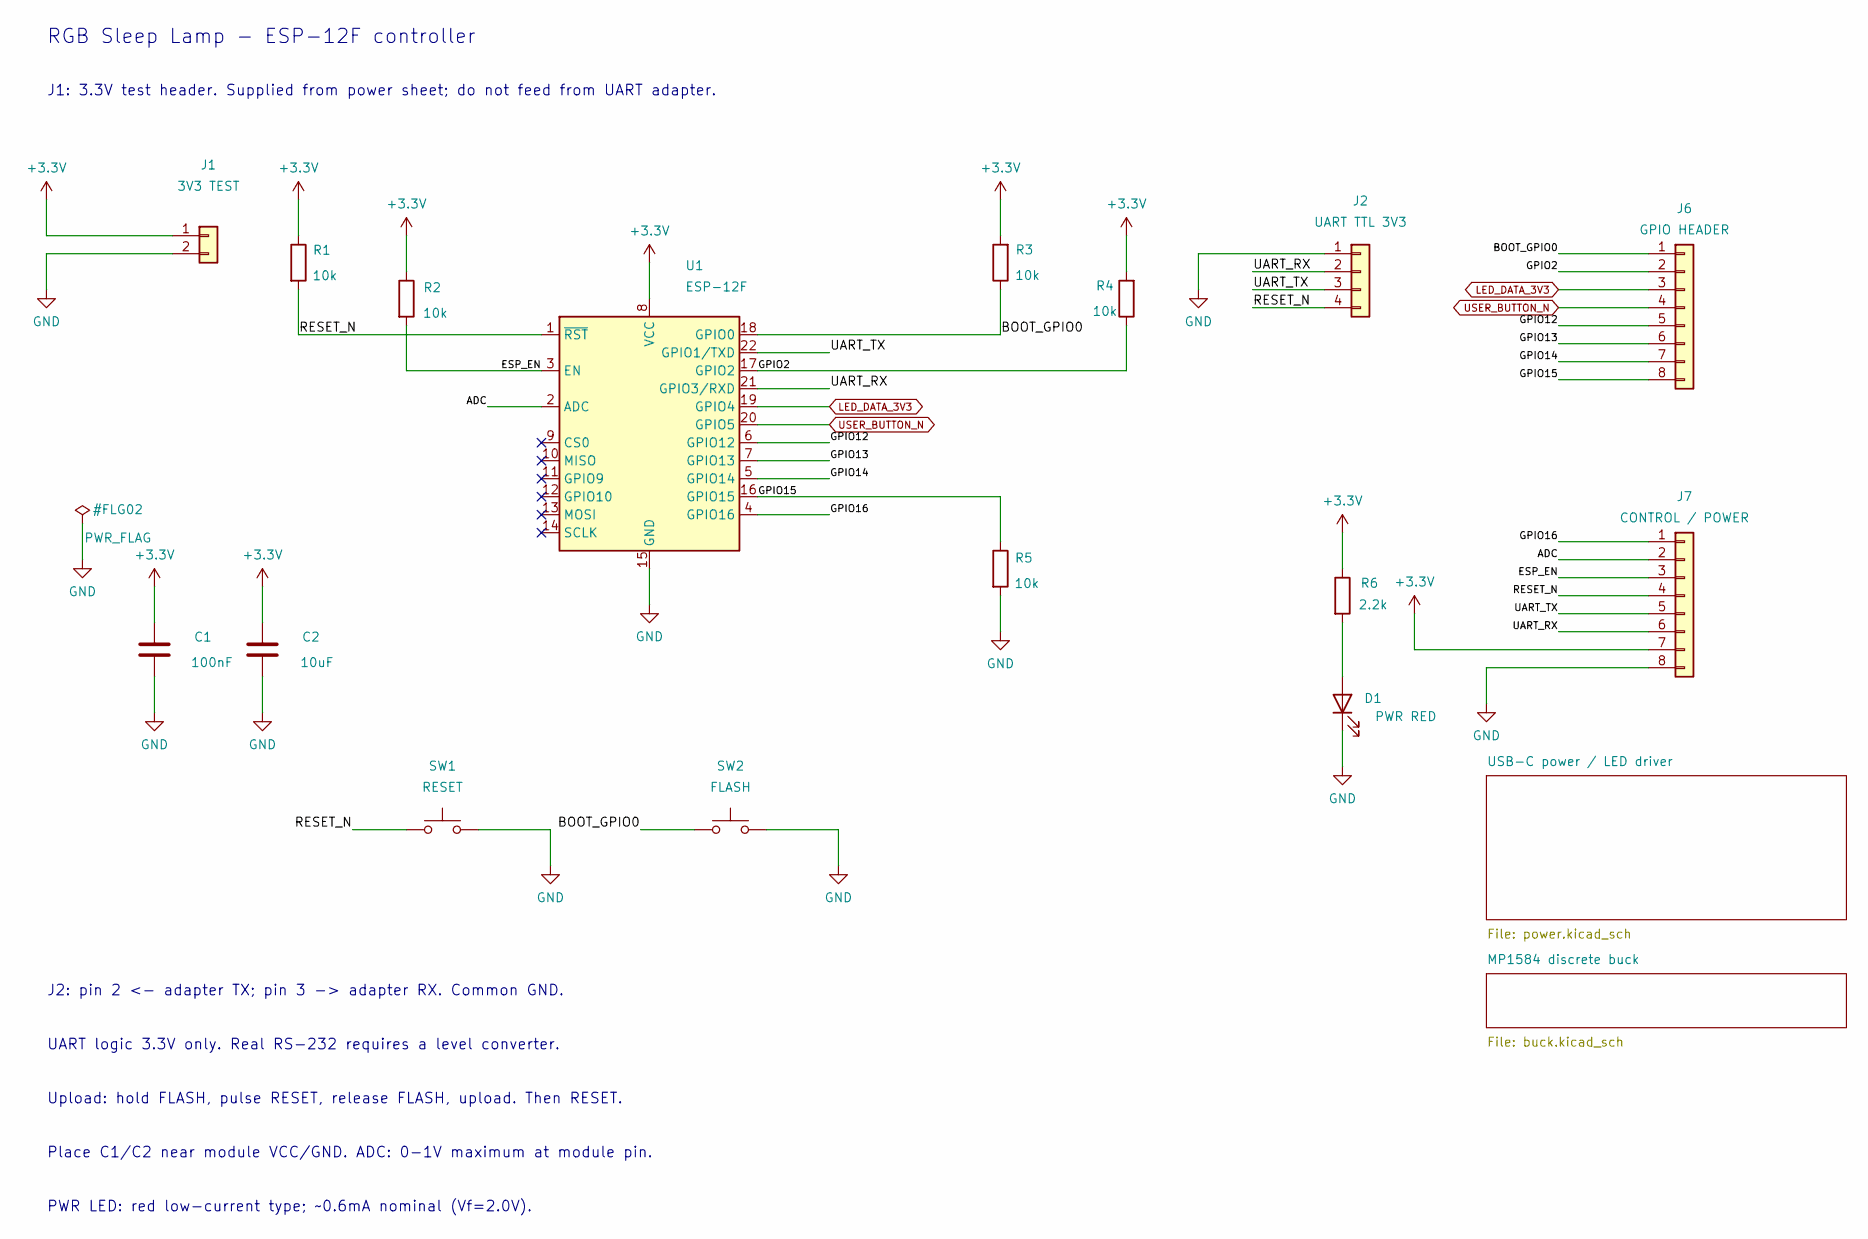
[picture p77: schematic circuit.kicad_sch]

Parts:
C1: 100nF; C_0805_2012Metric
C2: 10uF; C_0805_2012Metric
D1: PWR RED; LED_0805_2012Metric
J1: 3V3 TEST; PinHeader_1x02_P2.54mm_Vertical
J2: UART TTL 3V3; PinHeader_1x04_P2.54mm_Vertical
J6: GPIO HEADER; PinHeader_1x08_P2.54mm_Vertical
J7: CONTROL / POWER; PinHeader_1x08_P2.54mm_Vertical
R1, R2, R3, R4, R5: 10k; R_0805_2012Metric
R6: 2.2k; R_0805_2012Metric
SW1: RESET; SW_SPST_PTS645Sx43SMTR92
SW2: FLASH; SW_SPST_PTS645Sx43SMTR92
U1: ESP-12F; ESP-12F_AntennaOverhang

Connections:
+3.3V: C1.1, C2.1, J1.1, J7.7, R1.1, R2.1, R3.2, R4.2, R6.1, U1.8 (VCC); also elsewhere on the board
/ADC: J7.2, U1.2 (ADC)
/BOOT_GPIO0: J6.1, R3.1, SW2.1, U1.18 (GPIO0)
/ESP_EN: J7.3, R2.2, U1.3 (EN)
/GPIO2: J6.2, R4.1, U1.17 (GPIO2)
/GPIO12: J6.5, U1.6 (GPIO12)
/GPIO13: J6.6, U1.7 (GPIO13)
/GPIO14: J6.7, U1.5 (GPIO14)
/GPIO15: J6.8, R5.1, U1.16 (GPIO15)
/GPIO16: J7.1, U1.4 (GPIO16)
/RESET_N: J2.4, J7.4, R1.2, SW1.1, U1.1 (~RST)
/UART_RX: J2.2, J7.6, U1.21 (GPIO3/RXD)
/UART_TX: J2.3, J7.5, U1.22 (GPIO1/TXD)
GND: C1.2, C2.2, D1.1 (K), J1.2, J2.1, J7.8, R5.2, SW1.2, SW2.2, U1.15 (GND); also elsewhere on the board
LED_DATA_3V3: J6.3, U1.19 (GPIO4); also elsewhere on the board
unnamed: D1.2 (A), R6.2
USER_BUTTON_N: J6.4, U1.20 (GPIO5); also elsewhere on the board

Notes on the sheet:
J2: pin 2 <- adapter TX; pin 3 -> adapter RX. Common GND.
PWR LED: red low-current type; ~0.6mA nominal (Vf=2.0V).
UART logic 3.3V only. Real RS-232 requires a level converter.
Upload: hold FLASH, pulse RESET, release FLASH, upload. Then RESET.
Place C1/C2 near module VCC/GND. ADC: 0-1V maximum at module pin.
RGB Sleep Lamp - ESP-12F controller
J1: 3.3V test header. Supplied from power sheet; do not feed from UART adapter.

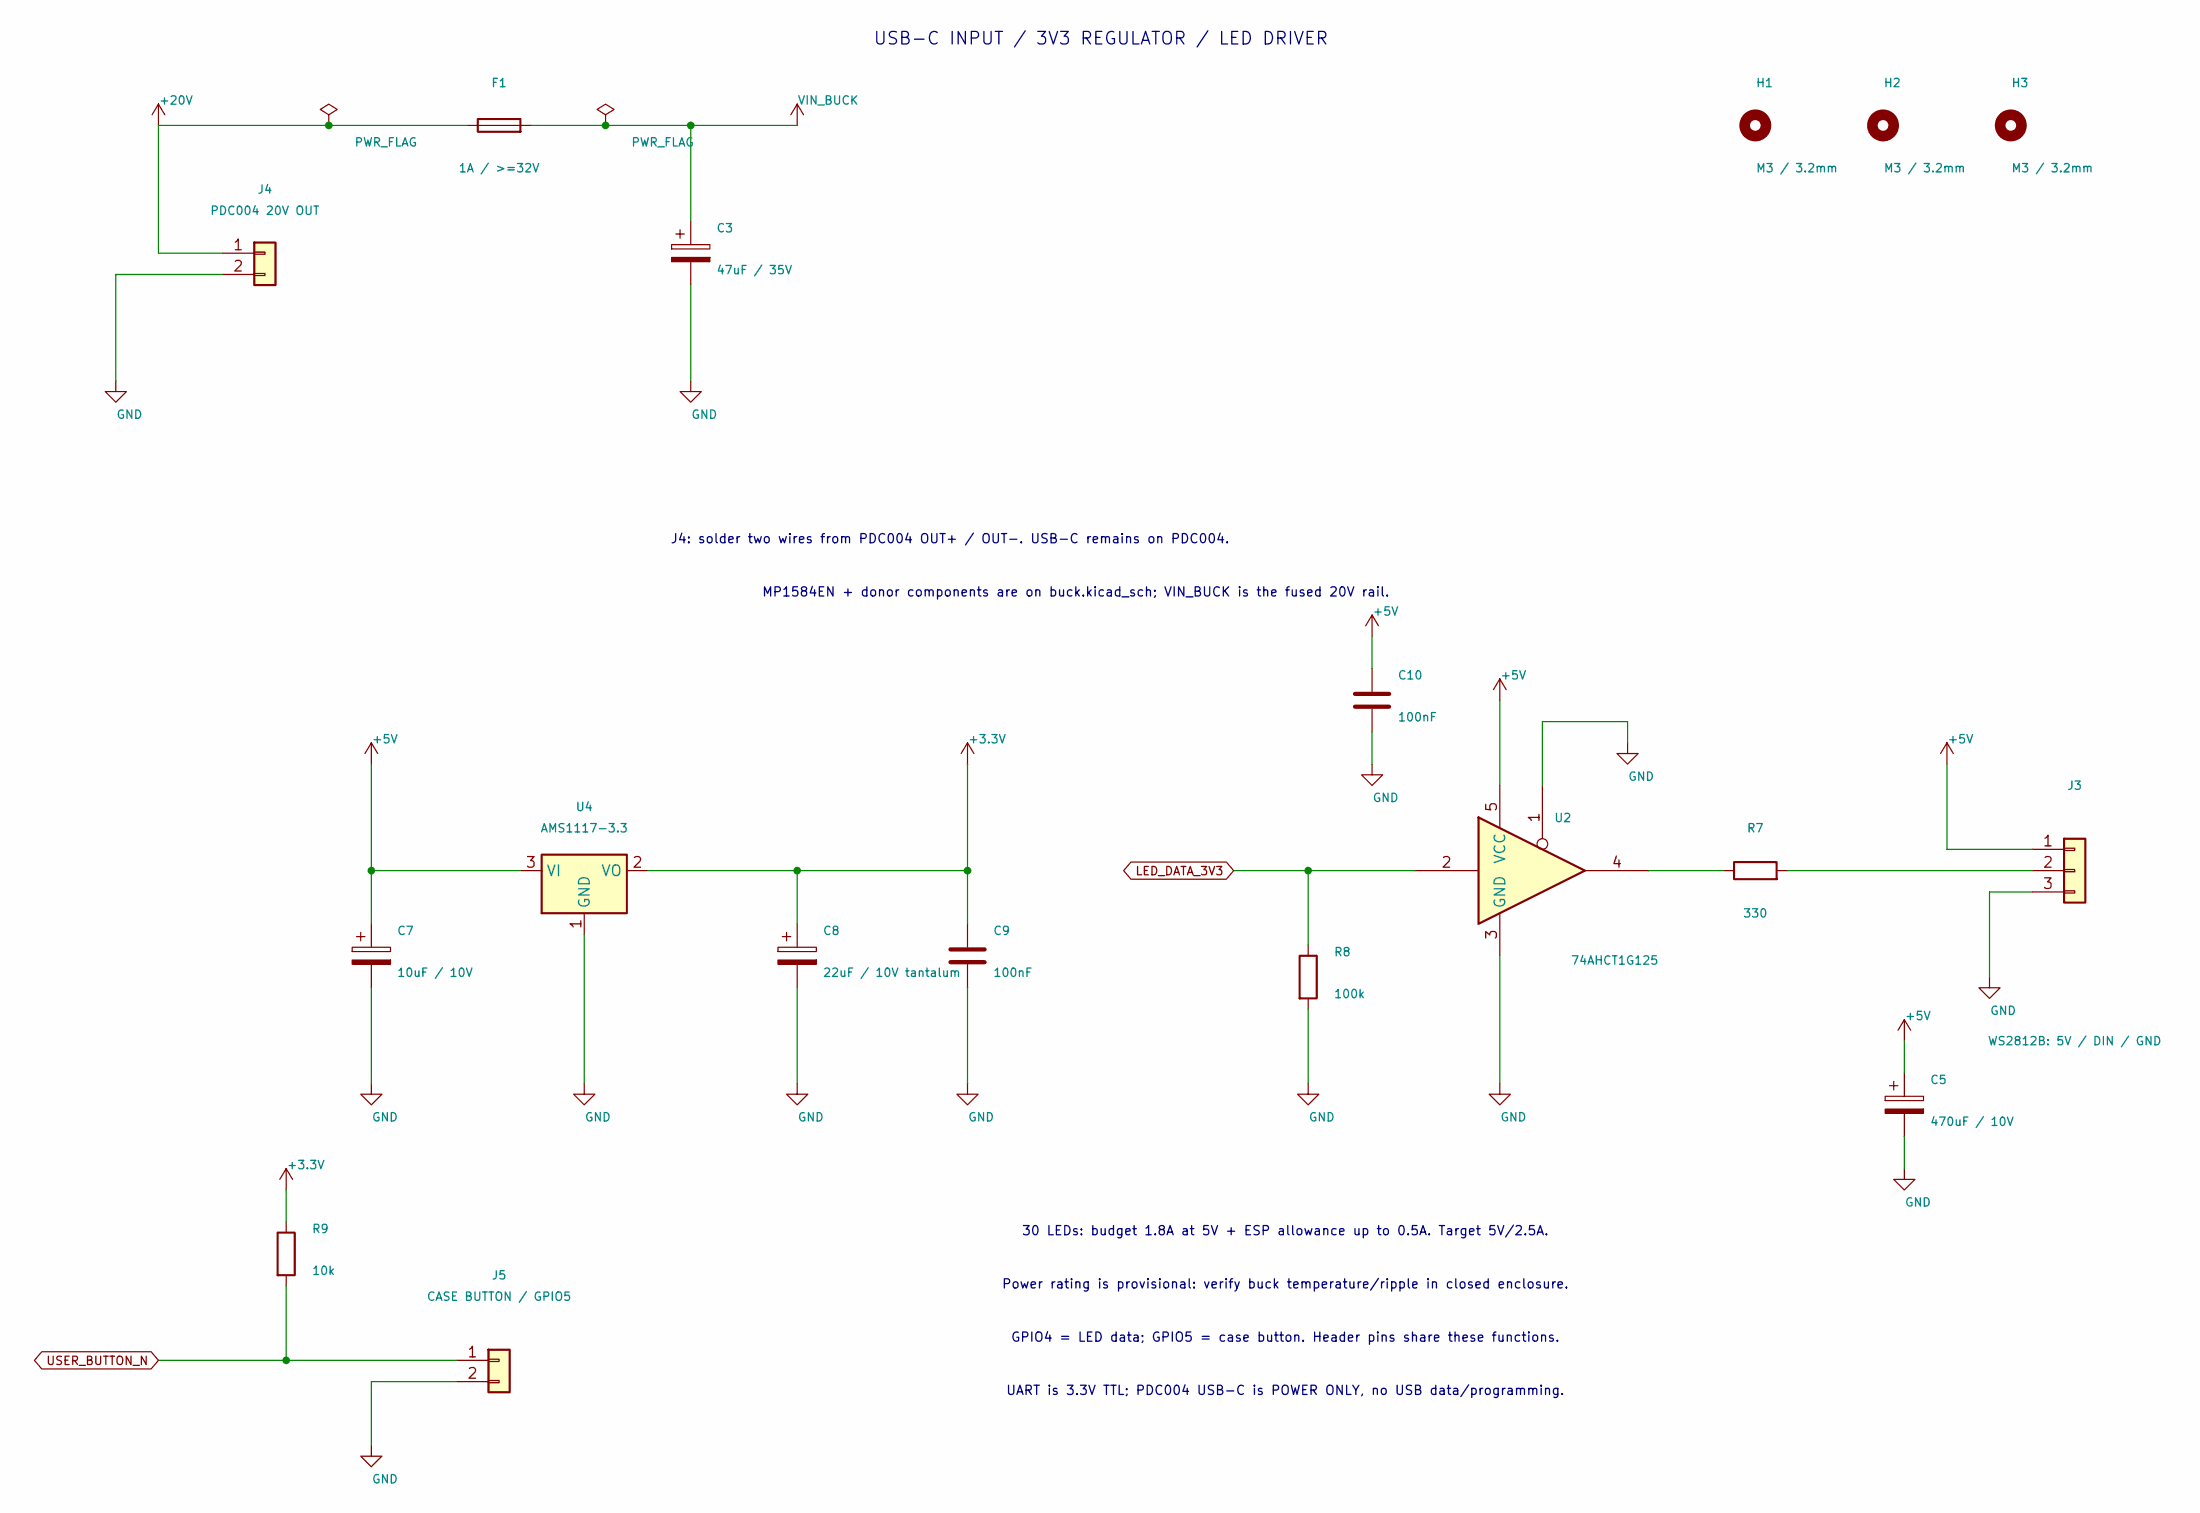
[picture p78: schematic power.kicad_sch]

Parts:
C3: 47uF / 35V; CP_Radial_D6.3mm_P2.50mm
C5: 470uF / 10V; CP_Radial_D8.0mm_P3.50mm
C7: 10uF / 10V; CP_Elec_5x5.4
C8: 22uF / 10V tantalum; CP_EIA-6032-28_Kemet-C
C9, C10: 100nF; C_0805_2012Metric
F1: 1A / >=32V; Fuse_1206_3216Metric
H1, H2, H3: M3 / 3.2mm; MountingHole_3.2mm_M3
J3: WS2812B: 5V / DIN / GND; LED_1x03_WirePads
J4: PDC004 20V OUT; PD20_1x02_WirePads
J5: CASE BUTTON / GPIO5; PinHeader_1x02_P2.54mm_Vertical
R7: 330; R_0805_2012Metric
R8: 100k; R_0805_2012Metric
R9: 10k; R_0805_2012Metric
U2: 74AHCT1G125; SOT-23-5
U4: AMS1117-3.3; SOT-223-3_TabPin2

Connections:
+3.3V: C8.1, C9.1, R9.1, U4.2 (VO); also elsewhere on the board
+5V: C5.1, C7.1, C10.1, J3.1, U2.5 (VCC), U4.3 (VI); also elsewhere on the board
+20V: F1.1, J4.1
GND: C3.2, C5.2, C7.2, C8.2, C9.2, C10.2, J3.3, J4.2, J5.2, R8.2, U2.1, U2.3 (GND), U4.1 (GND); also elsewhere on the board
LED_DATA_3V3: R8.1, U2.2; also elsewhere on the board
unnamed: J3.2, R7.2
unnamed: R7.1, U2.4
USER_BUTTON_N: J5.1, R9.2; also elsewhere on the board
VIN_BUCK: C3.1, F1.2; also elsewhere on the board

Notes on the sheet:
GPIO4 = LED data; GPIO5 = case button. Header pins share these functions.
MP1584EN + donor components are on buck.kicad_sch; VIN_BUCK is the fused 20V rail.
30 LEDs: budget 1.8A at 5V + ESP allowance up to 0.5A. Target 5V/2.5A.
USB-C INPUT / 3V3 REGULATOR / LED DRIVER
UART is 3.3V TTL; PDC004 USB-C is POWER ONLY, no USB data/programming.
J4: solder two wires from PDC004 OUT+ / OUT-. USB-C remains on PDC004.
Power rating is provisional: verify buck temperature/ripple in closed enclosure.

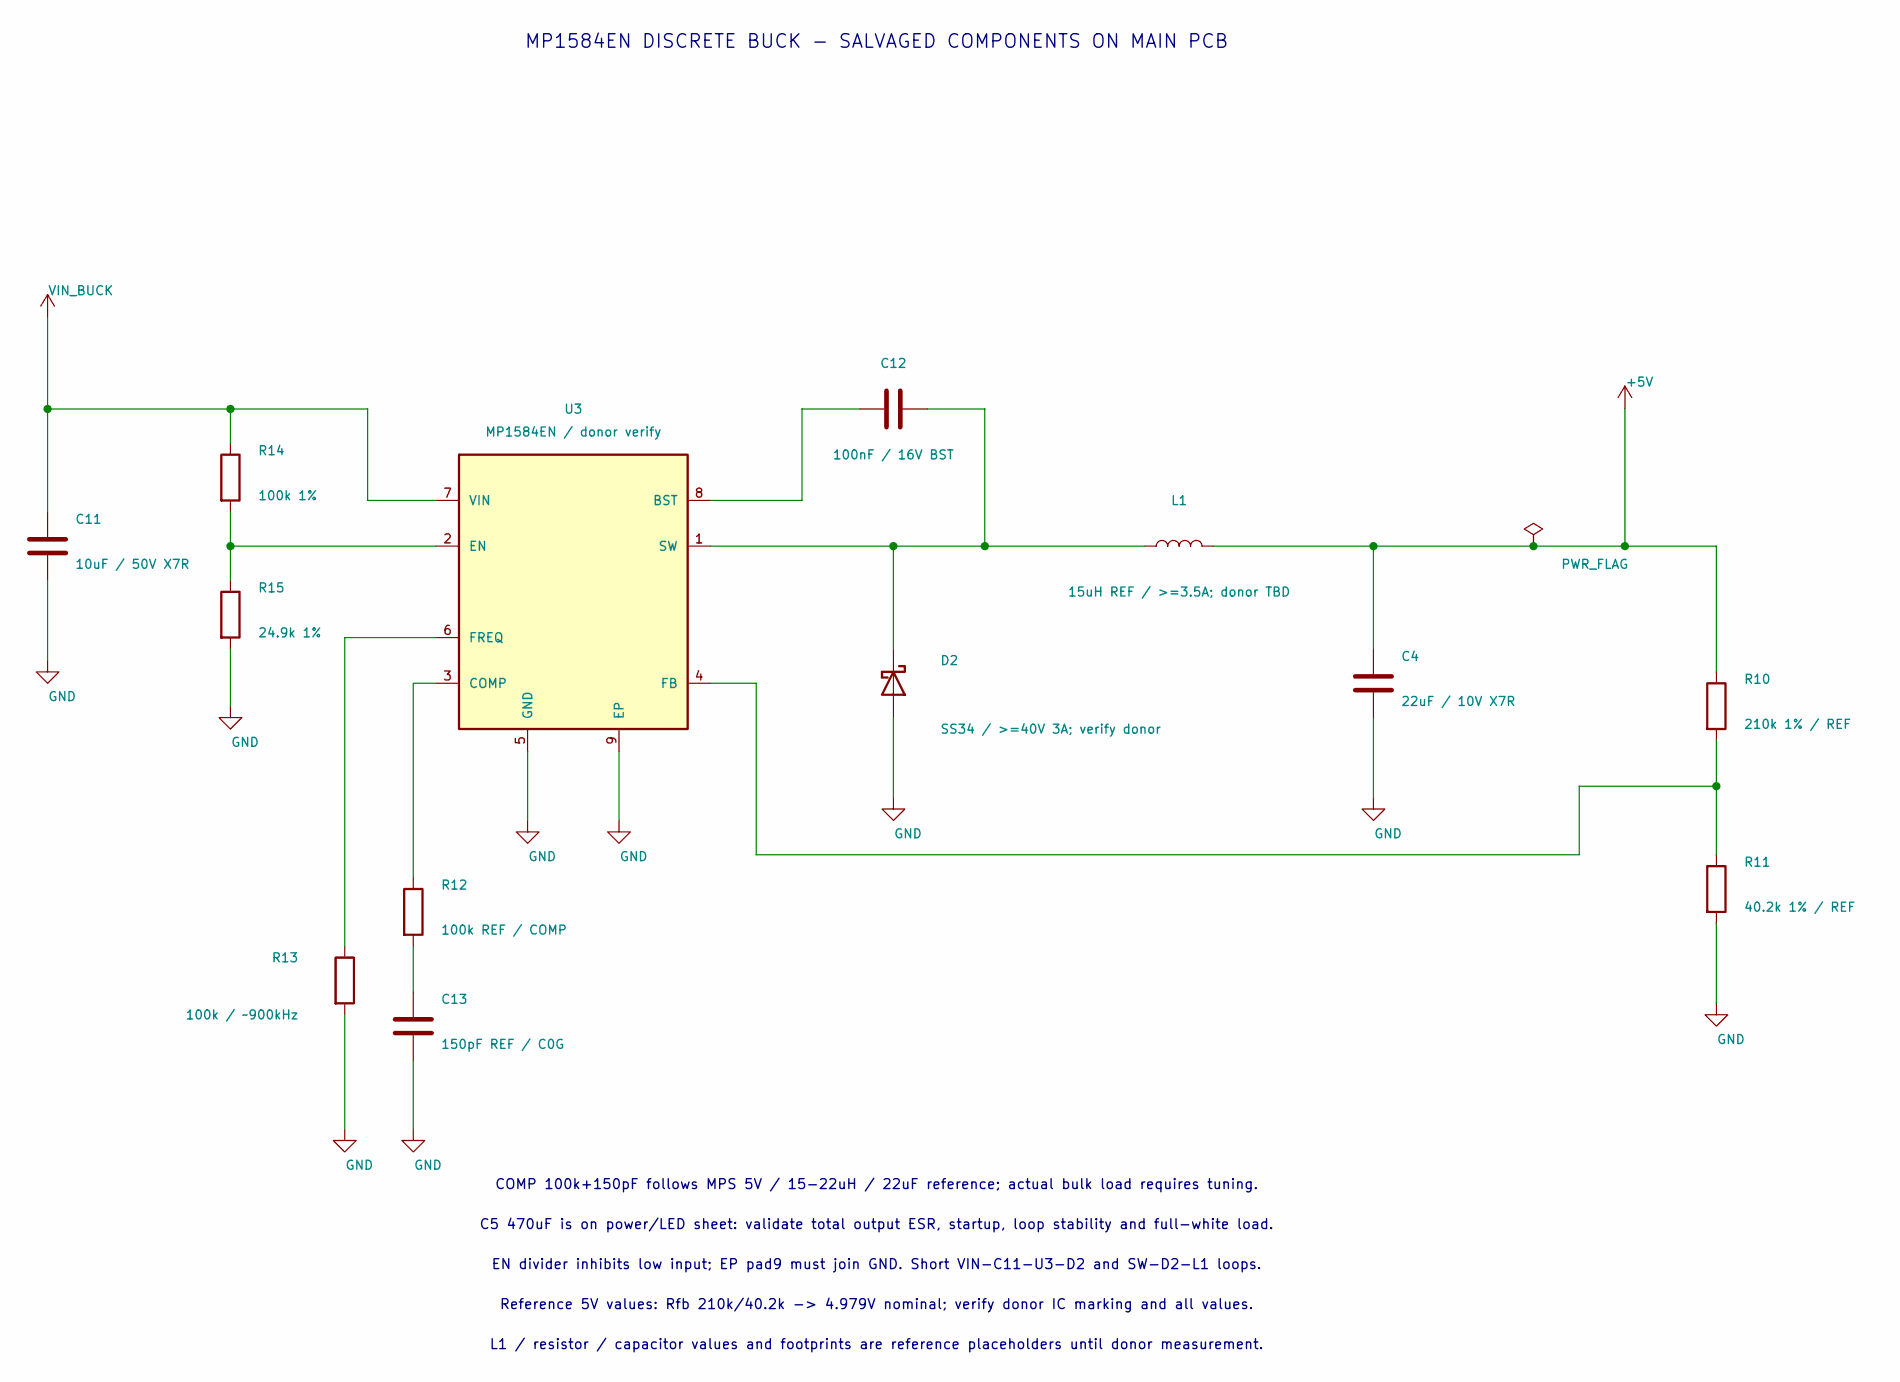
[picture p79: schematic buck.kicad_sch]

Parts:
C4: 22uF / 10V X7R; C_1210_3225Metric
C11: 10uF / 50V X7R; C_1210_3225Metric
C12: 100nF / 16V BST; C_0805_2012Metric
C13: 150pF REF / C0G; C_0805_2012Metric
D2: SS34 / >=40V 3A; verify donor; D_SMA
L1: 15uH REF / >=3.5A; donor TBD; L_Bourns_SRP1245A
R10: 210k 1% / REF; R_0805_2012Metric
R11: 40.2k 1% / REF; R_0805_2012Metric
R12: 100k REF / COMP; R_0805_2012Metric
R13: 100k / ~900kHz; R_0805_2012Metric
R14: 100k 1%; R_0805_2012Metric
R15: 24.9k 1%; R_0805_2012Metric
U3: MP1584EN / donor verify; MP1584EN_SOIC8E_0603CLR

Connections:
+5V: C4.1, L1.2, R10.1; also elsewhere on the board
GND: C4.2, C11.2, C13.2, D2.2 (A), R11.2, R13.2, R15.2, U3.5 (GND), U3.9 (EP); also elsewhere on the board
unnamed: C13.1, R12.2
unnamed: C12.2, D2.1 (K), L1.1, U3.1 (SW)
unnamed: C12.1, U3.8 (BST)
unnamed: R12.1, U3.3 (COMP)
unnamed: R14.2, R15.1, U3.2 (EN)
unnamed: R10.2, R11.1, U3.4 (FB)
unnamed: R13.1, U3.6 (FREQ)
VIN_BUCK: C11.1, R14.1, U3.7 (VIN); also elsewhere on the board

Notes on the sheet:
COMP 100k+150pF follows MPS 5V / 15-22uH / 22uF reference; actual bulk load requires tuning.
C5 470uF is on power/LED sheet: validate total output ESR, startup, loop stability and full-white load.
MP1584EN DISCRETE BUCK - SALVAGED COMPONENTS ON MAIN PCB
EN divider inhibits low input; EP pad9 must join GND. Short VIN-C11-U3-D2 and SW-D2-L1 loops.
Reference 5V values: Rfb 210k/40.2k -> 4.979V nominal; verify donor IC marking and all values.
L1 / resistor / capacitor values and footprints are reference placeholders until donor measurement.

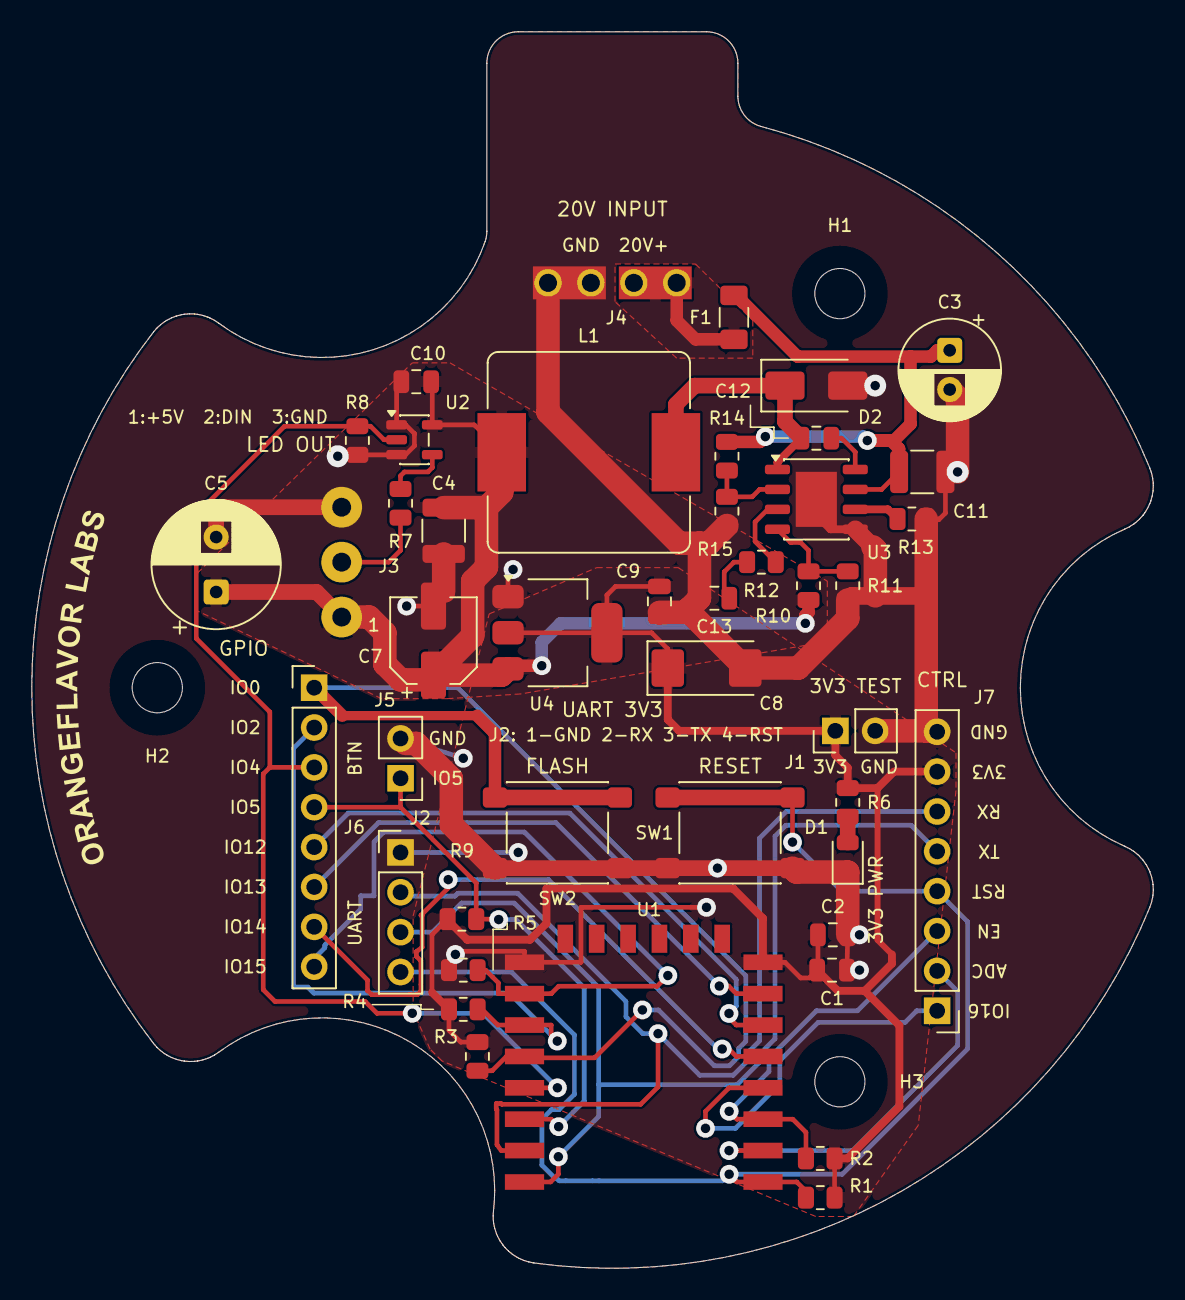
[picture p80: board circuit.kicad_pcb from above]

Board: 2 copper layers, 71.5 x 78.8 mm, 47 parts (0 on the bottom side), 29 nets.
