widjis/rgb-sleep-lamp/(commit log)

2026-11-01 Import RGB Sleep Lamp mechanical designs and electronics E1-E5
    [BaseChamferReview.FCStd, C_0805_2012Metric.step, GPS Tracker.kicad_pcb, GPS Tracker.kicad_sch, LED_0805_2012Metric.step, L_SRP1245A_reference.FCStd, L_SRP1245A_reference.step, NativeAssemblyTest.FCStd]
2026-11-01 Show mechanical assembly previews in README
