widjis/rgb-sleep-lamp/(notices)

Notices in the files:
electronic-design/revisions/5/models/PinHeader_1x08_P2.54mm_Vertical.step:
Copyright (C) 2017, kicad StepUp
This work is licensed under the [Creative Commons CC-BY-SA 4.0 License](https://creativecommons.org/licenses/by-sa/4.0/legalcode),
with the following exception:
To the extent that the creation of electronic designs that use 'Licensed Material' can be considered to be 'Adapted Material',
You are free to use the library data in your own projects without the obligation to share your project files under this or any other license agreement.
electronic-design/revisions/5/models/R_0805_2012Metric.step:
Copyright (C) 2018, kicad StepUp
electronic-design/revisions/5/models/SOIC-8-1EP_3.9x4.9mm_P1.27mm_EP2.41x3.81mm.step:
Copyright (C) 2025, KiCAD
This work is licensed under the
[Creative Commons CC-BY-SA 4.0 License](https://creativecommons.org/licenses/by-sa/4.0/legalcode),
project files under this or any other license agreement. However, if you wish to distribute
